Kgotso-Koete/pilomar/docs/OBSOLETE_Legacy_Bill_of_Materials.pdf

Source | | R1,409.70

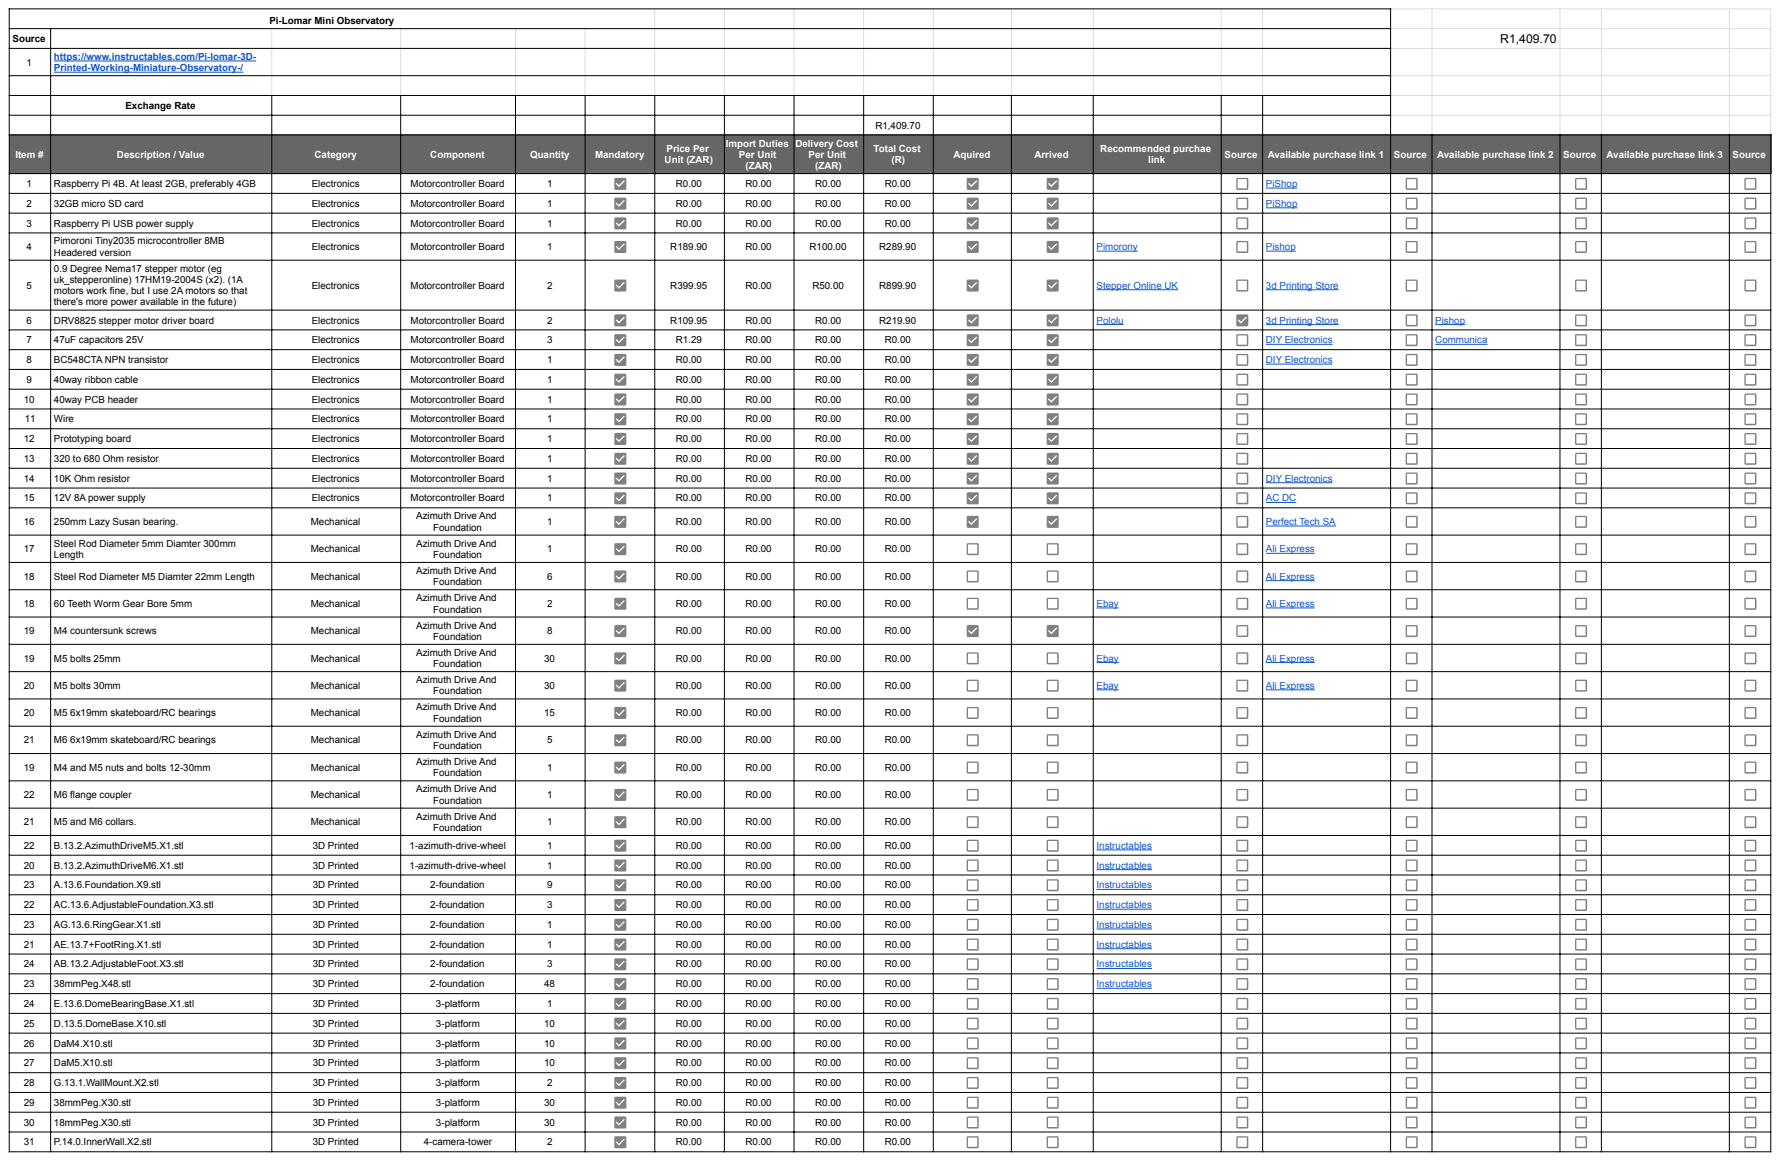
[picture p1: page 1]

Pi-Lomar Mini Observatory

1 | https://www.instructables.com/Pi-lomar-3D- Printed-Working-Miniature-Observatory-/

Exchange Rate

Item # | Description / Value | Category | Component | Quantity | Mandatory | Price Per Unit (ZAR) | Import Duties Per Unit (ZAR) | Delivery Cost Per Unit (ZAR) | Total Cost (R) | Aquired | Arrived | Recommended purchae link | Source | Available purchase link 1 | Source | Available purchase link 2 | Source | Available purchase link 3 | Source

1 | Raspberry Pi 4B. At least 2GB, preferably 4GB | Electronics | Motorcontroller Board | 1 | | R0.00 | R0.00 | R0.00 | R0.00 | | | | | PiShop (https://www.pishop.co.za/store/raspberry-pi-4-model-b-4gb?keyword=raspberry%20pi%204%204%20gb&category_id=0)

2 | 32GB micro SD card | Electronics | Motorcontroller Board | 1 | | R0.00 | R0.00 | R0.00 | R0.00 | | | | | PiShop (https://www.pishop.co.za/store/sandisk-ultra-microsdhc-32gb-uhs-i-100mbs-class10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)

3 | Raspberry Pi USB power supply | Electronics | Motorcontroller Board | 1 | | R0.00 | R0.00 | R0.00 | R0.00
4 | Pimoroni Tiny2035 microcontroller 8MB Headered version | Electronics | Motorcontroller Board | 1 | | R189.90 | R0.00 | R100.00 | R289.90 | | | Pimorony (https://shop.pimoroni.com/products/tiny-2040?variant=39560012267603) | | Pishop (https://www.pishop.co.za/store/tiny-2350-by-pimoroni?key=3528)

5 | 0.9 Degree Nema17 stepper motor (eg uk_stepperonline) 17HM19-2004S (x2). (1A motors work fine, but I use 2A motors so that there's more power available in the future) | Electronics | Motorcontroller Board | 2 | | R399.95 | R0.00 | R50.00 | R899.90 | | | Stepper Online UK (https://www.stepperonline.co.uk/nema-17-bipolar-0-9deg-46ncm-65-1oz-in-2a-42x42x48mm-4-wires-17hm19-2004s.html) | | 3d Printing Store (https://3dprintingstore.co.za/products/stepper-motor-nema-17-x-48mm-0-9-deg-step)

6 | DRV8825 stepper motor driver board | Electronics | Motorcontroller Board | 2 | | R109.95 | R0.00 | R0.00 | R219.90 | | | Pololu (https://www.pololu.com/product/2133) | | 3d Printing Store (https://3dprintingstore.co.za/products/stepper-motor-driver-drv8825-with-heat-sink?_pos=1&_sid=9cb2bcf2d&_ss=r) | | Pishop (https://www.pishop.co.za/store/3d-printer-stepstick-drv8825-stepper-motor-driver)

7 | 47uF capacitors 25V | Electronics | Motorcontroller Board | 3 | | R1.29 | R0.00 | R0.00 | R0.00 | | | | | DIY Electronics (https://www.diyelectronics.co.za/store/capacitors/4124-47uf-25v-electrolytic-capacitor.html) | | Communica (https://www.communica.co.za/products/47uf-25ves6-3x5-4)

8 | BC548CTA NPN transistor | Electronics | Motorcontroller Board | 1 | | R0.00 | R0.00 | R0.00 | R0.00 | | | | | DIY Electronics (https://www.diyelectronics.co.za/store/prototyping/6129-bc547b-npn-general-purpose-transistor-100ma-45v.html)

9 | 40way ribbon cable | Electronics | Motorcontroller Board | 1 | | R0.00 | R0.00 | R0.00 | R0.00

10 | 40way PCB header | Electronics | Motorcontroller Board | 1 | | R0.00 | R0.00 | R0.00 | R0.00

11 | Wire | Electronics | Motorcontroller Board | 1 | | R0.00 | R0.00 | R0.00 | R0.00

12 | Prototyping board | Electronics | Motorcontroller Board | 1 | | R0.00 | R0.00 | R0.00 | R0.00

13 | 320 to 680 Ohm resistor | Electronics | Motorcontroller Board | 1 | | R0.00 | R0.00 | R0.00 | R0.00

14 | 10K Ohm resistor | Electronics | Motorcontroller Board | 1 | | R0.00 | R0.00 | R0.00 | R0.00 | | | | | DIY Electronics (https://www.diyelectronics.co.za/store/resistors/1582-resistor-10k-ohm-14w-5.html)

15 | 12V 8A power supply | Electronics | Motorcontroller Board | 1 | | R0.00 | R0.00 | R0.00 | R0.00 | | | | | AC DC (https://acdc.co.za/batteries-chargers-power-supplies-avrs-upss/31475-mains-psu-230vac-12vdc-8a-b-plug-10va.html)
16 | 250mm Lazy Susan bearing. | Mechanical | Azimuth Drive And Foundation | 1 | | R0.00 | R0.00 | R0.00 | R0.00 | | | | | Perfect Tech SA (https://perfecttech.co.za/product/metal-swivel-turn-plate-for-rotating-table/)

17 | Steel Rod Diameter 5mm Diamter 300mm Length | Mechanical | Azimuth Drive And Foundation | 1 | | R0.00 | R0.00 | R0.00 | R0.00 | | | | | Ali Express (http://aliexpress.com/item/1005009347568195.html?mp=1)

18 | Steel Rod Diameter M5 Diamter 22mm Length | Mechanical | Azimuth Drive And Foundation | 6 | | R0.00 | R0.00 | R0.00 | R0.00 | | | | | Ali Express (https://www.aliexpress.com/item/1005009021799814.html?mp=1)

18 | 60 Teeth Worm Gear Bore 5mm | Mechanical | Azimuth Drive And Foundation | 2 | | R0.00 | R0.00 | R0.00 | R0.00 | | | Ebay (https://www.ebay.co.uk/itm/305751282028) | | Ali Express (https://www.aliexpress.com/item/1005009021799814.html?curPageLogUid=dJdaDykwoOhg)

19 | M4 countersunk screws | Mechanical | Azimuth Drive And Foundation | 8 | | R0.00 | R0.00 | R0.00 | R0.00

19 | M5 bolts 25mm | Mechanical | Azimuth Drive And Foundation | 30 | | R0.00 | R0.00 | R0.00 | R0.00 | | | Ebay (https://www.ebay.co.uk/itm/321232365051) | | Ali Express (https://www.aliexpress.com/item/1005006713197144.html?scm_id=1007.40050.354490.0&scm-url=1007.40050.354490.0)

20 | M5 bolts 30mm | Mechanical | Azimuth Drive And Foundation | 30 | | R0.00 | R0.00 | R0.00 | R0.00 | | | Ebay (https://www.ebay.co.uk/itm/321232365051) | | Ali Express (https://www.aliexpress.com/item/1005006713197144.html?scm_id=1007.40050.354490.0&scm-url=1007.40050.354490.0)

20 | M5 6x19mm skateboard/RC bearings | Mechanical | Azimuth Drive And Foundation | 15 | | R0.00 | R0.00 | R0.00 | R0.00

21 | M6 6x19mm skateboard/RC bearings | Mechanical | Azimuth Drive And Foundation | 5 | | R0.00 | R0.00 | R0.00 | R0.00

19 | M4 and M5 nuts and bolts 12-30mm | Mechanical | Azimuth Drive And Foundation | 1 | | R0.00 | R0.00 | R0.00 | R0.00

22 | M6 flange coupler | Mechanical | Azimuth Drive And Foundation | 1 | | R0.00 | R0.00 | R0.00 | R0.00

21 | M5 and M6 collars. | Mechanical | Azimuth Drive And Foundation | 1 | | R0.00 | R0.00 | R0.00 | R0.00

22 | B.13.2.AzimuthDriveM5.X1.stl | 3D Printed | 1-azimuth-drive-wheel | 1 | | R0.00 | R0.00 | R0.00 | R0.00 | | | Instructables (https://content.instructables.com/F7O/A6UB/LD33SM68/F7OA6UBLD33SM68.stl)

20 | B.13.2.AzimuthDriveM6.X1.stl | 3D Printed | 1-azimuth-drive-wheel | 1 | | R0.00 | R0.00 | R0.00 | R0.00 | | | Instructables (https://content.instructables.com/FKP/K26I/LD33SM69/FKPK26ILD33SM69.stl)

23 | A.13.6.Foundation.X9.stl | 3D Printed | 2-foundation | 9 | | R0.00 | R0.00 | R0.00 | R0.00 | | | Instructables (https://content.instructables.com/FZG/956D/LD33SM5Z/FZG956DLD33SM5Z.stl)

22 | AC.13.6.AdjustableFoundation.X3.stl | 3D Printed | 2-foundation | 3 | | R0.00 | R0.00 | R0.00 | R0.00 | | | Instructables (https://content.instructables.com/FTZ/H02S/LD33SM65/FTZH02SLD33SM65.stl)

23 | AG.13.6.RingGear.X1.stl | 3D Printed | 2-foundation | 1 | | R0.00 | R0.00 | R0.00 | R0.00 | | | Instructables (https://content.instructables.com/F95/JYJI/LD33SM67/F95JYJILD33SM67.stl)

21 | AE.13.7+FootRing.X1.stl | 3D Printed | 2-foundation | 1 | | R0.00 | R0.00 | R0.00 | R0.00 | | | Instructables (https://content.instructables.com/FTZ/H02S/LD33SM65/FTZH02SLD33SM65.stl)

24 | AB.13.2.AdjustableFoot.X3.stl | 3D Printed | 2-foundation | 3 | | R0.00 | R0.00 | R0.00 | R0.00 | | | Instructables (https://content.instructables.com/FGK/MHMJ/LD33SM61/FGKMHMJLD33SM61.stl)

23 | 38mmPeg.X48.stl | 3D Printed | 2-foundation | 48 | | R0.00 | R0.00 | R0.00 | R0.00 | | | Instructables (https://content.instructables.com/FC5/TMM4/LD33SM5Y/FC5TMM4LD33SM5Y.stl)

24 | E.13.6.DomeBearingBase.X1.stl | 3D Printed | 3-platform | 1 | | R0.00 | R0.00 | R0.00 | R0.00

25 | D.13.5.DomeBase.X10.stl | 3D Printed | 3-platform | 10 | | R0.00 | R0.00 | R0.00 | R0.00

26 | DaM4.X10.stl | 3D Printed | 3-platform | 10 | | R0.00 | R0.00 | R0.00 | R0.00

27 | DaM5.X10.stl | 3D Printed | 3-platform | 10 | | R0.00 | R0.00 | R0.00 | R0.00

28 | G.13.1.WallMount.X2.stl | 3D Printed | 3-platform | 2 | | R0.00 | R0.00 | R0.00 | R0.00

29 | 38mmPeg.X30.stl | 3D Printed | 3-platform | 30 | | R0.00 | R0.00 | R0.00 | R0.00

30 | 18mmPeg.X30.stl | 3D Printed | 3-platform | 30 | | R0.00 | R0.00 | R0.00 | R0.00

31 | P.14.0.InnerWall.X2.stl | 3D Printed | 4-camera-tower | 2 | | R0.00 | R0.00 | R0.00 | R0.00

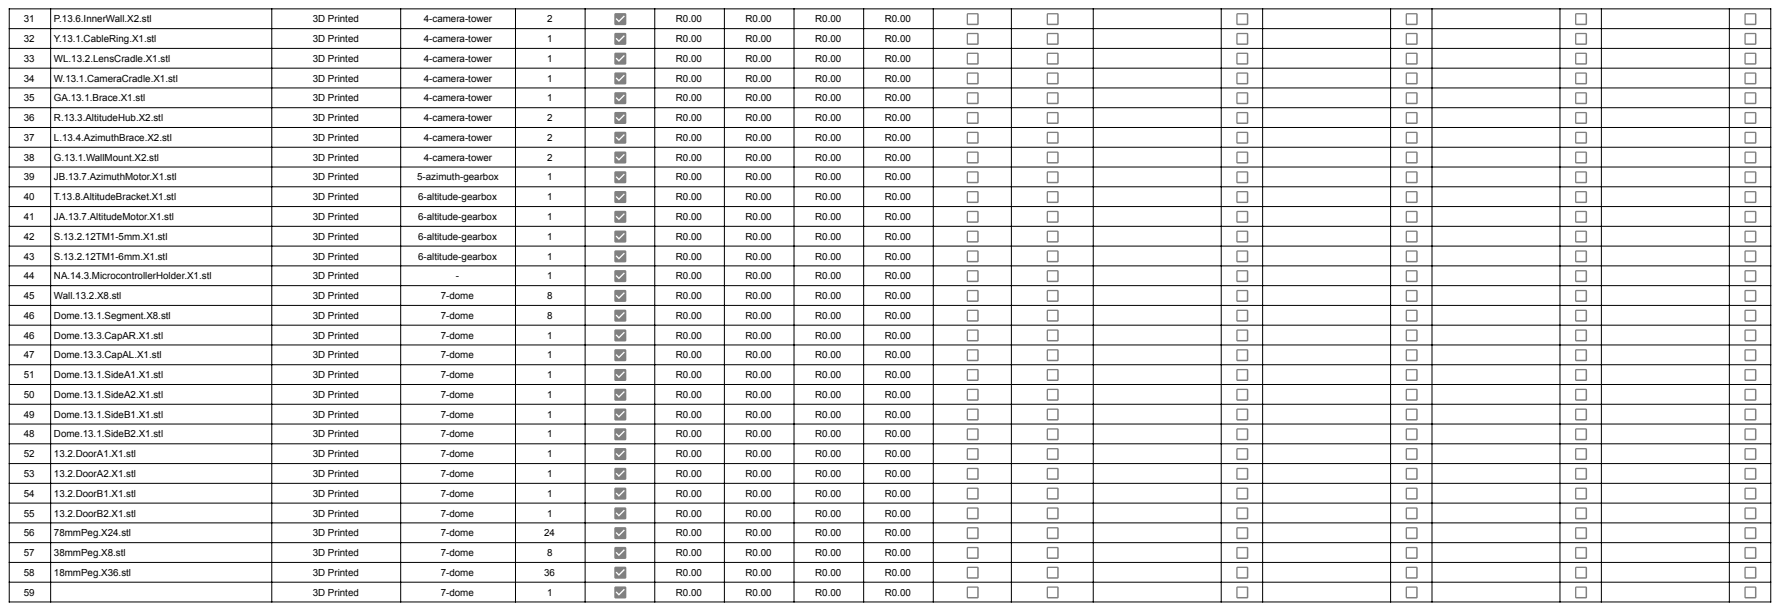
[picture p2: page 2]

31 | P.13.6.InnerWall.X2.stl | 3D Printed | 4-camera-tower | 2 | R0.00 | R0.00 | R0.00 | R0.00

32 | Y.13.1.CableRing.X1.stl | 3D Printed | 4-camera-tower | 1 | R0.00 | R0.00 | R0.00 | R0.00

33 | WL.13.2.LensCradle.X1.stl | 3D Printed | 4-camera-tower | 1 | R0.00 | R0.00 | R0.00 | R0.00

34 | W.13.1.CameraCradle.X1.stl | 3D Printed | 4-camera-tower | 1 | R0.00 | R0.00 | R0.00 | R0.00

35 | GA.13.1.Brace.X1.stl | 3D Printed | 4-camera-tower | 1 | R0.00 | R0.00 | R0.00 | R0.00

36 | R.13.3.AltitudeHub.X2.stl | 3D Printed | 4-camera-tower | 2 | R0.00 | R0.00 | R0.00 | R0.00

37 | L.13.4.AzimuthBrace.X2.stl | 3D Printed | 4-camera-tower | 2 | R0.00 | R0.00 | R0.00 | R0.00

38 | G.13.1.WallMount.X2.stl | 3D Printed | 4-camera-tower | 2 | R0.00 | R0.00 | R0.00 | R0.00

39 | JB.13.7.AzimuthMotor.X1.stl | 3D Printed | 5-azimuth-gearbox | 1 | R0.00 | R0.00 | R0.00 | R0.00

40 | T.13.8.AltitudeBracket.X1.stl | 3D Printed | 6-altitude-gearbox | 1 | R0.00 | R0.00 | R0.00 | R0.00

41 | JA.13.7.AltitudeMotor.X1.stl | 3D Printed | 6-altitude-gearbox | 1 | R0.00 | R0.00 | R0.00 | R0.00

42 | S.13.2.12TM1-5mm.X1.stl | 3D Printed | 6-altitude-gearbox | 1 | R0.00 | R0.00 | R0.00 | R0.00

43 | S.13.2.12TM1-6mm.X1.stl | 3D Printed | 6-altitude-gearbox | 1 | R0.00 | R0.00 | R0.00 | R0.00

44 | NA.14.3.MicrocontrollerHolder.X1.stl | 3D Printed | - | 1 | R0.00 | R0.00 | R0.00 | R0.00

45 | Wall.13.2.X8.stl | 3D Printed | 7-dome | 8 | R0.00 | R0.00 | R0.00 | R0.00

46 | Dome.13.1.Segment.X8.stl | 3D Printed | 7-dome | 8 | R0.00 | R0.00 | R0.00 | R0.00

46 | Dome.13.3.CapAR.X1.stl | 3D Printed | 7-dome | 1 | R0.00 | R0.00 | R0.00 | R0.00

47 | Dome.13.3.CapAL.X1.stl | 3D Printed | 7-dome | 1 | R0.00 | R0.00 | R0.00 | R0.00

51 | Dome.13.1.SideA1.X1.stl | 3D Printed | 7-dome | 1 | R0.00 | R0.00 | R0.00 | R0.00

50 | Dome.13.1.SideA2.X1.stl | 3D Printed | 7-dome | 1 | R0.00 | R0.00 | R0.00 | R0.00

49 | Dome.13.1.SideB1.X1.stl | 3D Printed | 7-dome | 1 | R0.00 | R0.00 | R0.00 | R0.00

48 | Dome.13.1.SideB2.X1.stl | 3D Printed | 7-dome | 1 | R0.00 | R0.00 | R0.00 | R0.00

52 | 13.2.DoorA1.X1.stl | 3D Printed | 7-dome | 1 | R0.00 | R0.00 | R0.00 | R0.00

53 | 13.2.DoorA2.X1.stl | 3D Printed | 7-dome | 1 | R0.00 | R0.00 | R0.00 | R0.00

54 | 13.2.DoorB1.X1.stl | 3D Printed | 7-dome | 1 | R0.00 | R0.00 | R0.00 | R0.00

55 | 13.2.DoorB2.X1.stl | 3D Printed | 7-dome | 1 | R0.00 | R0.00 | R0.00 | R0.00

56 | 78mmPeg.X24.stl | 3D Printed | 7-dome | 24 | R0.00 | R0.00 | R0.00 | R0.00

57 | 38mmPeg.X8.stl | 3D Printed | 7-dome | 8 | R0.00 | R0.00 | R0.00 | R0.00

58 | 18mmPeg.X36.stl | 3D Printed | 7-dome | 36 | R0.00 | R0.00 | R0.00 | R0.00

59 | | 3D Printed | 7-dome | 1 | R0.00 | R0.00 | R0.00 | R0.00
