Kgotso-Koete/pilomar/3d-printed-parts/1-azimuth-drive-wheel/B.13.2.AzimuthDriveM5.X1.stl

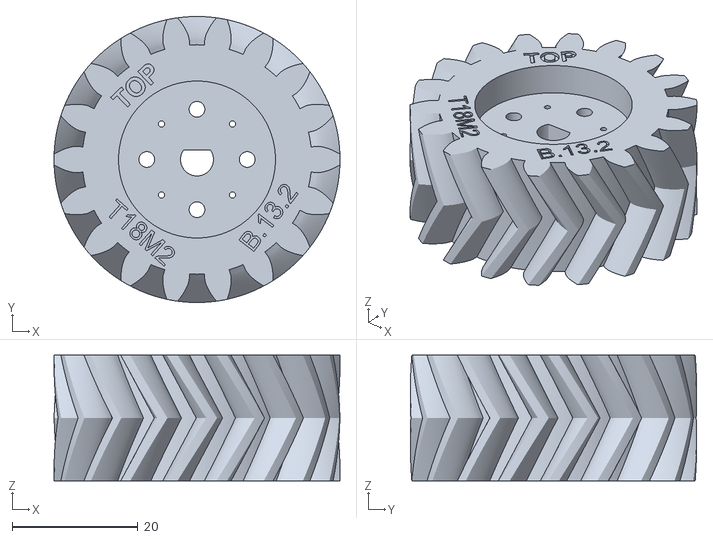
[picture p3: CAD file, 2026-11-02]
3d-printed-parts/1-azimuth-drive-wheel/B.13.2.AzimuthDriveM5.X1.stl
45.6 x 45.6 x 20.0
