Kgotso-Koete/pilomar/3d-printed-parts/2-foundation/A.13.6.Foundation.X9.stl

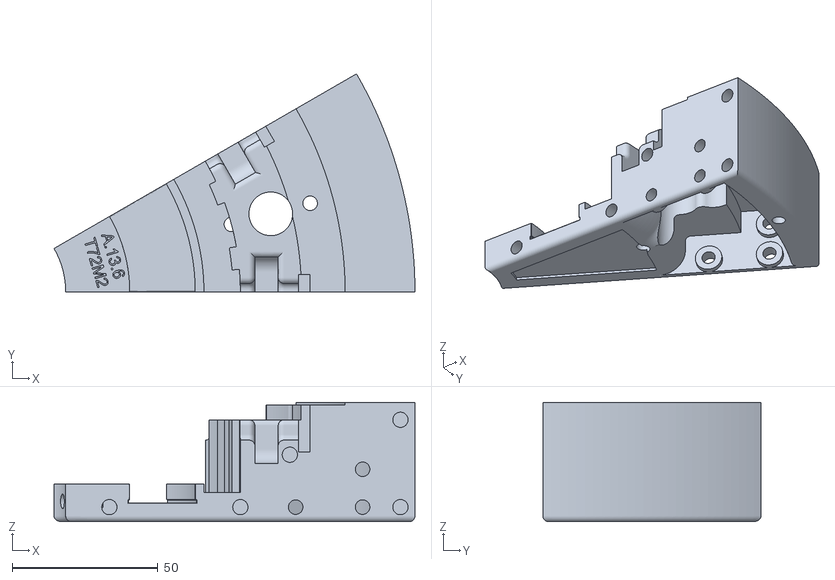
[picture p4: CAD file, 2026-11-02]
3d-printed-parts/2-foundation/A.13.6.Foundation.X9.stl
124.0 x 75.0 x 41.0
