Kgotso-Koete/pilomar/3d-printed-parts/3-platform/DaM4.X10.stl

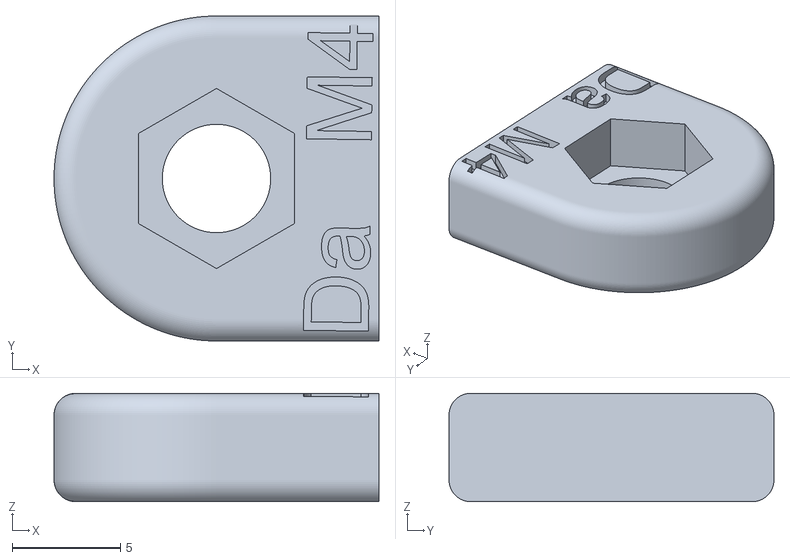
[picture p5: CAD file, 2026-11-02]
3d-printed-parts/3-platform/DaM4.X10.stl
15.0 x 15.0 x 5.00
