Kgotso-Koete/pilomar/3d-printed-parts/4-camera-tower/W.13.1.CameraCradle.X1.stl

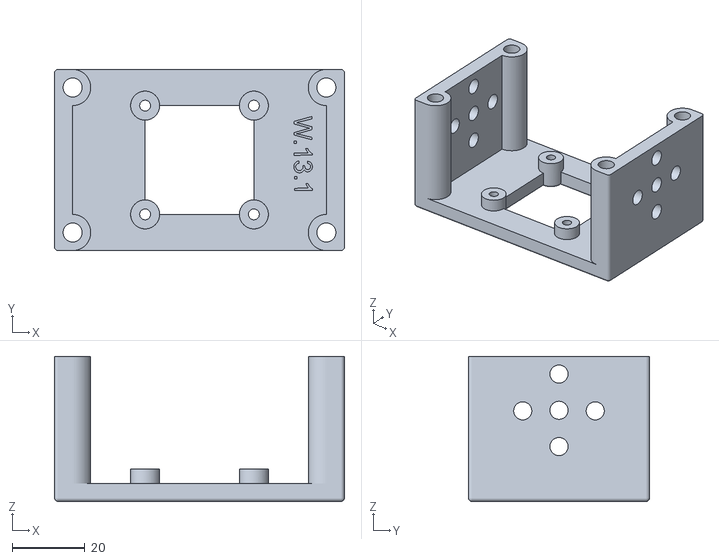
[picture p6: CAD file, 2026-11-02]
3d-printed-parts/4-camera-tower/W.13.1.CameraCradle.X1.stl
80.0 x 50.0 x 40.0
