Kgotso-Koete/pilomar/3d-printed-parts/5-azimuth-gearbox/JB.13.7.AzimuthMotor.X1.stl

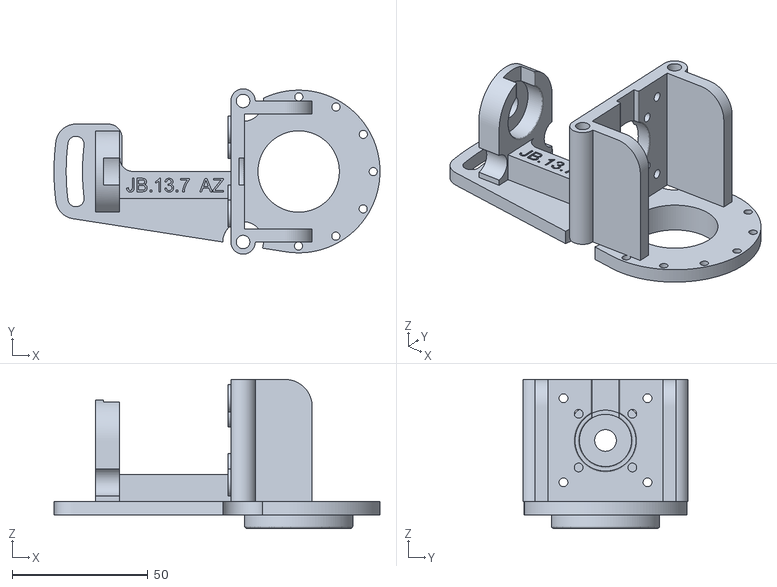
[picture p7: CAD file, 2026-11-02]
3d-printed-parts/5-azimuth-gearbox/JB.13.7.AzimuthMotor.X1.stl
120.2 x 61.0 x 55.0
