Kgotso-Koete/pilomar/3d-printed-parts/6-altitude-gearbox/S.13.2.12TM1-6mm.X1.stl

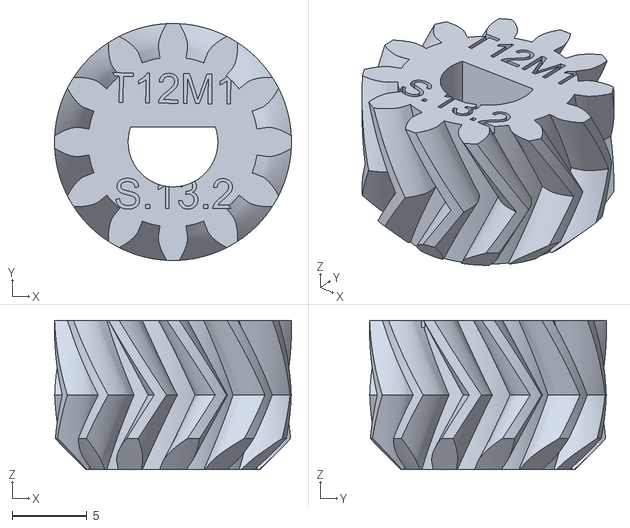
[picture p8: CAD file, 2026-11-02]
3d-printed-parts/6-altitude-gearbox/S.13.2.12TM1-6mm.X1.stl
15.9 x 15.9 x 10.0
