Kgotso-Koete/pilomar/3d-printed-parts/7-dome/13.2.DoorB2.X1.stl

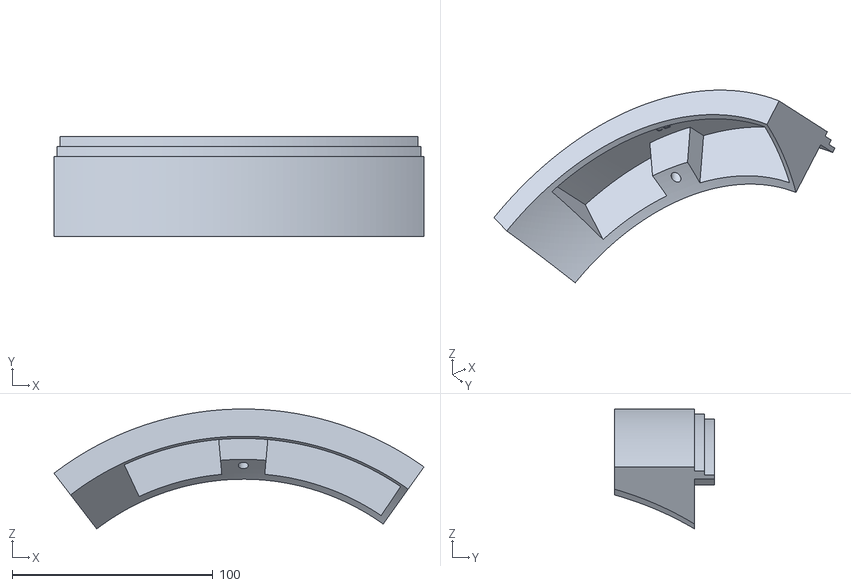
[picture p9: CAD file, 2026-11-02]
3d-printed-parts/7-dome/13.2.DoorB2.X1.stl
184.4 x 50.0 x 59.8
