Kgotso-Koete/pilomar/3d-printed-parts/NA.14.3.MicrocontrollerHolder.X1.stl

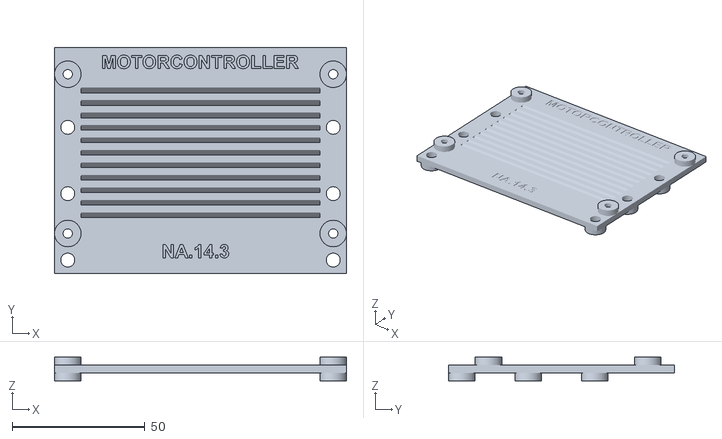
[picture p10: CAD file, 2026-11-02]
3d-printed-parts/NA.14.3.MicrocontrollerHolder.X1.stl
110.0 x 85.0 x 9.00
