Kgotso-Koete/pilomar/3d-printed-parts/2-foundation/AB.13.2.AdjustableFoot.X3.stl

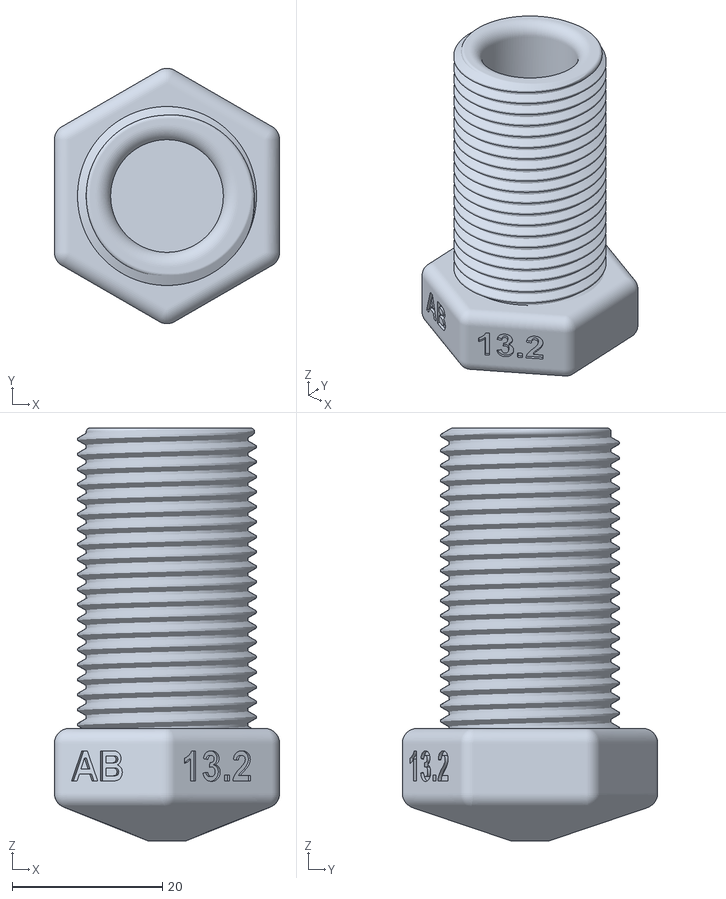
[picture p11: CAD file, 2026-11-02]
3d-printed-parts/2-foundation/AB.13.2.AdjustableFoot.X3.stl
30.0 x 34.0 x 55.0
