Kgotso-Koete/pilomar/3d-printed-parts/3-platform/18mmPeg.X30.stl

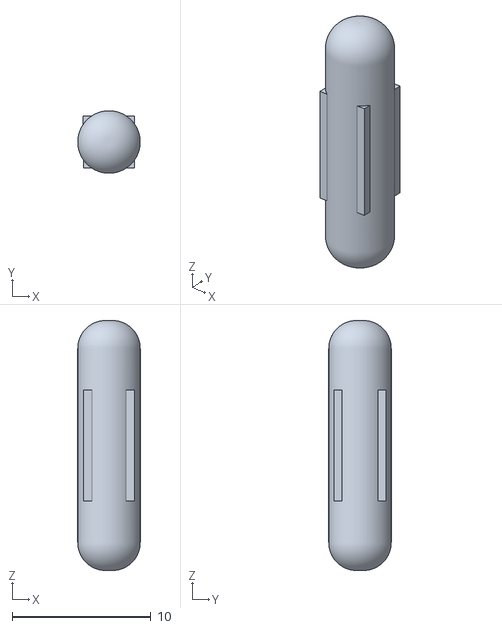
[picture p12: CAD file, 2026-11-02]
3d-printed-parts/3-platform/18mmPeg.X30.stl
4.50 x 4.50 x 18.0
