Kgotso-Koete/pilomar/3d-printed-parts/4-camera-tower/P.13.6.InnerWall.X2.stl

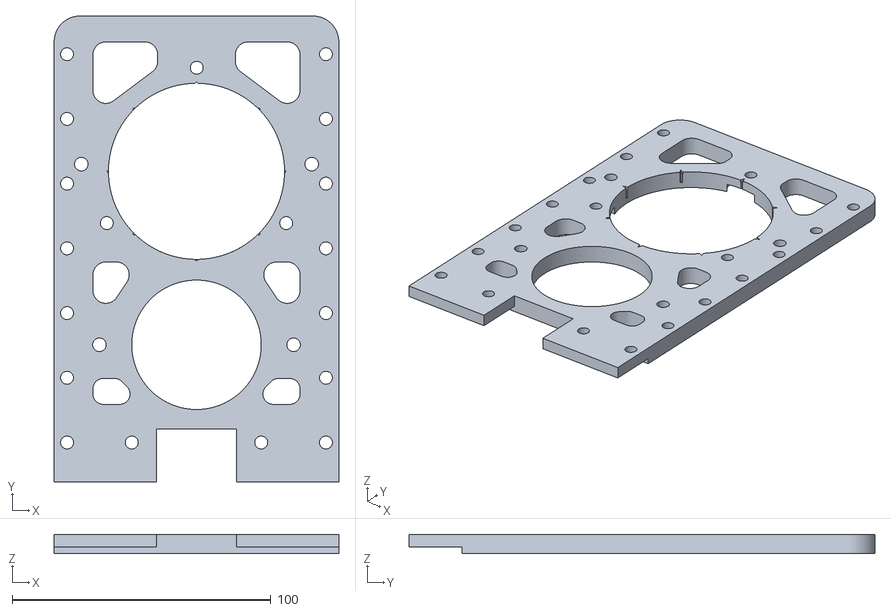
[picture p13: CAD file, 2026-11-02]
3d-printed-parts/4-camera-tower/P.13.6.InnerWall.X2.stl
110.0 x 180.0 x 7.50
