Kgotso-Koete/pilomar/3d-printed-parts/6-altitude-gearbox/T.13.8.AltitudeBracket.X1.stl

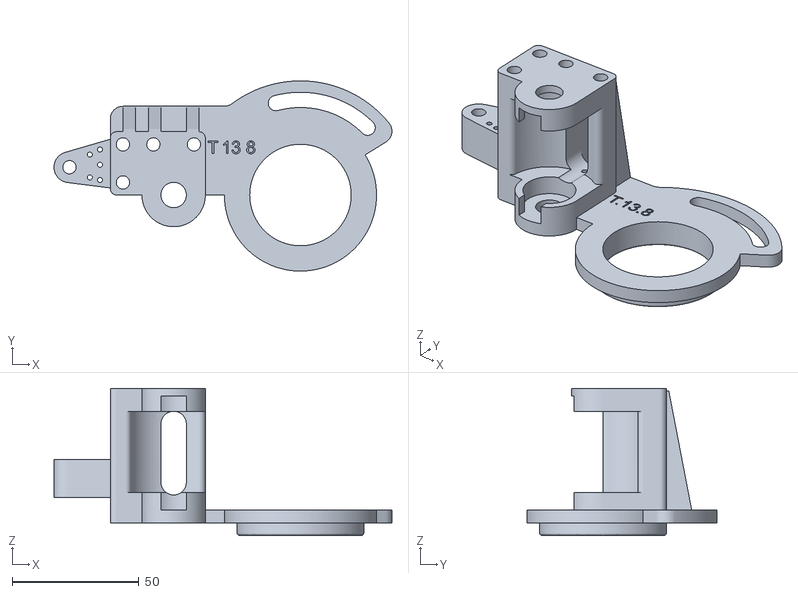
[picture p14: CAD file, 2026-11-02]
3d-printed-parts/6-altitude-gearbox/T.13.8.AltitudeBracket.X1.stl
133.3 x 75.0 x 58.0
