Kgotso-Koete/pilomar/3d-printed-parts/7-dome/78mmPeg.X24.stl

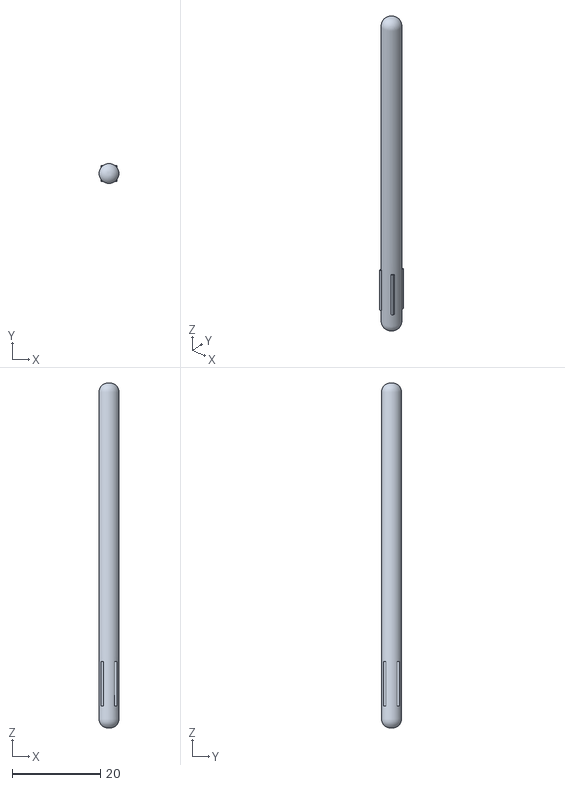
[picture p15: CAD file, 2026-11-02]
3d-printed-parts/7-dome/78mmPeg.X24.stl
4.50 x 4.49 x 78.0
