Kgotso-Koete/pilomar/3d-printed-parts/2-foundation/AC.13.6.AdjustableFoundation.X3.stl

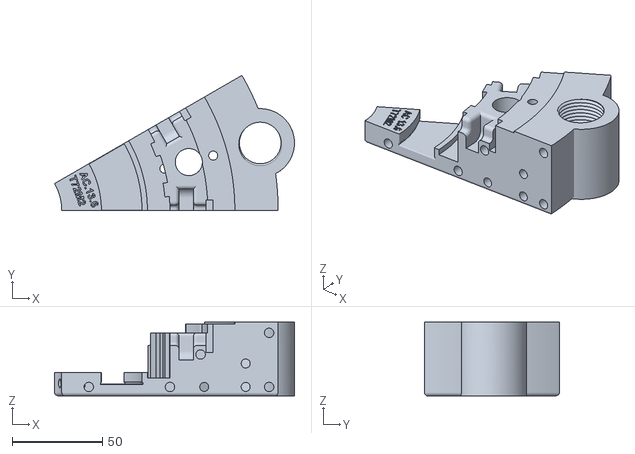
[picture p16: CAD file, 2026-11-02]
3d-printed-parts/2-foundation/AC.13.6.AdjustableFoundation.X3.stl
133.1 x 75.0 x 41.0
