Kgotso-Koete/pilomar/3d-printed-parts/4-camera-tower/P.14.0.InnerWall.X2.stl

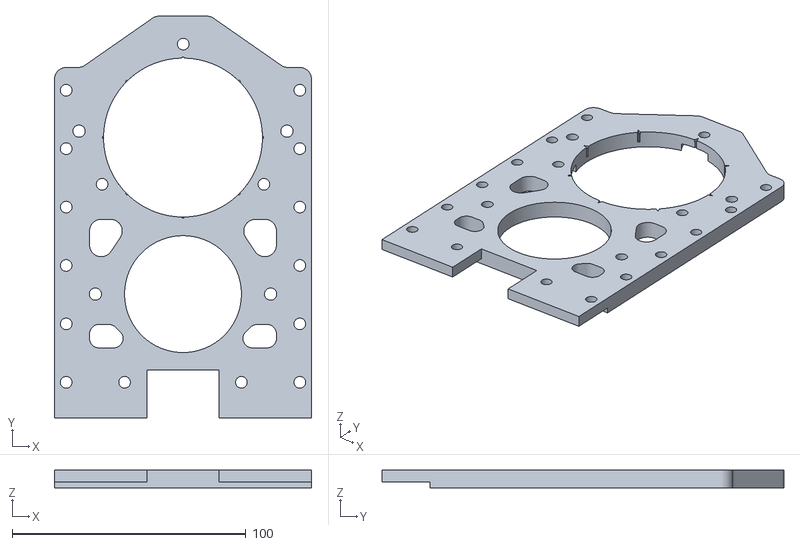
[picture p18: CAD file, 2026-11-02]
3d-printed-parts/4-camera-tower/P.14.0.InnerWall.X2.stl
110.0 x 172.0 x 7.50
