Kgotso-Koete/pilomar/3d-printed-parts/6-altitude-gearbox/JA.13.7.AltitudeMotor.X1.stl

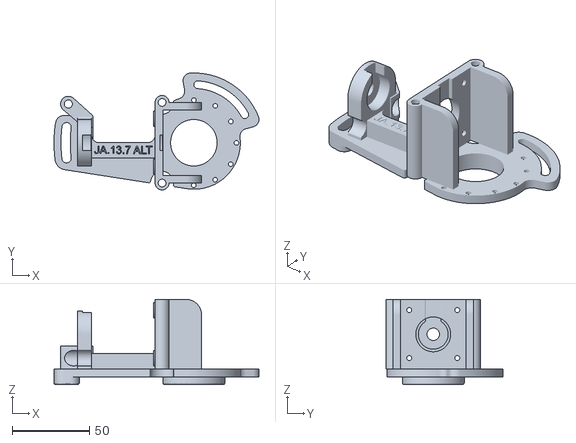
[picture p19: CAD file, 2026-11-02]
3d-printed-parts/6-altitude-gearbox/JA.13.7.AltitudeMotor.X1.stl
132.3 x 75.5 x 55.0
