Kgotso-Koete/pilomar/3d-printed-parts/7-dome/Dome.13.1.SideA2.X1.stl

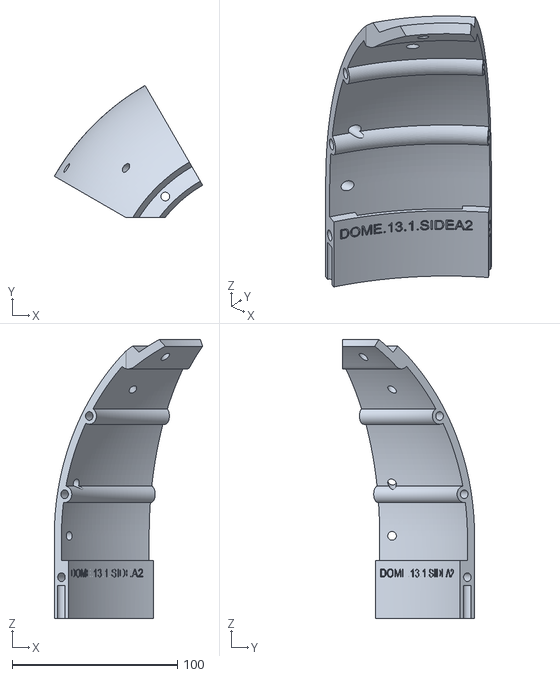
[picture p20: CAD file, 2026-11-02]
3d-printed-parts/7-dome/Dome.13.1.SideA2.X1.stl
89.8 x 79.9 x 168.8
