Kgotso-Koete/pilomar/3d-printed-parts/2-foundation/AG.13.6.RingGear.X1.stl

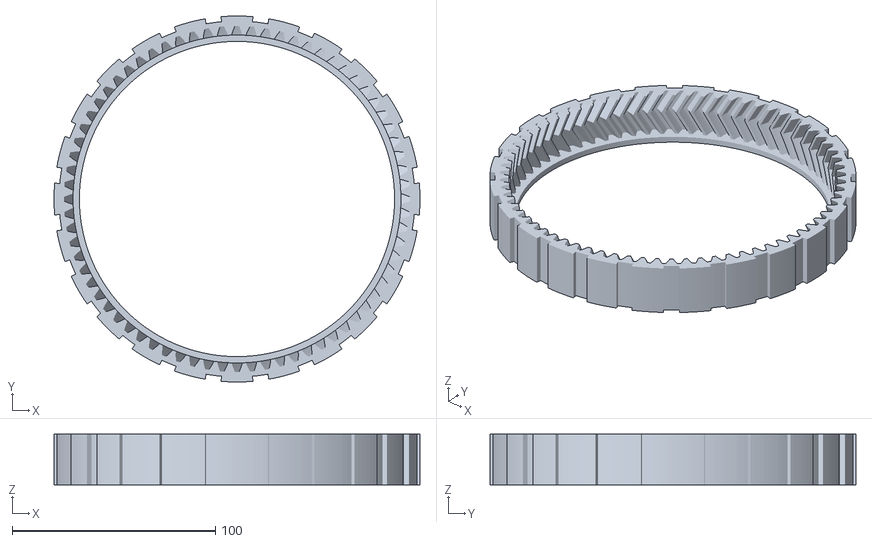
[picture p21: CAD file, 2026-11-02]
3d-printed-parts/2-foundation/AG.13.6.RingGear.X1.stl
180.0 x 180.0 x 25.0
