Kgotso-Koete/pilomar/3d-printed-parts/3-platform/E.13.6.DomeBearingBase.X1.stl

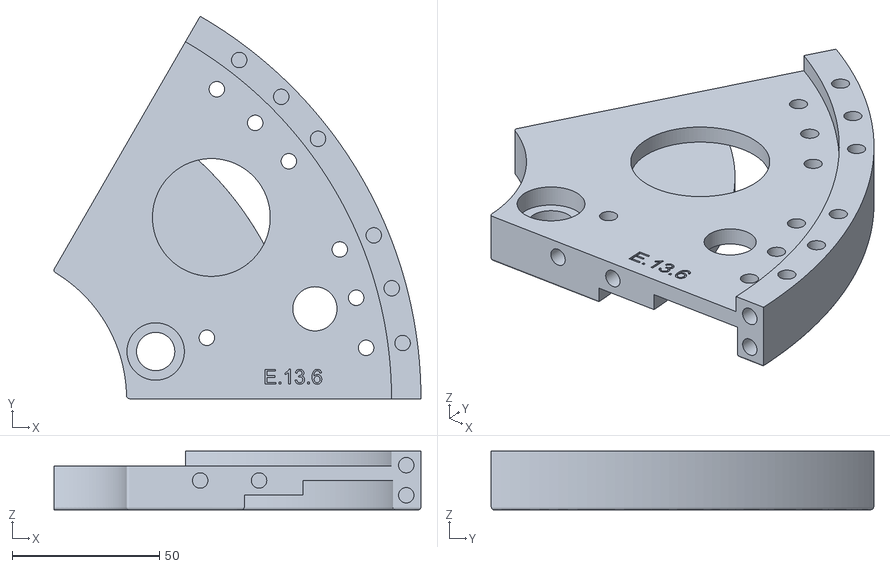
[picture p22: CAD file, 2026-11-02]
3d-printed-parts/3-platform/E.13.6.DomeBearingBase.X1.stl
124.6 x 129.9 x 20.0
