Kgotso-Koete/pilomar/3d-printed-parts/4-camera-tower/R.13.3.AltitudeHub.X2.stl

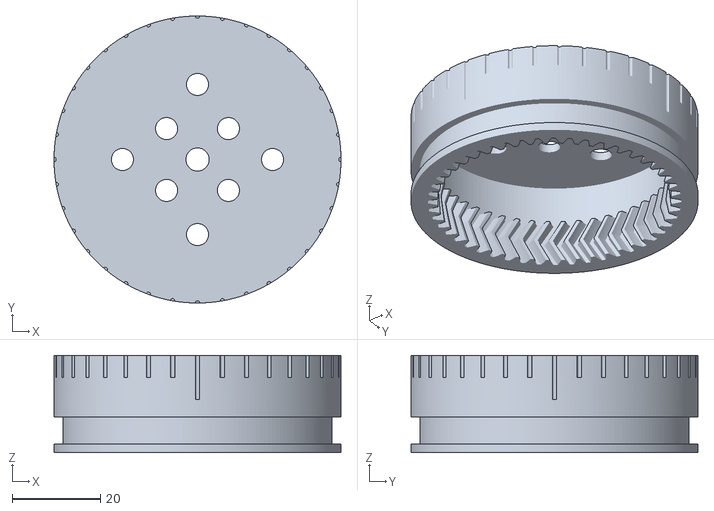
[picture p23: CAD file, 2026-11-02]
3d-printed-parts/4-camera-tower/R.13.3.AltitudeHub.X2.stl
65.0 x 65.0 x 22.0
