Kgotso-Koete/pilomar/3d-printed-parts/7-dome/Dome.13.3.CapAL.X1.stl

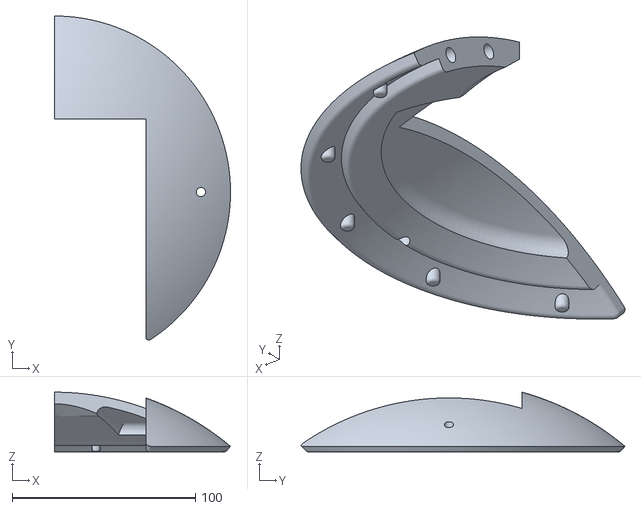
[picture p24: CAD file, 2026-11-02]
3d-printed-parts/7-dome/Dome.13.3.CapAL.X1.stl
96.2 x 177.0 x 32.6
