Kgotso-Koete/pilomar/3d-printed-parts/2-foundation/AE.13.7+FootRing.X1.stl

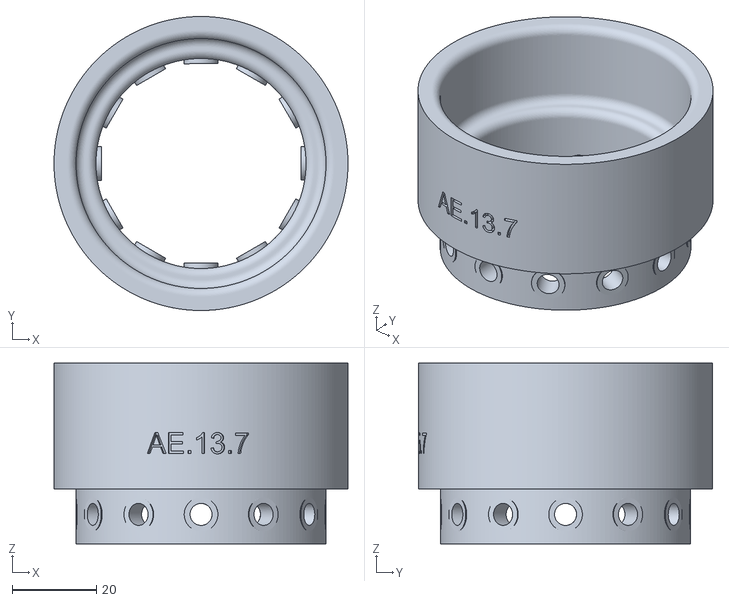
[picture p25: CAD file, 2026-11-02]
3d-printed-parts/2-foundation/AE.13.7+FootRing.X1.stl
70.0 x 70.0 x 43.0
