Kgotso-Koete/pilomar/3d-printed-parts/3-platform/D.13.5.DomeBase.X10.stl

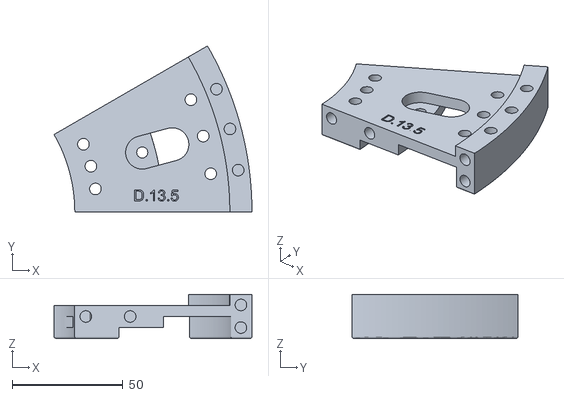
[picture p26: CAD file, 2026-11-02]
3d-printed-parts/3-platform/D.13.5.DomeBase.X10.stl
89.4 x 75.0 x 20.0
