Kgotso-Koete/pilomar/3d-printed-parts/4-camera-tower/WL.13.2.LensCradle.X1.stl

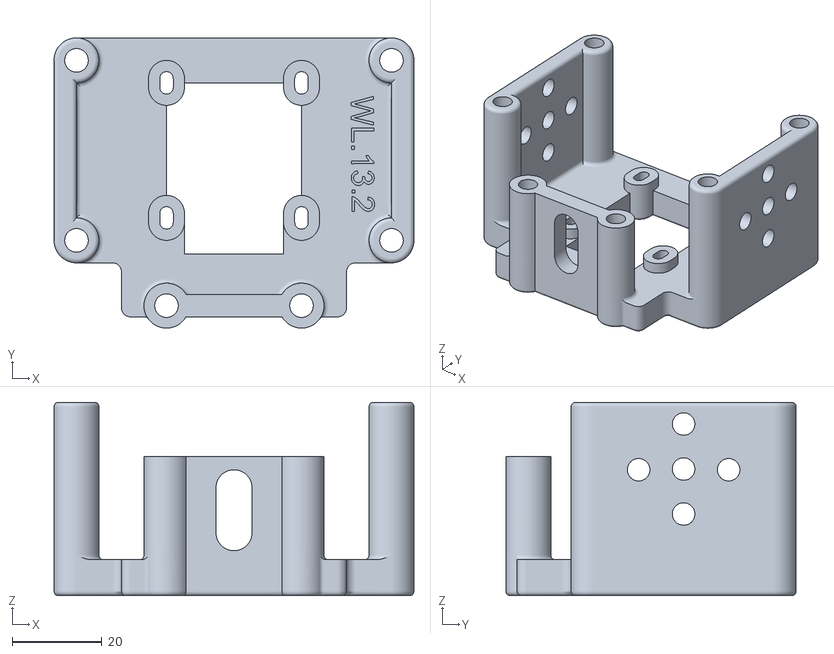
[picture p27: CAD file, 2026-11-02]
3d-printed-parts/4-camera-tower/WL.13.2.LensCradle.X1.stl
80.0 x 64.5 x 43.0
