Kgotso-Koete/pilomar/3d-printed-parts/4-camera-tower/L.13.4.AzimuthBrace.X2.stl

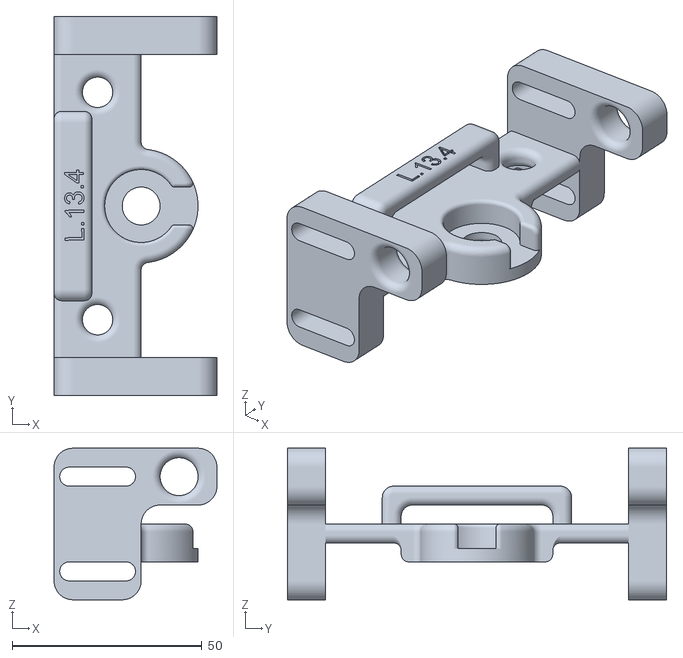
[picture p29: CAD file, 2026-11-02]
3d-printed-parts/4-camera-tower/L.13.4.AzimuthBrace.X2.stl
43.0 x 100.0 x 40.0
