Kgotso-Koete/pilomar/3d-printed-parts/7-dome/Dome.13.1.SideA1.X1.stl

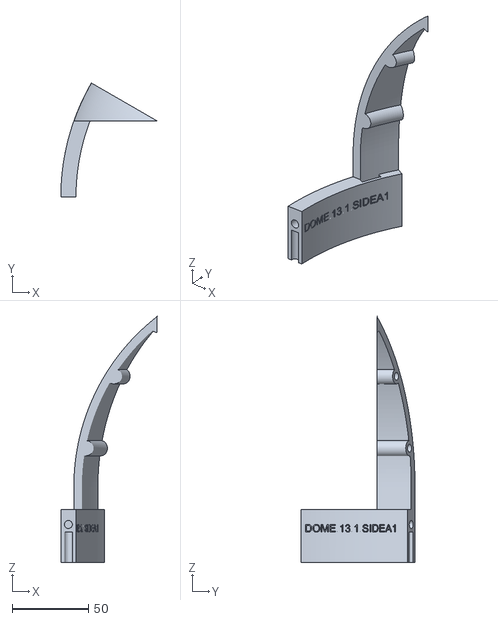
[picture p30: CAD file, 2026-11-02]
3d-printed-parts/7-dome/Dome.13.1.SideA1.X1.stl
63.4 x 75.0 x 161.8
