Kgotso-Koete/pilomar/3d-printed-parts/3-platform/G.13.1.WallMount.X2.stl

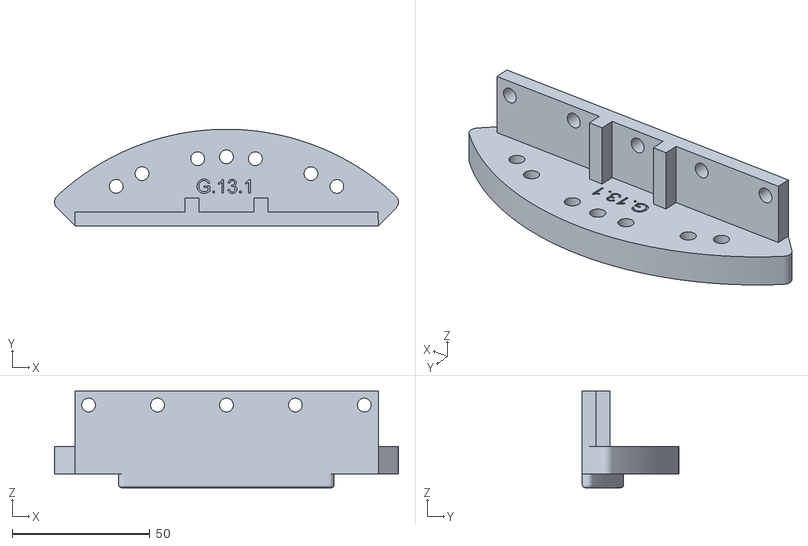
[picture p31: CAD file, 2026-11-02]
3d-printed-parts/3-platform/G.13.1.WallMount.X2.stl
124.8 x 35.0 x 35.0
