Kgotso-Koete/pilomar/3d-printed-parts/4-camera-tower/Y.13.1.CableRing.X1.stl

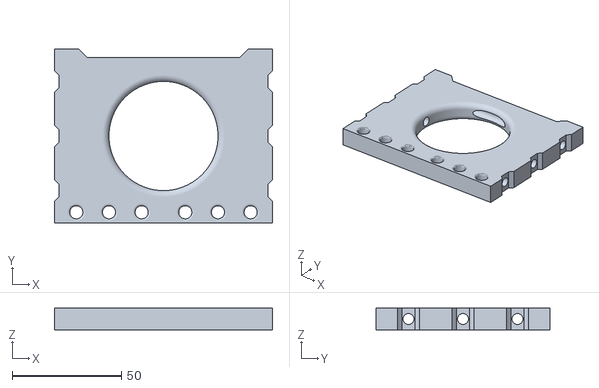
[picture p32: CAD file, 2026-11-02]
3d-printed-parts/4-camera-tower/Y.13.1.CableRing.X1.stl
100.0 x 80.0 x 10.0
