Kgotso-Koete/pilomar/3d-printed-parts/4-camera-tower/GA.13.1.Brace.X1.stl

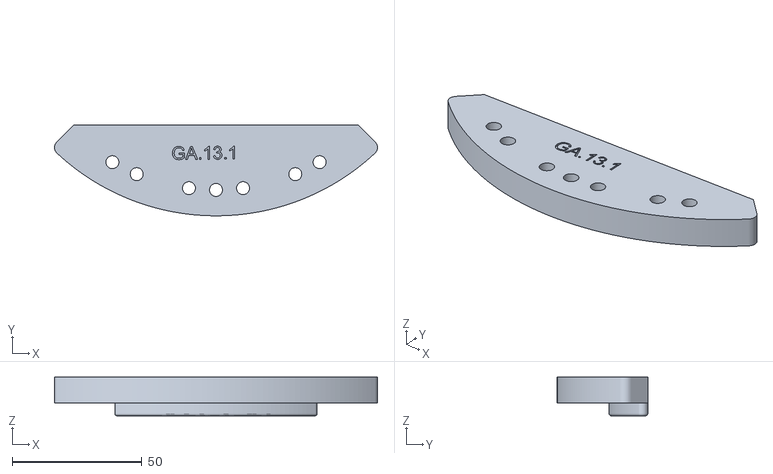
[picture p33: CAD file, 2026-11-02]
3d-printed-parts/4-camera-tower/GA.13.1.Brace.X1.stl
124.7 x 35.0 x 15.0
