Kgotso-Koete/pilomar/3d-printed-parts/7-dome/13.2.DoorB1.X1.stl

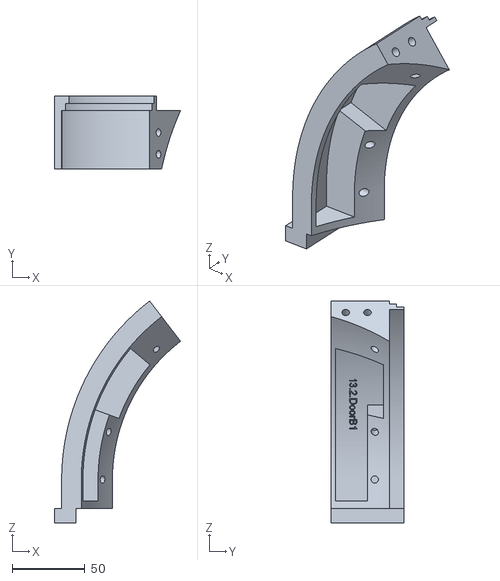
[picture p34: CAD file, 2026-11-02]
3d-printed-parts/7-dome/13.2.DoorB1.X1.stl
86.9 x 50.0 x 153.0
