Kgotso-Koete/pilomar/3d-printed-parts/7-dome/Dome.13.1.Segment.X8.stl

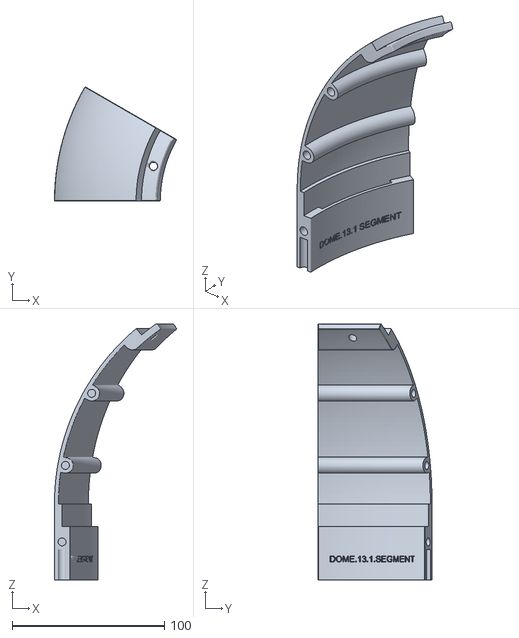
[picture p35: CAD file, 2026-11-02]
3d-printed-parts/7-dome/Dome.13.1.Segment.X8.stl
80.1 x 74.8 x 168.0
