Kgotso-Koete/pilomar/3d-printed-parts/7-dome/38mmPeg.X8.stl

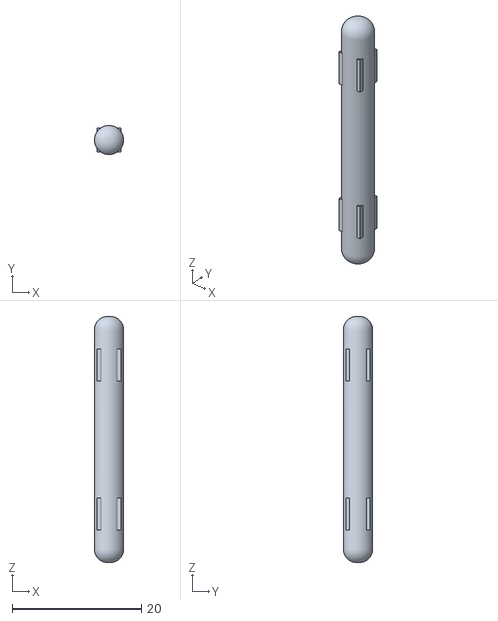
[picture p36: CAD file, 2026-11-02]
3d-printed-parts/7-dome/38mmPeg.X8.stl
4.50 x 4.50 x 38.0
