Kgotso-Koete/pilomar/3d-printed-parts/7-dome/Wall.13.2.X8.stl

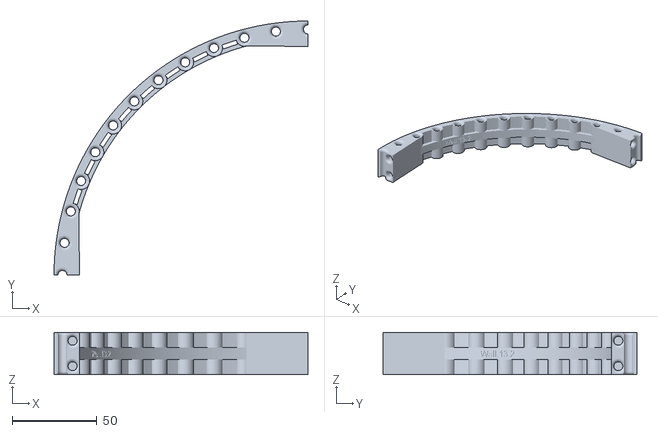
[picture p37: CAD file, 2026-11-02]
3d-printed-parts/7-dome/Wall.13.2.X8.stl
150.0 x 150.0 x 25.0
