Kgotso-Koete/pilomar/(list of files, cad)

Other CAD files:
3d-printed-parts/1-azimuth-drive-wheel/B.13.2.AzimuthDriveM6.X1.stl
3d-printed-parts/6-altitude-gearbox/S.13.2.12TM1-5mm.X1.stl
3d-printed-parts/7-dome/13.2.DoorA2.X1.stl
3d-printed-parts/7-dome/Dome.13.1.SideB2.X1.stl
3d-printed-parts/7-dome/Dome.13.3.CapAR.X1.stl
3d-printed-parts/7-dome/18mmPeg.X36.stl
3d-printed-parts/7-dome/13.2.DoorA1.X1.stl
3d-printed-parts/7-dome/Dome.13.1.SideB1.X1.stl
