Kgotso-Koete/pilomar/3d-printed-parts/3DPrintingGuide_2.pdf

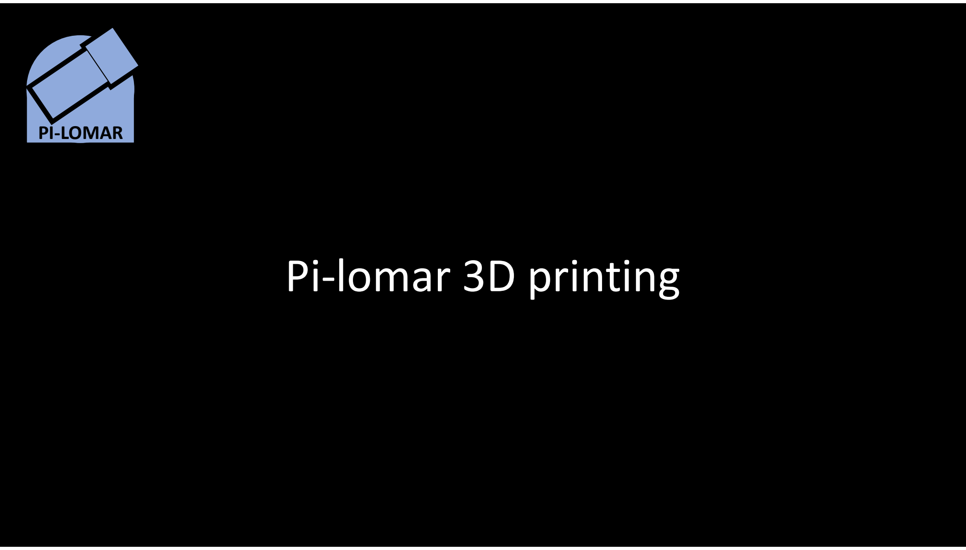
[picture p38: figure]
Pi-lomar 3D printing; PI-LOMAR

x12

# NOTES

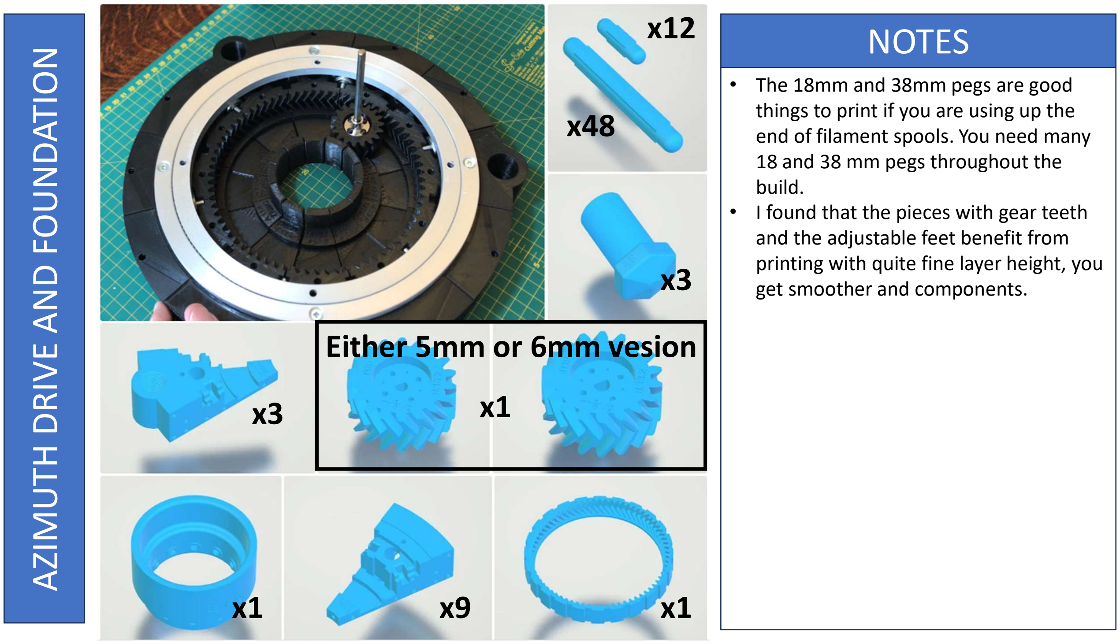
[picture p39: page 2]

x3 | x1 Either 5mm or 6mm vesion
x1 | x9 | x1

x3

x48 AZIMUTH DRIVE AND FOUNDATION | • The 18mm and 38mm pegs are good

things to print if you are using up the end of filament spools. You need many

### 18 and 38 mm pegs throughout the

build. • I found that the pieces with gear teeth

and the adjustable feet benefit from printing with quite fine layer height, you get smoother and components.

# NOTES

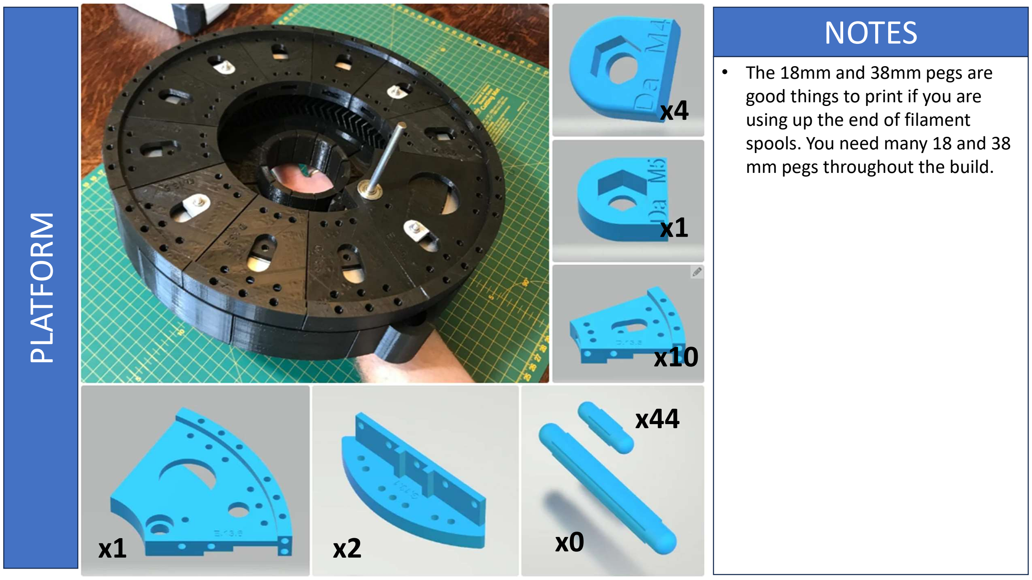
[picture p40: page 3]

x10

x2

x44

x1

x1

x4 PLATFORM | • The 18mm and 38mm pegs are
good things to print if you are using up the end of filament spools. You need many 18 and 38 mm pegs throughout the build.

x0

# NOTES

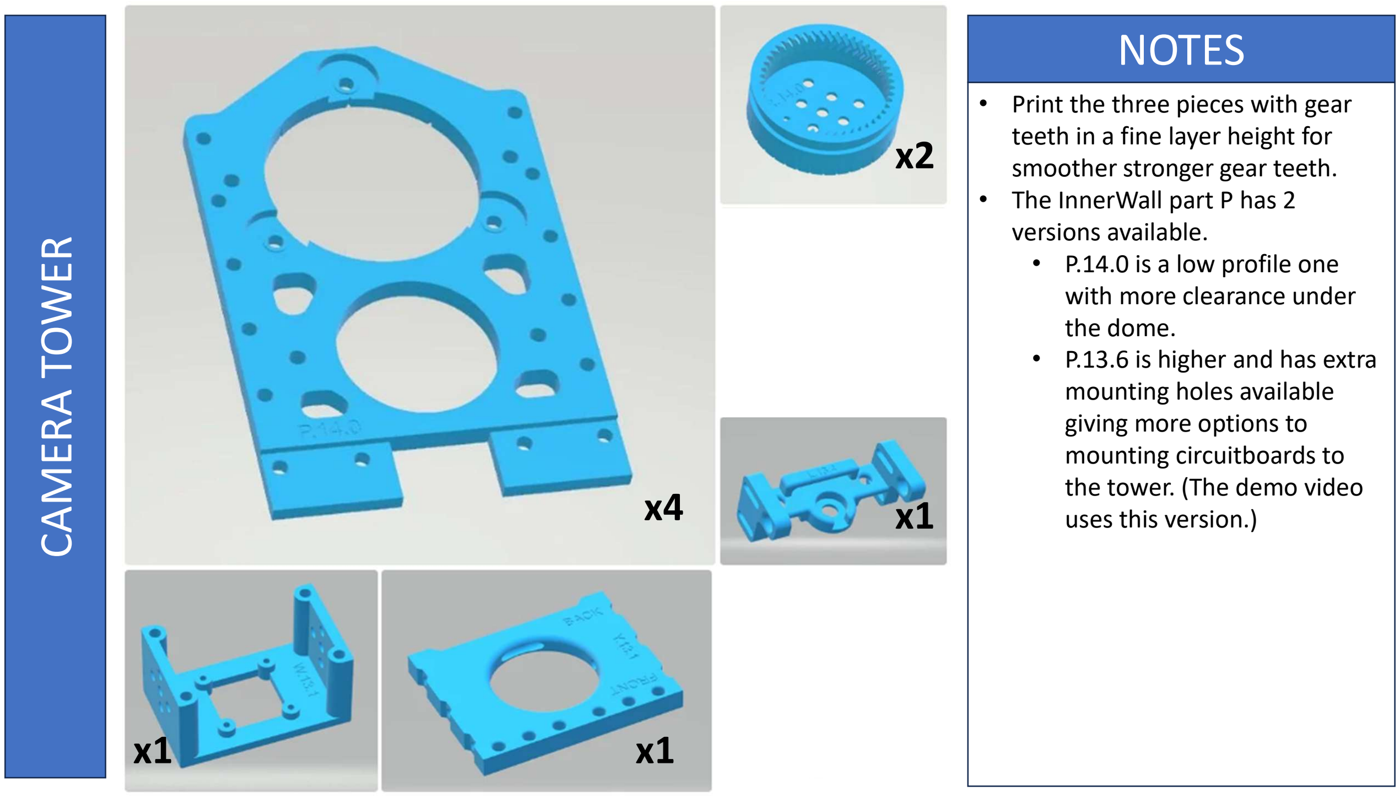
[picture p41: page 4]

x4 | x1

x1

x1

x2 CAMERA TOWER | • Print the three pieces with gear
teeth in a fine layer height for smoother stronger gear teeth. • The InnerWall part P has 2

versions available. • P.14.0 is a low profile one

with more clearance under
the dome. • P.13.6 is higher and has extra

mounting holes available
giving more options to
mounting circuitboards to
the tower. (The demo video uses this version.)

x1

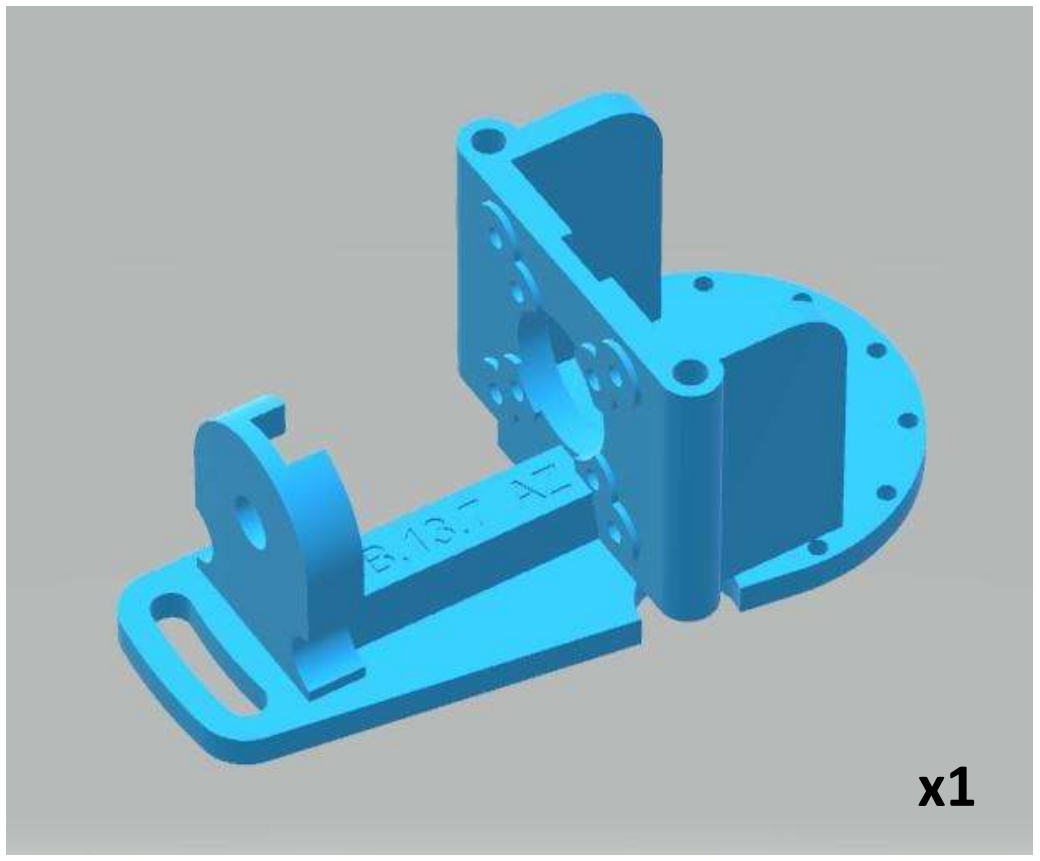
[picture p42: figure]

# AZIMUTH MOTOR

- Beware that the Azimuth motor housing looks similar to the Altitude one, but they are not the same.

# NOTES

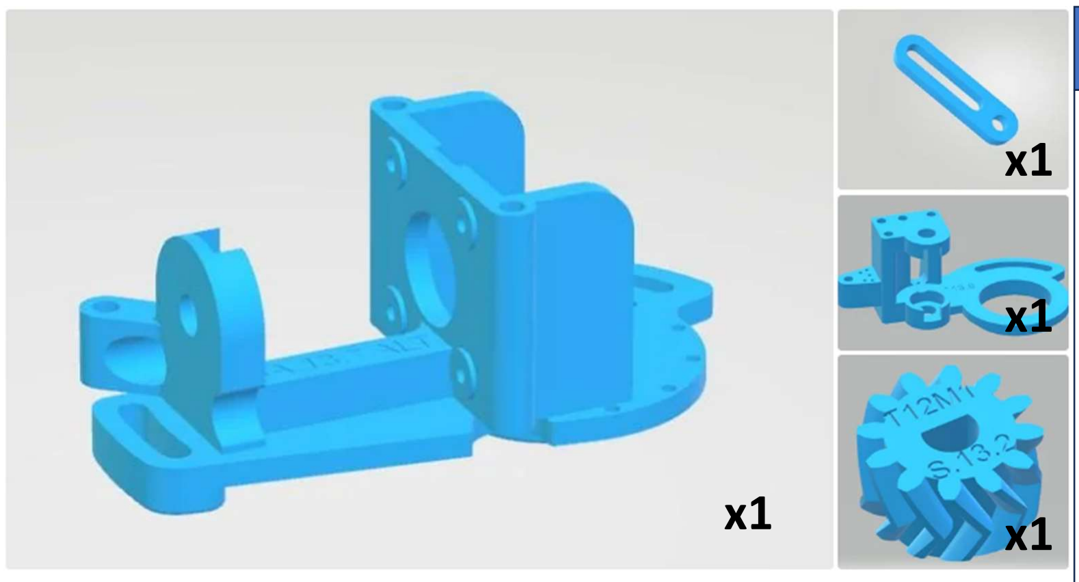
[picture p43: figure]

# ALTITUDE MOTOR

- Beware that the Altitude motor housing looks similar to the Azimuth one, but they are not the same. • The S.12.3 drive wheel is

available with a 5mm and 6mm bore depending upon the drive shaft you have to use for the Worm Gear cog.

# NOTES

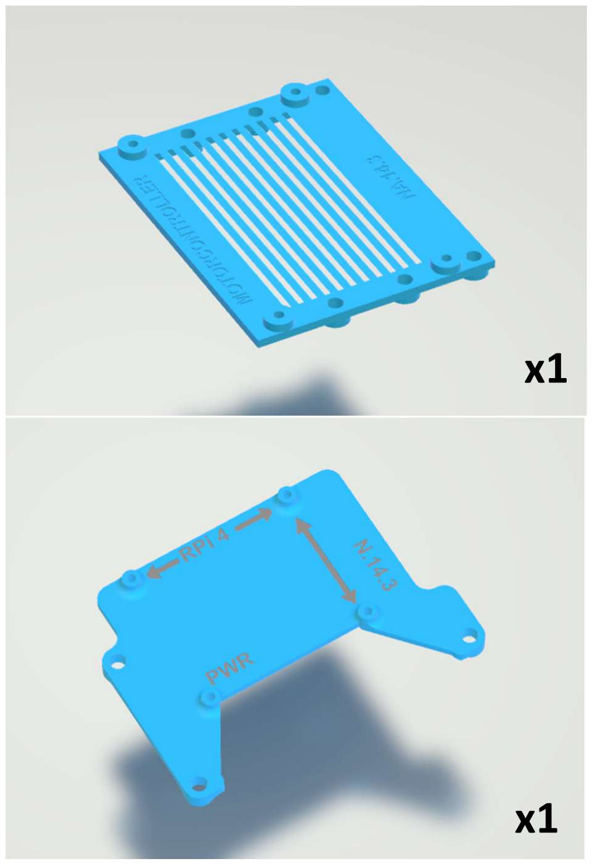
[picture p44: figure]

# MOUNT ELECTRONICS

- The microcontroller holder NA.14.3 may be used as a guide for your own mounting piece for the electronics. The mounting holes are spaced to match the available holes on the camera tower. However your solution to the electronics may require a different holder. • The Raspberry Pi holder is

designed for a RPi4B, if you align the RPi power connector with the PWR marking it should allow access to the other cable ports if needed. Depending upon your solution for the microcontroller you may be able to mount this higher on the camera tower if there is space.

# NOTES

# NOTES

x20

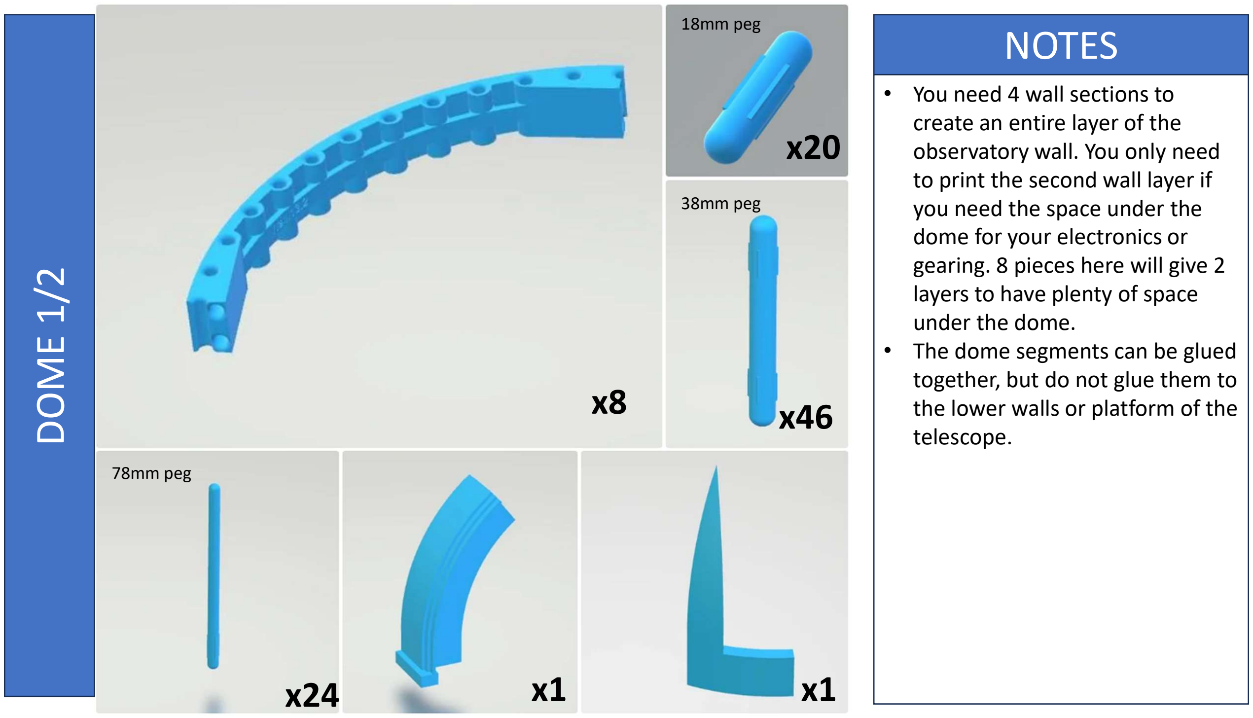
[picture p45: page 8]

DOME 1/2 • You need 4 wall sections to create an entire layer of the observatory wall. You only need to print the second wall layer if you need the space under the dome for your electronics or gearing. 8 pieces here will give 2 layers to have plenty of space under the dome. • The dome segments can be glued

together, but do not glue them to the lower walls or platform of the telescope.

x1

x8

78mm peg

x46

x1
x24

38mm peg

18mm peg

# NOTES

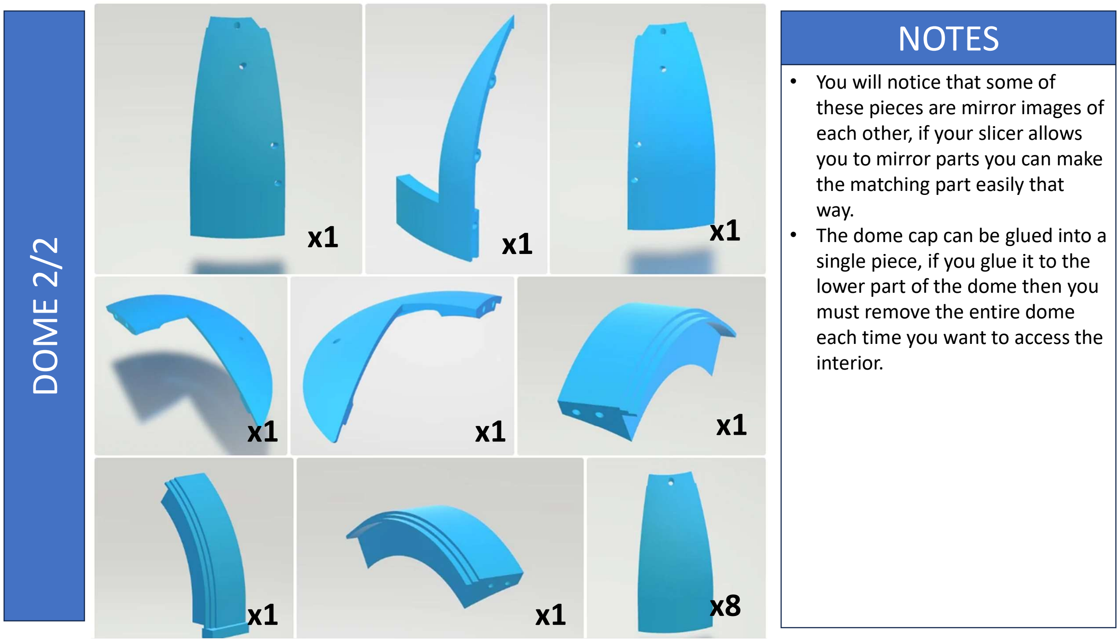
[picture p46: page 9]

# DOME 2/2

- You will notice that some of these pieces are mirror images of each other, if your slicer allows you to mirror parts you can make the matching part easily that way. • The dome cap can be glued into a

single piece, if you glue it to the lower part of the dome then you must remove the entire dome each time you want to access the interior.
x1
x1 | x1

x1

x1

x1

x1 | x1 | x8
