Kgotso-Koete/pilomar/docs/Schematic+Pilomar+Tiny2040+2023-02-03.pdf

## VMOT power input

## 12V power

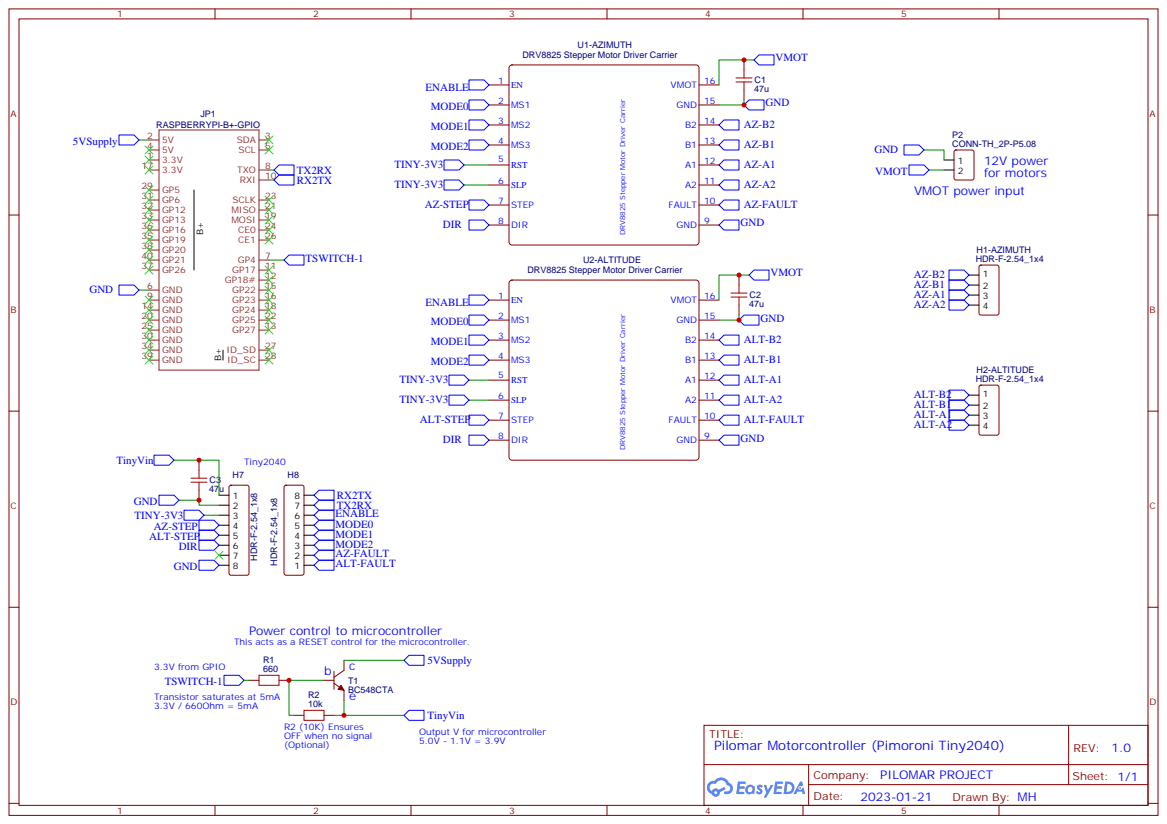
[picture p47: page 1]

DRV8825 Stepper Motor Driver Carrier

Power control to microcontroller
This acts as a RESET control for the microcontroller.

R2 (10K) Ensures
OFF when no signal
(Optional)
