Kgotso-Koete/pilomar/src/pilomarimage.py

#!/usr/bin/python

# image class for use in Pilomar project.
# Builds upon opencv features to provide pilomar specific routines.
# Some methods are just simplifications of existing opencv routines, such as line drawing, circles, etc.
# Some methods are enhancements adding some more features to existing opencv functions.
# There are also some methods which are very specific to the pilomar miniature observatory project.

# This software is published under the GNU General Public License v3.0.
# Also respect any pre-existing terms of any components that this incorporates.

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
import cv2 # OpenCV.
import numpy as np # Numpy array handling.
from datetime import datetime, timezone, timedelta
import math
import random # random number generator.
import os
from PIL import Image as PIL_Image
from PIL import ExifTags as PIL_ExifTags
try: # Try to load piexif library. 
    import piexif # Seems to be included as standard in Bookworm O/S pilomar build.
except: # Load failed, assume it's not available.
    piexif = None # Create empty holder for the class instead.
import json 

class data_set():
    """ Data set list of data points. """
    def __init__(self,name,color=None,style=['line']):
        self.Name = name
        self.DataPoints = []
        self.Color = color
        self.Style = style
        
    def Add(self,point):
        self.DataPoints.append(point)
        
    def Clear(self):
        self.DataPoints = []
        
class data_point():
    """ Datapoint. """
    def __init__(self,x,y,color=None,label=None,style=['dot'],xname=None,yname=None):
        self.X = x
        self.Y = y
        self.Color = color
        self.Label = label
        self.Style = style
        self.XName = xname
        self.YName = yname

class fd_object():
    """ Object to be placed in an image (for force directed graphs). """
    def __init__(self):
        self.Name = None
        self.Type = None
        self.Width = None # Dimensions of object.
        self.Height = None
        self.InitialX = None # Centre of object.
        self.InitialY = None
        self.Fixed = False
        self.CurrentX = self.InitialX # Centre of object.
        self.CurrentY = self.InitialY
        self.TargetX = self.InitialX # Centre of object.
        self.TargetY = self.InitialY
        
class fd_edge():
    """ Link between to objects (for force directed graphs). """
    def __init__(self):
        self.Name = None
        self.ObjectA = None # Handle to object at one end of the edge.
        self.ObjectB = None # Handle to object at the other end of the edge.

class pilomarimage():

    # Constants.
    __version__ = '0.2.1'
    IMAGETYPES = ['bgr','bgra','grayscale']
    # COLORPOINTS is used to estimate a RGB color from a Hipparcos star catalog star B-V value.
    COLORPOINTS = [(-0.33,[0x70,0x6f,0xfe]),
                   (-0.3,[0x51,0x9f,0xfe]),
                   (-0.02,[0xbf,0xd0,0xff]),
                   (0.3,[0xcd,0xfd,0xff]),
                   (0.58,[0xee,0xff,0xdf]),
                   (0.81,[0xff,0xff,0x7f]),
                   (1.4,[0xfe,0x7f,0x7d])]
    # Color names for OpenCV drawing. (Beware colors are BGR not RGB!)
    # Official HTML colors 3 Channel BGR colors only. 
    # Make all BGR colors available as a dictionary. Easier to search and manipulate.
    BGRColor = {
        "Black":(0,0,0),
        "Night":(10,9,12),
        "Charcoal":(44,40,52),
        "Oil":(49,49,59),
        "DarkGray":(60,59,58),
        "LightBlack":(69,69,69),
        "BlackCat":(57,56,65),
        "Iridium":(58,60,61),
        "BlackEel":(63,62,70),
        "BlackCow":(70,70,76),
        "GrayWolf":(75,74,80),
        "VampireGray":(81,80,86),
        "IronGray":(93,89,82),
        "GrayDolphin":(88,88,92),
        "CarbonGray":(93,93,98),
        "AshGray":(98,99,102),
        "DimGray":(105,105,105),
        "NardoGray":(108,106,104),
        "CloudyGray":(104,105,109),
        "SmokeyGray":(109,110,114),
        "AlienGray":(110,111,115),
        "SonicSilver":(117,117,117),
        "PlatinumGray":(121,121,121),
        "Granite":(124,126,131),
        "Gray":(128,128,128),
        "BattleshipGray":(130,132,132),
        "GunmetalGray":(141,145,141),
        "DarkGray":(169,169,169),
        "GrayCloud":(180,182,182),
        "Silver":(192,192,192),
        "PaleSilver":(187,192,201),
        "GrayGoose":(206,208,209),
        "PlatinumSilver":(206,206,206),
        "LightGray":(211,211,211),
        "SilverWhite":(221,219,218),
        "Gainsboro":(220,220,220),
        "Platinum":(226,228,229),
        "MetallicSilver":(204,198,188),
        "BlueGray":(199,175,152),
        "RomanSilver":(150,137,131),
        "LightSlateGray":(153,136,119),
        "SlateGray":(144,128,112),
        "RatGray":(141,123,109),
        "SlateGraniteGray":(131,115,101),
        "JetGray":(126,109,97),
        "MistBlue":(126,109,100),
        "MarbleBlue":(126,109,86),
        "SlateBlueGrey":(161,124,115),
        "LightPurpleBlue":(206,143,114),
        "AzureBlue":(160,99,72),
        "BlueJay":(126,84,43),
        "CharcoalBlue":(79,69,54),
        "DarkBlueGrey":(91,70,41),
        "DarkSlate":(86,56,43),
        "DeepSeaBlue":(86,52,18),
        "NightBlue":(84,27,21),
        "MidnightBlue":(112,25,25),
        "Navy":(128,0,0),
        "DenimDarkBlue":(141,27,21),
        "DarkBlue":(139,0,0),
        "LapisBlue":(126,49,21),
        "NewMidnightBlue":(160,0,0),
        "EarthBlue":(165,0,0),
        "CobaltBlue":(194,32,0),
        "MediumBlue":(205,0,0),
        "BlueberryBlue":(194,65,0),
        "CanaryBlue":(245,22,41),
        "Blue":(255,0,0),
        "SamcoBlue":(255,2,0),
        "BrightBlue":(255,9,9),
        "BlueOrchid":(252,69,31),
        "SapphireBlue":(199,84,37),
        "BlueEyes":(199,105,21),
        "BrightNavyBlue":(210,116,25),
        "BalloonBlue":(222,96,43),
        "RoyalBlue":(225,105,65),
        "OceanBlue":(236,101,43),
        "BlueRibbon":(255,110,48),
        "BlueDress":(236,125,21),
        "NeonBlue":(255,137,21),
        "DodgerBlue":(255,144,30),
        "GlacialBlueIce":(193,139,54),
        "SteelBlue":(180,130,70),
        "SilkBlue":(199,138,72),
        "WindowsBlue":(199,126,53),
        "BlueIvy":(199,144,48),
        "BlueKoi":(199,158,101),
        "ColumbiaBlue":(199,175,135),
        "BabyBlue":(199,185,149),
        "CornflowerBlue":(237,149,100),
        "SkyBlueDress":(255,152,102),
        "Iceberg":(236,165,86),
        "ButterflyBlue":(236,172,56),
        "DeepSkyBlue":(255,191,0),
        "MiddayBlue":(255,185,59),
        "CrystalBlue":(255,179,92),
        "DenimBlue":(236,186,121),
        "DaySkyBlue":(255,202,130),
        "LightSkyBlue":(250,206,135),
        "SkyBlue":(235,206,135),
        "JeansBlue":(236,207,160),
        "BlueAngel":(236,206,183),
        "PastelBlue":(236,207,180),
        "LightDayBlue":(255,223,173),
        "SeaBlue":(255,223,194),
        "HeavenlyBlue":(255,222,198),
        "RobinEggBlue":(255,237,189),
        "PowderBlue":(230,224,176),
        "CoralBlue":(236,220,175),
        "LightBlue":(230,216,173),
        "LightSteelBlue":(222,207,176),
        "GulfBlue":(236,223,201),
        "PastelLightBlue":(234,214,213),
        "LavenderBlue":(250,228,227),
        "WhiteBlue":(250,233,219),
        "Lavender":(250,230,230),
        "Water":(250,244,235),
        "AliceBlue":(255,248,240),
        "GhostWhite":(255,248,248),
        "Azure":(255,255,240),
        "LightCyan":(255,255,224),
        "LightSlate":(255,255,204),
        "ElectricBlue":(255,254,154),
        "TronBlue":(254,253,125),
        "BlueZircon":(255,254,87),
        "Aqua":(255,255,0),
        "Cyan":(255,255,0),
        "BrightCyan":(255,255,10),
        "Celeste":(236,235,80),
        "BlueDiamond":(236,226,78),
        "BrightTurquoise":(245,226,22),
        "BlueLagoon":(236,235,142),
        "PaleTurquoise":(238,238,175),
        "PaleBlueLily":(236,236,207),
        "LightTeal":(217,217,179),
        "TiffanyBlue":(208,216,129),
        "BlueHosta":(199,191,119),
        "CyanOpaque":(199,199,146),
        "NorthernLightsBlue":(199,199,120),
        "BlueGreen":(181,204,123),
        "MediumAquaMarine":(170,205,102),
        "MagicMint":(209,240,170),
        "LightAquamarine":(232,255,147),
        "Aquamarine":(212,255,127),
        "BrightTeal":(198,249,1),
        "Turquoise":(208,224,64),
        "MediumTurquoise":(204,209,72),
        "DeepTurquoise":(205,204,72),
        "Jellyfish":(199,199,70),
        "BlueTurquoise":(219,198,67),
        "DarkTurquoise":(209,206,0),
        "MacawBlueGreen":(199,191,67),
        "LightSeaGreen":(170,178,32),
        "SeafoamGreen":(159,169,62),
        "CadetBlue":(160,158,95),
        "DeepSea":(156,156,59),
        "DarkCyan":(139,139,0),
        "TealGreen":(127,130,0),
        "Teal":(128,128,0),
        "TealBlue":(128,124,0),
        "MediumTeal":(95,95,4),
        "DarkTeal":(93,93,4),
        "DeepTeal":(62,62,3),
        "DarkSlateGray":(60,56,37),
        "Gunmetal":(57,53,44),
        "BlueMossGreen":(91,86,60),
        "BeetleGreen":(126,120,76),
        "GrayishTurquoise":(126,125,94),
        "GreenishBlue":(126,125,48),
        "AquamarineStone":(129,135,52),
        "SeaTurtleGreen":(128,141,67),
        "DullSeaGreen":(117,137,78),
        "DarkGreenBlue":(87,99,31),
        "DeepSeaGreen":(84,103,48),
        "BottleGreen":(78,106,0),
        "SeaGreen":(87,139,46),
        "ElfGreen":(107,138,27),
        "DarkMint":(110,144,49),
        "Jade":(108,163,0),
        "EarthGreen":(111,165,52),
        "ChromeGreen":(96,162,26),
        "Emerald":(120,200,80),
        "Mint":(137,180,62),
        "MediumSeaGreen":(113,179,60),
        "MetallicGreen":(142,157,124),
        "CamouflageGreen":(107,134,120),
        "SageGreen":(121,139,132),
        "HazelGreen":(88,124,97),
        "VenomGreen":(0,140,114),
        "OliveDrab":(35,142,107),
        "Olive":(0,128,128),
        "DarkOliveGreen":(47,107,85),
        "MilitaryGreen":(49,91,78),
        "GreenLeaves":(11,95,58),
        "ArmyGreen":(32,83,75),
        "FernGreen":(38,124,102),
        "FallForestGreen":(88,146,78),
        "IrishGreen":(75,160,8),
        "PineGreen":(68,124,56),
        "MediumForestGreen":(53,114,52),
        "JungleGreen":(44,124,52),
        "CactusGreen":(66,116,34),
        "ForestGreen":(34,139,34),
        "Green":(0,128,0),
        "DarkGreen":(0,100,0),
        "DeepGreen":(8,102,5),
        "DeepEmeraldGreen":(7,99,4),
        "HunterGreen":(59,94,53),
        "DarkForestGreen":(23,65,37),
        "LotusGreen":(37,66,0),
        "SeaweedGreen":(23,124,67),
        "ShamrockGreen":(23,124,52),
        "GreenOnion":(33,161,106),
        "MossGreen":(91,154,138),
        "GrassGreen":(11,155,63),
        "GreenPepper":(44,160,74),
        "DarkLimeGreen":(23,163,65),
        "ParrotGreen":(43,173,18),
        "CloverGreen":(85,160,62),
        "DinosaurGreen":(108,161,115),
        "GreenSnake":(60,187,108),
        "AlienGreen":(23,196,108),
        "GreenApple":(23,196,76),
        "LimeGreen":(50,205,50),
        "PeaGreen":(23,208,82),
        "KellyGreen":(82,197,76),
        "ZombieGreen":(113,197,84),
        "GreenPeas":(92,195,137),
        "DollarBillGreen":(101,187,133),
        "FrogGreen":(142,198,153),
        "TurquoiseGreen":(180,214,160),
        "DarkSeaGreen":(143,188,143),
        "BasilGreen":(130,159,130),
        "GrayGreen":(156,173,162),
        "IguanaGreen":(113,176,156),
        "CitronGreen":(29,179,143),
        "AcidGreen":(26,191,176),
        "AvocadoGreen":(72,194,178),
        "PistachioGreen":(9,194,157),
        "SaladGreen":(53,201,161),
        "YellowGreen":(50,205,154),
        "PastelGreen":(119,221,119),
        "HummingbirdGreen":(23,232,127),
        "NebulaGreen":(23,232,89),
        "StoplightGoGreen":(100,233,87),
        "NeonGreen":(41,245,22),
        "JadeGreen":(110,251,94),
        "LimeMintGreen":(127,245,54),
        "SpringGreen":(127,255,0),
        "MediumSpringGreen":(154,250,0),
        "EmeraldGreen":(23,251,95),
        "Lime":(0,255,0),
        "LawnGreen":(0,252,124),
        "BrightGreen":(0,255,102),
        "Chartreuse":(0,255,127),
        "YellowLawnGreen":(23,247,135),
        "AloeVeraGreen":(22,245,152),
        "DullGreenYellow":(23,251,177),
        "LemonGreen":(2,248,173),
        "GreenYellow":(47,255,173),
        "ChameleonGreen":(22,245,189),
        "NeonYellowGreen":(1,238,218),
        "YellowGreenGrosbeak":(22,245,226),
        "TeaGreen":(93,251,204),
        "SlimeGreen":(84,233,188),
        "AlgaeGreen":(134,233,100),
        "LightGreen":(144,238,144),
        "DragonGreen":(146,251,106),
        "PaleGreen":(152,251,152),
        "MintGreen":(152,255,152),
        "GreenThumb":(170,234,181),
        "OrganicBrown":(166,249,227),
        "LightJade":(184,253,195),
        "LightMintGreen":(211,229,194),
        "LightRoseGreen":(219,249,219),
        "ChromeWhite":(212,241,232),
        "HoneyDew":(240,255,240),
        "MintCream":(250,255,245),
        "LemonChiffon":(205,250,255),
        "Parchment":(194,255,255),
        "Cream":(204,255,255),
        "CreamWhite":(208,253,255),
        "LightGoldenRodYellow":(210,250,250),
        "LightYellow":(224,255,255),
        "Beige":(220,245,245),
        "Cornsilk":(220,248,255),
        "Blonde":(217,246,251),
        "Champagne":(206,231,247),
        "AntiqueWhite":(215,235,250),
        "PapayaWhip":(213,239,255),
        "BlanchedAlmond":(205,235,255),
        "Bisque":(196,228,255),
        "Wheat":(179,222,245),
        "Moccasin":(181,228,255),
        "Peach":(180,229,255),
        "LightOrange":(177,216,254),
        "PeachPuff":(185,218,255),
        "CoralPeach":(171,213,251),
        "NavajoWhite":(173,222,255),
        "GoldenBlonde":(161,231,251),
        "GoldenSilk":(195,227,243),
        "DarkBlonde":(182,226,240),
        "LightGold":(172,229,241),
        "Vanilla":(171,229,243),
        "TanBrown":(182,229,236),
        "DirtyWhite":(201,228,232),
        "PaleGoldenRod":(170,232,238),
        "Khaki":(140,230,240),
        "CardboardBrown":(116,218,237),
        "HarvestGold":(117,226,237),
        "SunYellow":(124,232,255),
        "CornYellow":(128,243,255),
        "PastelYellow":(132,248,250),
        "NeonYellow":(51,255,255),
        "Yellow":(0,255,255),
        "CanaryYellow":(0,239,255),
        "BananaYellow":(22,226,245),
        "MustardYellow":(88,219,255),
        "GoldenYellow":(0,223,255),
        "BoldYellow":(36,219,249),
        "RubberDuckyYellow":(1,216,255),
        "Gold":(0,215,255),
        "BrightGold":(23,208,253),
        "ChromeGold":(68,206,255),
        "GoldenBrown":(23,193,234),
        "DeepYellow":(0,190,246),
        "MacaroniandCheese":(102,187,242),
        "Saffron":(23,185,251),
        "NeonGold":(1,189,253),
        "Beer":(23,177,251),
        "OrangeYellow":(66,174,255),
        "YellowOrange":(66,174,255),
        "Cantaloupe":(47,166,255),
        "CheeseOrange":(0,166,255),
        "Orange":(0,165,255),
        "BrownSand":(77,154,238),
        "SandyBrown":(96,164,244),
        "BrownSugar":(111,167,226),
        "CamelBrown":(107,154,193),
        "DeerBrown":(131,191,230),
        "BurlyWood":(135,184,222),
        "Tan":(140,180,210),
        "LightFrenchBeige":(127,173,200),
        "Sand":(128,178,194),
        "Sage":(138,184,188),
        "FallLeafBrown":(96,181,200),
        "GingerBrown":(98,190,201),
        "BronzeGold":(93,174,201),
        "DarkKhaki":(107,183,189),
        "OliveGreen":(108,184,186),
        "Brass":(66,166,181),
        "CookieBrown":(23,163,199),
        "MetallicGold":(55,175,212),
        "BeeYellow":(23,171,233),
        "SchoolBusYellow":(23,163,232),
        "GoldenRod":(32,165,218),
        "OrangeGold":(23,160,212),
        "Caramel":(23,142,198),
        "DarkGoldenRod":(11,134,184),
        "Cinnamon":(23,137,197),
        "Peru":(63,133,205),
        "Bronze":(50,127,205),
        "TigerOrange":(65,129,200),
        "Copper":(51,115,184),
        "DarkGold":(57,108,170),
        "MetallicBronze":(66,113,169),
        "DarkAlmond":(78,120,171),
        "Wood":(51,111,150),
        "OakBrown":(23,101,128),
        "AntiqueBronze":(30,93,102),
        "Hazel":(24,118,142),
        "DarkYellow":(0,128,139),
        "DarkMoccasin":(57,120,130),
        "KhakiGreen":(93,134,138),
        "MillenniumJade":(124,145,147),
        "DarkBeige":(118,140,159),
        "BulletShell":(96,155,175),
        "ArmyBrown":(96,123,130),
        "Sandstone":(95,109,120),
        "Taupe":(50,60,72),
        "Mocha":(38,61,73),
        "MilkChocolate":(28,59,81),
        "GrayBrown":(53,54,61),
        "DarkCoffee":(47,47,59),
        "OldBurgundy":(46,48,67),
        "WesternCharcoal":(63,65,73),
        "BakersBrown":(23,51,92),
        "DarkBrown":(33,67,101),
        "SepiaBrown":(20,66,112),
        "DarkBronze":(0,74,128),
        "Coffee":(55,78,111),
        "BrownBear":(59,92,131),
        "RedDirt":(23,82,127),
        "Sepia":(44,70,127),
        "Sienna":(45,82,160),
        "SaddleBrown":(19,69,139),
        "DarkSienna":(23,65,138),
        "Sangria":(23,56,126),
        "BloodRed":(23,53,126),
        "Chestnut":(53,69,149),
        "CoralBrown":(56,70,158),
        "ChestnutRed":(44,74,195),
        "Mahogany":(0,64,192),
        "RedGold":(6,84,235),
        "RedFox":(23,88,195),
        "DarkBisque":(0,101,184),
        "LightBrown":(29,101,181),
        "PetraGold":(52,103,183),
        "Rust":(65,98,195),
        "CopperRed":(81,109,203),
        "OrangeSalmon":(81,116,196),
        "Chocolate":(30,105,210),
        "Sedona":(0,102,204),
        "PapayaOrange":(23,103,229),
        "HalloweenOrange":(44,108,230),
        "NeonOrange":(0,103,255),
        "BrightOrange":(31,95,255),
        "PumpkinOrange":(23,114,248),
        "CarrotOrange":(23,128,248),
        "DarkOrange":(0,140,255),
        "ConstructionConeOrange":(49,116,248),
        "IndianSaffron":(34,119,255),
        "SunriseOrange":(81,116,230),
        "MangoOrange":(64,128,255),
        "Coral":(80,127,255),
        "BasketBallOrange":(88,129,248),
        "LightSalmonRose":(107,150,249),
        "LightSalmon":(122,160,255),
        "DarkSalmon":(122,150,233),
        "Tangerine":(97,138,231),
        "LightCopper":(103,138,218),
        "SalmonPink":(116,134,255),
        "Salmon":(114,128,250),
        "PeachPink":(136,139,249),
        "LightCoral":(128,128,240),
        "PastelRed":(128,114,246),
        "PinkCoral":(113,116,231),
        "BeanRed":(89,93,247),
        "ValentineRed":(81,84,229),
        "IndianRed":(92,92,205),
        "Tomato":(71,99,255),
        "ShockingOrange":(60,91,229),
        "OrangeRed":(0,69,255),
        "Red":(0,0,255),
        "NeonRed":(3,28,253),
        "ScarletRed":(0,36,255),
        "RubyRed":(23,34,246),
        "FerrariRed":(26,13,247),
        "FireEngineRed":(23,40,246),
        "LavaRed":(23,34,228),
        "LoveRed":(23,27,228),
        "Grapefruit":(31,56,220),
        "CherryRed":(65,70,194),
        "ChilliPepper":(23,27,193),
        "FireBrick":(34,34,178),
        "TomatoSauceRed":(7,24,178),
        "Brown":(42,42,165),
        "CarbonRed":(42,13,167),
        "Cranberry":(15,0,159),
        "SaffronRed":(20,19,147),
        "CrimsonRed":(0,0,153),
        "RedWine":(18,0,153),
        "WineRed":(18,0,153),
        "DarkRed":(0,0,139),
        "VeryDarkRed":(0,0,10),
        "Maroon":(0,0,128),
        "Burgundy":(26,0,140),
        "Vermilion":(27,25,126),
        "DeepRed":(23,5,128),
        "RedBlood":(0,0,102),
        "BloodNight":(6,22,85),
        "DarkScarlet":(25,3,86),
        "BlackBean":(2,12,61),
        "ChocolateBrown":(15,0,63),
        "Midnight":(23,27,43),
        "PurpleLily":(53,10,85),
        "PurpleMaroon":(65,5,129),
        "PlumPie":(65,5,125),
        "PlumVelvet":(82,5,125),
        "DarkRaspberry":(87,38,135),
        "VelvetMaroon":(77,53,126),
        "RosyFinch":(82,78,127),
        "DullPurple":(93,82,127),
        "Puce":(88,90,127),
        "RoseDust":(112,112,153),
        "PastelBrown":(127,144,177),
        "RosyPink":(129,132,179),
        "RosyBrown":(143,143,188),
        "KhakiRose":(142,144,197),
        "LipstickPink":(147,135,196),
        "PinkBrown":(137,129,196),
        "OldRose":(129,128,192),
        "DustyPink":(148,138,213),
        "PinkDaisy":(163,153,231),
        "Rose":(170,173,232),
        "DustyRose":(166,169,201),
        "SilverPink":(173,174,196),
        "GoldPink":(194,199,230),
        "RoseGold":(192,197,236),
        "DeepPeach":(164,203,255),
        "PastelOrange":(139,184,248),
        "DesertSand":(175,201,237),
        "UnbleachedSilk":(202,221,255),
        "PigPink":(228,215,253),
        "PalePink":(215,212,242),
        "Blush":(232,230,255),
        "MistyRose":(225,228,255),
        "PinkBubbleGum":(221,223,255),
        "LightRose":(205,207,251),
        "LightRed":(203,204,255),
        "WarmPink":(189,198,246),
        "DeepRose":(185,187,251),
        "Pink":(203,192,255),
        "LightPink":(193,182,255),
        "SoftPink":(191,184,255),
        "DonutPink":(190,175,250),
        "BabyPink":(186,175,250),
        "FlamingoPink":(176,167,249),
        "PastelPink":(170,163,254),
        "RosePink":(176,161,231),
        "PinkRose":(176,161,231),
        "CadillacPink":(174,138,227),
        "CarnationPink":(161,120,247),
        "PastelRose":(143,120,229),
        "BlushRed":(148,110,229),
        "PaleVioletRed":(147,112,219),
        "PurplePink":(135,101,209),
        "TulipPink":(124,90,194),
        "BashfulPink":(131,82,194),
        "DarkPink":(128,84,231),
        "DarkHotPink":(171,96,246),
        "HotPink":(180,105,255),
        "WatermelonPink":(133,108,252),
        "VioletRed":(138,53,246),
        "HotDeepPink":(135,40,245),
        "BrightPink":(127,0,255),
        "DeepPink":(147,20,255),
        "NeonPink":(170,53,245),
        "ChromePink":(170,51,255),
        "NeonHotPink":(156,52,253),
        "PinkCupcake":(157,94,228),
        "RoyalPink":(172,89,231),
        "DimorphothecaMagenta":(157,49,227),
        "PinkLemonade":(124,40,228),
        "RedPink":(85,42,250),
        "Raspberry":(93,11,227),
        "Crimson":(60,20,220),
        "BrightMaroon":(72,33,195),
        "RoseRed":(86,30,194),
        "RoguePink":(105,40,193),
        "BurntPink":(103,34,193),
        "PinkViolet":(107,34,202),
        "MagentaPink":(139,51,204),
        "MediumVioletRed":(133,21,199),
        "DarkCarnationPink":(131,34,193),
        "RaspberryPurple":(108,68,179),
        "PinkPlum":(143,59,185),
        "Orchid":(214,112,218),
        "DeepMauve":(212,115,223),
        "Violet":(238,130,238),
        "FuchsiaPink":(255,119,255),
        "BrightNeonPink":(255,51,244),
        "Fuchsia":(255,0,255),
        "Magenta":(255,0,255),
        "CrimsonPurple":(236,56,226),
        "HeliotropePurple":(255,98,212),
        "TyrianPurple":(236,90,196),
        "MediumOrchid":(211,85,186),
        "PurpleFlower":(199,74,167),
        "OrchidPurple":(181,72,176),
        "RichLilac":(210,102,182),
        "PastelViolet":(188,145,210),
        "MauveTaupe":(109,95,145),
        "ViolaPurple":(126,88,126),
        "Eggplant":(81,64,97),
        "PlumPurple":(89,55,88),
        "Grape":(128,90,94),
        "PurpleNavy":(128,81,78),
        "SlateBlue":(205,90,106),
        "BlueLotus":(236,96,105),
        "Blurple":(242,101,88),
        "LightSlateBlue":(255,106,115),
        "MediumSlateBlue":(238,104,123),
        "PeriwinklePurple":(207,117,117),
        "VeryPeri":(171,103,102),
        "BrightGrape":(168,45,111),
        "PurpleAmethyst":(199,45,108),
        "BrightPurple":(173,13,106),
        "DeepPeriwinkle":(166,83,84),
        "DarkSlateBlue":(139,61,72),
        "PurpleHaze":(126,56,78),
        "PurpleIris":(126,27,87),
        "DarkPurple":(80,1,75),
        "DeepPurple":(63,1,54),
        "MidnightPurple":(71,26,46),
        "PurpleMonster":(126,27,70),
        "Indigo":(130,0,75),
        "BlueWhale":(126,45,52),
        "RebeccaPurple":(153,51,102),
        "PurpleJam":(126,40,106),
        "DarkMagenta":(139,0,139),
        "Purple":(128,0,128),
        "FrenchLilac":(142,96,134),
        "DarkOrchid":(204,50,153),
        "DarkViolet":(211,0,148),
        "PurpleViolet":(201,56,141),
        "JasminePurple":(236,59,162),
        "PurpleDaffodil":(255,65,176),
        "ClematisViolet":(206,45,132),
        "BlueViolet":(226,43,138),
        "PurpleSageBush":(199,93,122),
        "LovelyPurple":(236,56,127),
        "NeonPurple":(255,0,157),
        "PurplePlum":(239,53,142),
        "AztechPurple":(255,59,137),
        "MediumPurple":(219,112,147),
        "LightPurple":(215,103,132),
        "CrocusPurple":(236,114,145),
        "PurpleMimosa":(255,123,158),
        "Periwinkle":(255,204,204),
        "PaleLilac":(255,208,220),
        "LavenderPurple":(182,123,150),
        "RosePurple":(202,159,176),
        "Lilac":(200,162,200),
        "Mauve":(255,176,224),
        "BrightLilac":(239,145,216),
        "PurpleDragon":(199,142,195),
        "Plum":(221,160,221),
        "BlushPink":(236,169,230),
        "PastelPurple":(232,162,242),
        "BlossomPink":(255,183,249),
        "WisteriaPurple":(199,174,198),
        "PurpleThistle":(211,185,210),
        "Thistle":(216,191,216),
        "PurpleWhite":(227,211,223),
        "PeriwinklePink":(236,207,233),
        "CottonCandy":(255,223,252),
        "LavenderPinocchio":(226,221,235),
        "DarkWhite":(209,217,225),
        "AshWhite":(212,228,233),
        "WhiteChocolate":(214,230,237),
        "SoftIvory":(221,240,250),
        "OffWhite":(227,240,248),
        "PearlWhite":(240,246,248),
        "RedWhite":(234,232,243),
        "LavenderBlush":(245,240,255),
        "Pearl":(244,238,253),
        "EggShell":(227,249,255),
        "OldLace":(227,240,254),
        "Linen":(230,240,250),
        "SeaShell":(238,245,255),
        "BoneWhite":(238,246,249),
        "Rice":(239,245,250),
        "FloralWhite":(240,250,255),
        "Ivory":(240,255,255),
        "WhiteGold":(244,255,255),
        "LightWhite":(247,255,255),
        "WhiteSmoke":(245,245,245),
        "Cotton":(249,251,251),
        "Snow":(250,250,255),
        "MilkWhite":(255,252,254),
        "HalfWhite":(250,254,255),
        "White":(255,255,255)
        }

    @staticmethod
    def BGR(colorname):
        """ Return color tuple for any given name.
            Raise error if name is not recognised. """
        result = pilomarimage.BGRColor.get(colorname,None)
        if result == None:
            print("ERROR: pilomarimage.BGR('" + str(colorname) + "') Color name is not recognised.")
            result = (0,0,0)
        return result
        
    BGRAColor = {
        "Black":(0,0,0,255),
        "Blue":(255,0,0,255),
        "Cyan":(255,255,0,255),
        "DimGray":(105,105,105,255),
        "Gold":(0,215,255,255),
        "Green":(0,255,0,255),
        "HotPink":(180,105,255,255),
        "LimeGreen":(50,205,50,255),
        "Orange":(0,165,255,255),
        "PaleGreen":(152,251,152,255),
        "Red":(0,0,255,255),
        "Transparent":(0,0,0,0),
        "White":(255,255,255,255),
        "Yellow":(0,255,255,255)
        }

    @staticmethod
    def BGRA(colorname):
        """ Return color tuple for any given name.
            Raise error if name is not recognised. """
        result = pilomarimage.BGRAColor.get(colorname,None)
        if result == None:
            print("ERROR: pilomarimage.BGRA('" + str(colorname) + "') Color name is not recognised.")
            result = (0,0,0,255)
        return result

    GRAYSCALEColor = {
        "White":255,
        "50":127,
        "Black":0    
    }
    
    @staticmethod
    def GRAYSCALE(colorname):
        """ Return grayscale tuple for any given name. """
        result = pilomarimage.GRAYSCALEColor.get(colorname,None)
        if result == None:
            print("ERROR: pilomarimage.GRAYSCALE('" + str(colorname) + "') Color name is not recognised.")
            result = 0
        return result
    
    # Define default filter scripts.
    # - You can overwrite this with your own set of scripts by assigning pilomarimage.FILTERSCRIPTS = {.....}
    # - This default script includes some example scripts to test, and also some specific scripts designed to achieve specific image enhancements.
    # - To run a script against the current image buffer call self.RunFilterScript( filtername )
    # -  eg self.RunFilterScript('ExampleThreshold') to run the ExampleThreshold script.
    # The scripts consist of a series of opencv actions that you can run against the current image buffer.
    # A script contains at least 1 action. Actions are executed their sequence in the script. The result is always stored in the current image buffer.
    # Where an action supports parameters those can be defined inside each step in this script.
    # If parameters are not given, defaults will be used.
    FILTERSCRIPTS = {
        # Examples of available methods.
        'Threshold':{ # Script to perform thresholding on an image. Call this with self.RunFilterScript('Threshold')
            'ThresholdStep':{
                'method':'threshold',
                'threshold':100,
                'maxval':255,
                'type': cv2.THRESH_BINARY,
                'comment': 'Use simple binary threshold to detect any pixels > 100 and consider them to be stars.',
                } # /ThresholdStep
            }, # /Threshold
        'Dehaze':{ # Script to remove haze from the background of an image. Call this with self.RunFilterScript('Dehaze')
            'DeHaze': {
                'method': 'dehaze',
                'samples': 1,
                'strength': 100,
                'comment': 'Remove urban haze from the image background.'
                } # /Dehaze
            },
        'Blur':{ # Script to perform gaussian blurring on the image. Call this with self.RunFilterScript('Blur')
            'BlurStep':{
                'method':'gaussianblur',
                'radius':100,
                'comment':'Apply Gaussian blur to widen remaining items',
                } # /BlurStep
            }, # /Blur
        'Grayscale':{ # Script to convert an image to grayscale. Call this with self.RunFilterScript('Grayscale')
            'GrayStep':{
                'method':'grayscale',
                'comment':'Reduce an image to grayscale.',
                } # /GrayStep
            }, # /Grayscale
        'RemoveGradient':{ # Script to remove gradient from an image. Call this with self.RunFilterScript('Gradient')
            'GradientStep':{
                'method':'removegradient',
                'blur_size':101,
                'comment':'Remove gradient from image.',
                } # /GradientStep
            }, # /RemoveGradient
        'RemoveGradientMorph':{
            'GradientMorphStep':{
                'method':'removegradient_morph',
                'kernel_size':75,
                'comment':'Remove gradient from image.',
                } # /GradientMorph
            }, # /RemoveGradientMorph
        'RemoveGradientPolyGray':{
            'GradientPolyGrayStep':{
                'method':'removegradient_polygray',
                'order':3,
                'comment':'Remove gradient from grayscale image using polynomials',
                } # /GradientPolyGrayStep
            }, # /RemoveGradientPolyGray
        'RemoveGradientPolyColor':{
            'GradientPolyColorStep':{
                'method':'removegradient_polycolor',
                'order':3,
                'comment':'Remove gradient from color image using polynomials',
                } # /GradientPolyColorStep
            }, # /RemoveGradientPolyColor
        'RemoveGradientPolyColorMasked':{
            'GradientPolyGrayColorMaskedStep':{
                'method':'removegradient_polycolormasked',
                'order':3,
                'comment':'Remove gradient from color image using polynomials and star masking',
                } # /GradientPolyColorMaskedStep
            }, # /RemoveGradientPolyColor
        # Suggested filters    
        'EnhanceClouds':{ # Enhance clouds in the image.  Call this with self.RunFilterScript('EnhanceClouds')
            'CloudThreshold':{
                'method':'threshold',
                'threshold':100,
                'maxval':255,
                'type': cv2.THRESH_BINARY,
                'comment': 'Use simple binary threshold to detect any pixels > 100 and consider them to be potential clouds.',
                } # /CloudThreshold
            }, # /CloudDetection
        'PrepForPlateSolving':{ # Enhance and convert to grayscale.
            'ClipStep':{
                'method':'levelshalfclip',
                'percentile':80, # /LevelsClip
                'comment': 'Use levels function to eliminate darkest half entirely, stretch rest.',
                }, #/ ClipStep
            'GrayStep':{
                'method':'grayscale',
                'comment':'Reduce an image to grayscale.',
                } # /GrayStep
            }, # /PrepForPlateSolving
        'EnhanceStars':{ # Enhance stars in the image.  Call this with self.RunFilterScript('EnhanceStars')
            'ToGrayscale':{ # Convert to grayscale image.
                'method':'grayscale',
                }, # /ToGrayscale
            'EliminateClouds':{ # Set low threshold to remove clouds and low level light.
                'method':'threshold',
                'threshold':100,
                'maxval':255,
                'type': cv2.THRESH_BINARY,
                'comment':'Apply low threshold to remove dim objects such as clouds.',
                }, # /EliminateClouds
            'BlurStars':{ # Use blur to enlarge remaining stars.
                'method':'gaussianblur',
                'radius':13,
                'comment':'Apply Gaussian blur to widen remaining items',
                }, # /BlurStars
            'BoostStars':{ # Enhance remaining stars.
                'method':'threshold',
                'threshold':16,
                'maxval':255,
                'type': cv2.THRESH_BINARY + cv2.THRESH_OTSU,
                'comment':'Apply adaptive threshold to boost remaining stars.',
                } # /BoostStars
            }, # /EnhanceStars
        'Brightest20':{ # LevelsClip script. Use only the brightest 20% of the pixels to form the image, all others are BLACK.
            'LevelsClip':{
                'method':'levelshalfclip',
                'percentile':80} # /LevelsClip
            },
        'UrbanFilter':{ # UrbanFilter script. Reduce haze and enhance stars. Call this with self.RunFilterScript('UrbanFilter')
            'ToGrayscale':{ # Convert to grayscale image.
                'method':'grayscale',
                }, # /ToGrayscale
            'DeHaze':{ # Reduce haze across the image.
                'method':'dehaze',
                'samples':1, # Just a single sample value is generated from the entire width of the line.
                'strength':100,
                'comment': 'Remove urban haze from the image background.',
                }, # /DeHaze
            'BlurStars':{ # Use blur to enlarge remaining stars.
                'method':'gaussianblur',
                'radius':2,
                'comment':'Apply Gaussian blur to widen remaining items',
                }, # /BlurStars
            'BoostStars':{ # Enhance remaining stars.
                'method':'threshold',
                'threshold':16,
                'maxval':255,
                'type': cv2.THRESH_BINARY + cv2.THRESH_OTSU,
                'comment':'Apply adaptive threshold to boost remaining stars.',
                } # /BoostStars
            } # /UrbanFilter
    } # /FILTERSCRIPTS
    
    # Define crosshair styles.
    CROSSHAIR_DOT = 1 # Central dot.
    CROSSHAIR_RING = 2 # Surrounding ring/circle.
    CROSSHAIR_SPOKES = 4 # Vertical/Horizontal lines.
    
    def __init__(self,name=None,logger=None):
        """ Create new image item. 
            name = any arbitrary name for the image.
            width = pixel width.
            height = pixel height.
            depth = image depth (2 = Grayscale, 3 = BGR, 4 = BGRA) 
            datatype = the storage type for each cell. default uint8 = unsigned 8 bit values. """
        self.Name = name
        self.SetLogger(logger) # Any method which supports pilomar's .Log() methods.
        self.LogDrawing = False # Record individual drawing commands in the log file?
        self.Font = cv2.FONT_HERSHEY_SIMPLEX
        self.InvertHeight = False # When set to TRUE, height pixel values are inverted, so they count UP FROM THE BOTTOM instead of DOWN FROM THE TOP.
        self._initialize()
        self.ResetGraph() # Create structures for graphing data.

    def OrientHeight(self,y,height=None):
        """ If InvertHeight is TRUE, invert the value of the 'y' pixel locations.
            This is good to convert a single 'y' dimension.
            If you have a tuple of (x,y) values, use OrientCoord() instead.

            Only apply this to coordinates which are being passed directly to opencv function calls.
            If you apply it to higher level method calls in this class you may end up applying it twice which will cancel the effect out. """
        if self.InvertHeight: # Co-ordinates provided are from BOTTOM UP, convert to TOP DOWN for OpenCV.
            if height == None: height = self.GetHeight() - 1
            y = height - y # Pixel locations count UP instead of DOWN. 
        return int(y)

    def OrientCoord(self,location,yloc=1,angle=0,height=None):
        """ If InvertHeight is TRUE, this returns a coordinate pair with the height dimension inverted. 
            yloc says which entry in the location pair is the height one.
            This converts tuples (x,y) and (y,x) style.
            If you have a single 'y' value, use OrientHeight(y) instead.
            If you specify angle: It's the rotation angle of the image (when using AddAngleText() for example. 90, 270 rotations orient along X axis instead.

            Only apply this to coordinates which are being passed directly to opencv function calls.
            If you apply it to higher level method calls in this class you may end up applying it twice which will cancel the effect out.            """
        if yloc == 1: # y location is at position 1 in the tuple, convert that.
            x = location[0]
            y = self.OrientHeight(location[1]) # Does height increase from the TOP or BOTTOM of the image?
            r = (x,y)
        else: # y location is at position 0 in the tuple, convert that.
            x = location[1]
            y = self.OrientHeight(location[0]) # Does height increase from the TOP or BOTTOM of the image?
            r = (y,x)
        return r
        
    def ResetGraph(self):
        """ Create data structure for basic charting/graphing. 
            This also clears any existing graphing data. """
        self.Graph_DataSets = [] # DataPoint = [x,y,color,label,style] # DataSet = list of DataPoint # DataSets = list of DataSet
        self.Graph_Title = 'title'
        self.Graph_XAxisTitle = 'x axis'
        self.Graph_YAxisTitle = 'y axis'
        self.Graph_XMinVal = None # Lowest X value in data points.
        self.Graph_XMaxVal = None # Highest X value in data points.
        self.Graph_YMinVal = None # Lowest Y value in data points.
        self.Graph_YMaxVal = None # Highest Y value in data points.
        self.Graph_XBorder = None # Width of left/right border.
        self.Graph_YBorder = None # Height of top/bottom border.
        self.Graph_XValueSpan = None # Span of X values.
        self.Graph_YValueSpan = None # Span of Y values.
        self.Graph_XTicks = None # Value of X axis ticks.
        self.Graph_YTicks = None # Value of Y axis ticks.
        
    def Interpolate(self,inp1,res1,inp2,res2,inp3):
        """ Linear interpolation from 2 points. """
        inpdelta = inp2 - inp1
        resdelta = res2 - res1
        if inpdelta != 0.0: # Input points are different, so result can be calculated.
            res3 = ((inp3 - inp1) * float(resdelta / inpdelta)) + res1
        else: # 2 input points are the same, result is unknown.
            res3 = res1 # Default to first result.
        return res3

    def MapToGraph(self,xpoint,ypoint):
        """ Given an x/y pair, find the pixel locations on a graph image.
            xpoint and ypoint are the data values stored in the Datasets. """
        x = int(self.Interpolate(self.Graph_XMinVal,self.Graph_XBorder,self.Graph_XMaxVal,self.GetWidth() - self.Graph_XBorder,xpoint)) # Scale it to the size of the canvas.
        y = int(self.Interpolate(self.Graph_YMinVal,self.Graph_YBorder,self.Graph_YMaxVal,self.GetHeight() - self.Graph_YBorder,ypoint)) # Scale it to the size of the canvas.
        return x,y
        
    def DrawXAxis(self):
        """ Draw X axis, scale and label """
        # Draw X scale where Y = 0 or at min Y
        if self.Graph_YMinVal < 0 and self.Graph_YMaxVal > 0: y = 0 # Where does x axis cross Y?
        elif self.Graph_YMaxVal < 0: y = self.Graph_YMaxVal
        else: y = self.Graph_YMinVal
        x1,y1 = self.MapToGraph(self.Graph_XMinVal,y)
        x2,y2 = self.MapToGraph(self.Graph_XMaxVal,y)
        self.DrawLine((x1,y1),(x2,y2),color=pilomarimage.BGRColor['Black']) # x-axis
        # Mark scale.
        i = self.Graph_XMinVal
        while i <= self.Graph_XMaxVal:
            # Mark this location and value.
            x1,y1 = self.MapToGraph(i,y)
            y2 = y1 - 20
            self.DrawLine((x1,y1),(x1,y2),color=pilomarimage.BGRColor['Black']) # Tick mark.
            self.AddText(str(round(i,3)),x1,y1 - 30,color=pilomarimage.BGRColor['Black'],hjust='c',vjust='t')
            i += self.Graph_XTicks
        # Label the axis.
        cx, _ = self.CenterCoordinates()
        self.AddText(self.Graph_XAxisTitle,cx,int(self.Graph_YBorder / 2),color=pilomarimage.BGRColor['Black'],size=2.0,hjust='c',vjust='c',thickness=2)
        return True

    def DrawYAxis(self):
        """ Draw X axis, scale and label """
        # Draw Y scale where X = 0 or at min X
        if self.Graph_XMinVal < 0 and self.Graph_XMaxVal > 0: x = 0 # Where does Y axis cross X?
        elif self.Graph_XMaxVal < 0: x = self.Graph_XMaxVal
        else: x = self.Graph_XMinVal
        x1,y1 = self.MapToGraph(x,self.Graph_YMinVal)
        x2,y2 = self.MapToGraph(x,self.Graph_YMaxVal)
        self.DrawLine((x1,y1),(x2,y2),color=pilomarimage.BGRColor['Black']) # y-axis
        # Mark scale.
        i = self.Graph_YMinVal
        while i <= self.Graph_YMaxVal:
            # Mark this location and value.
            x1,y1 = self.MapToGraph(x,i)
            x2 = x1 - 20
            self.DrawLine((x1,y1),(x2,y1),color=pilomarimage.BGRColor['Black']) # Tick mark.
            self.AddText(str(round(i,3)),x1 - 30,y1,color=pilomarimage.BGRColor['Black'],hjust='r',vjust='c')
            i += self.Graph_YTicks
        # Label the axis.
        _, cy = self.CenterCoordinates()
        self.AddAngleText(self.Graph_YAxisTitle,int(self.Graph_XBorder / 2),cy,color=pilomarimage.BGRColor['Black'],size=2.0,hjust='c',vjust='c',thickness=2,angle=90) # Rotated. Not working smoothly yet.
        return True

    def ListDataSets(self):
        """ Generate a key on the graph.
            List the names of the available data sets in the image. """
        x = self.GetWidth() - self.Graph_XBorder + 50
        self.AddText("Datasets:-",x,self.GetHeight() - 500,color=pilomarimage.BGRColor['Black'])
        for dataset in self.Graph_DataSets:
            self.AddText(dataset.Name,x,self.PrevTextY,color=dataset.Color)
        return True
            
    def Adddata_point(self,name,x,y,color=None,label=None,style=['dot'],xname=None,yname=None,xtolerance=0,ytolerance=0):
        """ Find/add dataset and add this to it. 
            color is specific to this single datapoint. Dataset color is used otherwise.
            xtolerance/ytolerance: point is not added if x,y is closer than this to the previous one. 
            """
        # Check that the named dataset exists.
        foundit = False
        for dataset in self.Graph_DataSets:
            if dataset.Name == name: foundit = True
        if foundit == False: # Dataset does not exist yet, add it.
            dataset = data_set(name)
            self.Graph_DataSets.append(dataset)
        # Check for tolerance limits. Don't add if too close to last entry.
        oktoadd = True
        if xtolerance != 0 or ytolerance != 0:
            for dataset in self.Graph_DataSets:
                if dataset.Name == name:
                    datapointcount = len(dataset.DataPoints)
                    if datapointcount > 0:
                        datapoint = dataset.DataPoints[-1] # Get last point.
                        if abs(datapoint.X - x) < xtolerance and abs(datapoint.Y - y) < ytolerance:
                            oktoadd = False # New point is too close to old point. Don't add it.
        if oktoadd: # Datapoint is OK to add.
            for dataset in self.Graph_DataSets:
                if dataset.Name == name:
                    if color == None: color = dataset.Color # Inherit color from parent dataset.
                    datapoint = data_point(x,y,color,label,style,xname,yname)
                    dataset.Add(datapoint)
        return True
    
    def Adddata_set(self,name,color=None,style=['line']):
        """ Create new dataset. """
        foundit = False
        for dataset in self.Graph_DataSets:
            if dataset.Name == name: foundit = True
        if foundit == False: # Dataset does not exist yet, add it.
            dataset = data_set(name,color,style)
            self.Graph_DataSets.append(dataset)
        result = not foundit
        return result
        
    def AnalyseDataPoints(self):
        # Go through the graph datapoints and extract limits.
        self.Graph_XMinVal = self.Graph_XMaxVal = self.Graph_YMinVal = self.Graph_YMaxVal = None
        if len(self.Graph_DataSets) > 0: # There are datasets to handle.
            for dataset in self.Graph_DataSets: # Data point = [x,y,color,label,style] # DataSet = list of DataPoints, # DataSets = list of DataSets
                if len(dataset.DataPoints) > 0: # There are datapoints to handle.
                    for point in dataset.DataPoints: # Check each point.
                        if self.Graph_XMinVal == None or self.Graph_XMinVal > point.X: self.Graph_XMinVal = point.X
                        if self.Graph_YMinVal == None or self.Graph_YMinVal > point.Y: self.Graph_YMinVal = point.Y
                        if self.Graph_XMaxVal == None or self.Graph_XMaxVal < point.X: self.Graph_XMaxVal = point.X
                        if self.Graph_YMaxVal == None or self.Graph_YMaxVal < point.Y: self.Graph_YMaxVal = point.Y
        if self.Graph_XMinVal == None: # No values were found.
            self.Graph_XMinVal = -1
            self.Graph_XMaxVal = 1
            self.Graph_YMinVal = -1
            self.Graph_YMaxVal = 1
        # Check that each axis does span at least a small distance.
        if self.Graph_XMinVal == self.Graph_XMaxVal: 
            self.Graph_XMinVal -= 1
            self.Graph_XMaxVal += 1
        if self.Graph_YMinVal == self.Graph_YMaxVal: 
            self.Graph_YMinVal -= 1
            self.Graph_YMaxVal += 1
        return True
        
    def EstablishGraphScale(self):
        """ What scale to use on each axis. 
            Where to place tickmarks on each axis. """
        self.Graph_XValueSpan = self.Graph_XMaxVal - self.Graph_XMinVal
        self.Graph_YValueSpan = self.Graph_YMaxVal - self.Graph_YMinVal
        self.Graph_XTicks = self.Graph_XValueSpan / 10
        self.Graph_YTicks = self.Graph_YValueSpan / 10
        return True

    def PlotData(self):
        """ Plot the actual data points on the graph.

            self.X = x
            self.Y = y
            self.Color = color
            self.Label = label
            self.Style = Style
            self.XName = xname
            self.YName = yname
            """
        for dataset in self.Graph_DataSets:
            prevx = None
            prevy = None
            for i,datapoint in enumerate(dataset.DataPoints):
                x,y = self.MapToGraph(datapoint.X,datapoint.Y)
                r = 5
                color = self.SafeColor(datapoint.Color,default=pilomarimage.BGRColor['Fuchsia'])
                if 'line' in dataset.Style and i > 0: # Line between points.
                    self.DrawLine((prevx,prevy),(x,y),color=self.SafeColor(dataset.Color,default=pilomarimage.BGRColor['Cyan']))
                if 'dot' in datapoint.Style: # Draw a small dot where the datapoint is.
                    self.FillCircle(x,y,r,color) # Dot on the datapoint.
                if 'point' in datapoint.Style: # Draw a single pixel where the datapoint is.
                    self.SetPixel(x,y,color) # Single pixel at the datapoint.
                prevx = x
                prevy = y
        return True

    def ExportData(self,filename):
        """ Dump the graph data. """
        ft = filename.rindex('.')
        filename = filename[:ft] + ".dat"
        self.Log("pilomarimage",self.Name,".ExportData:",str(filename),terminal=False)
        with open(filename,'w') as f:
            line = "dataset.Name\t"
            line += "datapoint.X\t"
            line += "datapoint.Y\t"
            line += "datapoint.Label\t"
            line += "datapoint.XName\t"
            line += "datapoint.YName\t"
            line += '\n'
            f.write(line)
            for dataset in self.Graph_DataSets:
                for datapoint in dataset.DataPoints:
                    line = str(dataset.Name) + "\t"
                    line += str(datapoint.X) + "\t"
                    line += str(datapoint.Y) + "\t"
                    line += str(datapoint.Label) + "\t"
                    line += str(datapoint.XName) + "\t"
                    line += str(datapoint.YName) + "\t"
                    line += '\n'
                    f.write(line)
        return True
        
    def PlotGraph(self,height,width,filename,export=False):
        """ Create very simplistic graph.
            If height/width not given, the current buffer is used.
            This is VERY crude! IF you want proper graphing capabilities then install matplotlib!
            This is really to support development/debugging work sometimes while avoiding having to install extra packages.
            export=True means a datafile is dumped too. """
        self.Log("pilomarimage",self.Name,".PlotGraph:",str(filename),str(export),terminal=False)
        self.InvertHeight = True # Easier to plot graphs if HEIGHT pixels count from the bottom up.
        # Find axis limits.
        self.AnalyseDataPoints()
        # Establish scale
        self.EstablishGraphScale()
        # Establish graph space
        self.New(height,width,'bgr') # New BGR image.
        self.FillColor(pilomarimage.BGRColor['White']) # White canvas
        self.Graph_XBorder = int(width * 0.1)
        self.Graph_YBorder = int(height * 0.1)
        self.DrawRectangle((self.Graph_XBorder,self.Graph_YBorder),(width - self.Graph_XBorder,height - self.Graph_YBorder),color=pilomarimage.BGRColor['DarkGray'])
        self.DrawXAxis() # Draw X axis on graph.
        self.DrawYAxis() # Draw Y axis on graph.
        x,y = self.CenterCoordinates()
        self.AddText(self.Graph_Title,x,int(height - self.Graph_YBorder / 2),size=3,color=pilomarimage.BGRColor['Black'],thickness=3,hjust='c',vjust='c')
        self.ListDataSets() # Add labels for the available datasets.
        self.PlotData() # Plot the data on the graph.
        self.DrawGraphID() # Write footing information onto the graph.
        # Save the result.
        self.SaveFile(filename)
        if export: self.ExportData(filename) # Export the data.
        self.InvertHeight = False # Revert to counting height locations from the top down.
        return True
        
    def DrawGraphID(self):
        """ Write footing information onto the graph. """
        line = ' pilomarimage.PlotGraph ' + str(datetime.now()).split('.')[0] + ' UTC '
        self.AddText(line,self.GetWidth() - 10, 20, color=pilomarimage.BGRColor['Black'],hjust='r')
        return True
        
    def SetLogger(self,logger):
        """ Set up link to logging class and shortcuts to common methods. """
        # The logging methods default to 'consumers' which will just silently eat any parameters passed.
        self.Logger = logger # Logger instance.
        self.Log = self._NullLogger # No log method.
        self.ReportException = self._NullLogger # Cannot report exception details to logfile.
        self.RaiseException = self._NullLogger # Cannor report and raise exception. 
        if hasattr(logger,'Log'): self.Log = logger.Log # Log method.
        if hasattr(logger,'ReportException'): self.ReportException = logger.ReportException # Report exception details to logfile.
        if hasattr(logger,'RaiseException'): self.RaiseException = logger.RaiseException # Report and raise exception. 
        #self.Log("pilomarimage.SetLogger: Linked to this log file.",terminal=False)

    def _NullLogger(self,*args, **kwargs):
        """ Null logger. Absorbs parameters and .log call but does nothing. 
            Use this when there is no logger defined. """
        return

    def _initialize(self):
        """ Create default values for the object. 
            This creates initial values for new instances, and also clears them out if you want to reset an existing one. """
        self.ImageBuffer = None # This is the actual OpenCV / Numpy image buffer.
        self.ImageMask = None # Array identifying which cells are occupied and which to ignore.
        self.ImageAccumulator = None # Array of cumulative image values. (For live stacking)
        self.ImageCounter = None # Array of how many values are accumulated into each pixel of self.ImageAccumulator. (For live stacking)
        self.ActionList = [['__version__',str(pilomarimage.__version__)]] # List of actions performed on the image.
        self.CreatedTimestamp = self.NowUTC()
        self.ModifiedTimestamp = None
        self.StarList = [] # Was None
        self.StarCount = 0
        self.StarMatchList = None
        self.HorizontalSpread = 0 # % of horizonal spread of stars.
        self.VerticalSpread = 0 # % of vertical spread of stars.
        self.AreaSpread = 0 # % of area spread of stars.
        self.PenColor = None # Default color for drawing.
        self.PenThickness = 1 # Default pen thickness for drawing.
        self.LineType = cv2.LINE_AA # Default line_type for drawing.
        self.ResizeMethod = cv2.INTER_AREA # Which sampling method is used for resizing? (3)
        self.ResizeMethods = [cv2.INTER_NEAREST, # nearest neighbor interpolation technique (0)
                              cv2.INTER_LINEAR, # bilinear interpolation (default) (1)
                              cv2.INTER_AREA, # resampling using pixel area relation (3)
                              cv2.INTER_CUBIC, # bicubic interpolation over 4 x 4 pixel neighborhood (2)
                              cv2.INTER_LANCZOS4] # Lanczos interpolation over 8 x 8 pixel neighborhood (4)
                              # cv2.INTER_LINEAR_EXACT, cv2.INTER_NEAREST_EXACT, cv2.INTER_MAX, cv2.WARP_FILL_OUTLIERS, cv2.WARP_INVERSE_MAP] # (16) Not in this version.
        self.NextTextY = None # When text is printed, this holds the 'y' position of the next line of text if you want to print a block of text.
        self.NextTextX = None # When text is printed, this holds the 'x' position of the next line of text if you want to print a block of text.
        self.PrevTextY = None # When text is printed, this holds the 'y' position of the next line of text if you want to print a block of text going UPWARDS.
        self.PrevTextX = None # When text is printed, this holds the 'x' position of the next line of text if you want to print a block of text goind UPWARDS.
        # Text collision avoidance...
        self.TextList = [] # When text is printed, this holds the co-ordinates of each block of text added [[fromx,fromy,tox,toy],[fromx,fromy,tox,toy],[fromx,fromy,tox,toy],...]
        self.AvoidTextCollisions = False # When TRUE, new text is only created if it doesn't overlap existing text.
        self.ExifData = {} # Empty dictionary of any associated EXIF tags loaded from an image.
        # Scale/Extent of alt/az diagrams.
        self.AltMin = -90 # Bottom of image represents -90 degrees altitude.
        self.AltMax = 90 # Top of image represents 90 degrees altitude.
        self.AzMin = 0 # Minimum azimuth in image is 0 degrees.
        self.AzMax = 360 # Maximum azimuth in image is 360 degrees.
        self.AzOffset = 180 # '0' degree azimuth point is shifted 180 degrees, ie into the center of the image.
        # Save the parameters used for the last call to CountStars.
        self.CountStars_last_minval = None # Record the parameters used.
        self.CountStars_last_maxval = None # Record the parameters used.
        self.CountStars_last_maxstars = None # Record the parameters used.
        self.CountStars_last_threshold = None # Record the parameters used.
        
        
    def TextCollision(self,fromx,fromy,tox,toy):
        """ Return TRUE if proposed text area collides with an existing one. """
        result = False
        if self.AvoidTextCollisions: # Collision avoidance is active.
            fromx, tox = min(fromx,tox), max(fromx,tox) # Make sure FROM is less than TO
            fromy, toy = min(fromy,toy), max(fromy,toy)
            for items in self.TextList: # Go through existing text items.
                ifx = items[0] # Pull co-ordinates.
                ify = items[1]
                itx = items[2]
                ity = items[3]
                if (tox < ifx or fromx > itx or toy < ify or fromy > ity):
                    # Right side of proposed text is < left side of existing text
                    # Left side of proposed text is > right side of existing text
                    # Top of proposed text is < bottom of existing text
                    # Bottom of proposed text is > top of existing text
                    pass # No collision.
                else: # Collision!
                    result = True
                    break
            if not result: # Text does not collide, we'll at it to the list of allowed text.
                self.TextList.append([fromx,fromy,tox,toy])
        return result

    def LaplacianSharpness(self):
        """ Assess sharpness of image using Laplacian operator.
            Advantages: Fast and straightforward to implement.
            Limitations: Sensitive to noise; denoising is recommended before application.        
            (Based upon AI suggested code)
            Does not modify original ImageBuffer. """
        img = self.NewBufferType("grayscale")
        laplacian_var = cv2.Laplacian(img, cv2.CV_64F).var()
        return laplacian_var

    #def Sharpness(self): # Renamed as CannySharpness() method.
    #    """ Assess the crispness of an image. 
    #        Some images will be sharper than others.
    #        This uses Canny Edge Detection.
    #        This is a solution found online .... 
    #        https://stackoverflow.com/questions/28717054/calculating-sharpness-of-an-image (Vektorsoft)
    #        low return values = More blurred. 
    #        high return values = More crisp. """
    #    self.Log("pilomarimage",self.Name,".Sharpness()",terminal=False)
    #    canny = cv2.Canny(self.NewBufferType('grayscale'), 50,250) # Use canny edge detection.
    #    sharpness = np.mean(canny)
    #    return sharpness

    def CannySharpness(self):
        """ Assess the crispness of an image. 
            Some images will be sharper than others.
            This uses Canny Edge Detection.
            This is a solution found online .... 
            https://stackoverflow.com/questions/28717054/calculating-sharpness-of-an-image (Vektorsoft)
            low return values = More blurred. 
            high return values = More crisp. """
        self.Log("pilomarimage",self.Name,".Sharpness()",terminal=False)
        canny = cv2.Canny(self.NewBufferType('grayscale'), 50,250) # Use canny edge detection.
        canny_sharpness = np.mean(canny)
        return canny_sharpness
        
    def SobelSharpness(self):
        """ Assess sharpness of image using Sobel operator.
            Advantages: Effective for detecting fine edges, such as those of stars.
            Limitations: Slightly slower than the Laplacian method.        
            (Based upon AI suggested code)
            Does not modify original ImageBuffer. """
        img = self.NewBufferType("grayscale")
        sobel_x = cv2.Sobel(img, cv2.CV_64F, 1, 0, ksize=3)
        sobel_y = cv2.Sobel(img, cv2.CV_64F, 0, 1, ksize=3)
        tenengrad = np.mean(sobel_x**2 + sobel_y**2)
        return tenengrad

    def ApplyLevelsBuffer(self,imagebuffer,in_black=0, in_white=255, gamma=1.0, out_black=0, out_white=255):
        """
        Apply Levels to the colors of an image buffer. 
        This sets a minimum and maximum brightness of each channel and then stretches the images to fit this.
        This is similar to the 'Levels' tool in image processing tools.
        
        Parameters ------------------------------------------
        in_black (int)  : The input value that should become pure black, with all lower values clipped.
        in_white (int)  : The input value that should become pure white, with all higher values clipped.
        gamma (int)     : A midtone adjustment factor that brightens or darkens values between black and white without changing the endpoints.
        out_black (int) : The output value that replaces pure black after processing, effectively lifting the darkest tones.
        out_white (int) : The output value that replaces pure white after processing, effectively lowering the brightest tones.
        
        # Example usage
        im = pilomarimage()
        im.LoadFile("input.jpg")
        result = im.ApplyLevelsBuffer(im.ImageBuffer, in_black=20, in_white=230, gamma=0.8)
        cv2.imwrite("output.jpg", result)
        """
        # Convert to float [0,1]
        img_f = imagebuffer.astype(np.float32) / 255.0

        # Normalize input range
        in_black_f = in_black / 255.0
        in_white_f = in_white / 255.0
        out_black_f = out_black / 255.0
        out_white_f = out_white / 255.0

        # Step 1: input clipping + normalization
        img_norm = (img_f - in_black_f) / (in_white_f - in_black_f)
        img_norm = np.clip(img_norm, 0, 1)

        # Step 2: gamma
        img_gamma = img_norm ** (1.0 / gamma)

        # Step 3: output scaling
        img_out = out_black_f + img_gamma * (out_white_f - out_black_f)

        return (img_out * 255).astype(np.uint8)

    def ApplyLevels(self,in_black=0, in_white=255, gamma=1.0, out_black=0, out_white=255):
        """
        Apply Levels to the colors of the loaded image. 
        This sets a minimum and maximum brightness of each channel and then stretches the images to fit this.
        This is similar to the 'Levels' tool in image processing tools.
        
        Parameters ------------------------------------------
        in_black (int)  : The input value that should become pure black, with all lower values clipped.
        in_white (int)  : The input value that should become pure white, with all higher values clipped.
        gamma (int)     : A midtone adjustment factor that brightens or darkens values between black and white without changing the endpoints.
        out_black (int) : The output value that replaces pure black after processing, effectively lifting the darkest tones.
        out_white (int) : The output value that replaces pure white after processing, effectively lowering the brightest tones.
        
        # Example usage
        im = pilomarimage()
        im.LoadFile("input.jpg")
        result = im.ApplyLevelsBuffer(im.ImageBuffer, in_black=20, in_white=230, gamma=0.8)
        cv2.imwrite("output.jpg", result)
        """
        self.Log("pilomarimage",self.Name,".ApplyLevels(",in_black,in_white,gamma,out_black,out_white,")",terminal=False)
        self.ImageBuffer = self.ApplyLevelsBuffer(self.ImageBuffer,in_black=in_black, in_white=in_white, gamma=gamma, out_black=out_black, out_white=out_white)
        self.ActionList.append(['applylevels',in_black,in_white,gamma,out_black,out_white])

        return True
        
    def FFTSharpness(self):
        """ Assess sharpness of image using FFT method. 
            Advantages: Less affected by background gradients; suitable for faint star fields.
            Limitations: Computationally more intensive.
            (Based upon AI suggested code)
            Does not modify original ImageBuffer. """
        img = self.NewBufferType("grayscale")
        f = np.fft.fft2(img)
        fshift = np.fft.fftshift(f)
        magnitude_spectrum = np.abs(fshift)

        rows, cols = img.shape
        crow, ccol = rows // 2, cols // 2
        mask = np.ones((rows, cols), np.uint8)
        mask[crow-20:crow+20, ccol-20:ccol+20] = 0  # suppress low frequencies

        high_freq_energy = np.sum(magnitude_spectrum * mask)
        return high_freq_energy

    def CalculateStarSpread(self):
        """ Calculate an approximation for the % of the frame that contains stars. 
            LOW values mean that the stars are not spread out evenly across the frame. 
            HIGH values mean that the stars are spread out more evenly across the frame.
            Sets % value for each axis and the total image. """
        if self.ImageExists() and len(self.StarList) > 0: # There's an image loaded and stars were identified.
            HMin = None # Lowest 'X' position of a star.
            HMax = None # Highest 'X' position of a star.
            VMin = None # Lowest 'Y' position of a star.
            VMax = None # Highest 'Y' position of a star.
            for star in self.StarList: # Each star is a list of [x, y, radius]
                if HMin == None or HMin > star[0]: HMin = star[0]
                if HMax == None or HMax < star[0]: HMax = star[0]
                if VMin == None or VMin > star[1]: VMin = star[1]
                if VMax == None or VMax < star[1]: VMax = star[1]
            self.HorizontalSpread = 100 * (HMax - HMin) / self.GetWidth()
            self.VerticalSpread = 100 * (VMax - VMin) / self.GetHeight()
            self.AreaSpread = 100 * ((self.HorizontalSpread / 100) * (self.VerticalSpread / 100))
            result = True
        else: # There's no image, or no stars were identified.
            self.HorizontalSpread = self.VerticalSpread = self.AreaSpread = 0 # No spread to measure.
            result = False
        return result

    def NextInterpolation(self):
        """ Move on to the next available sampling method. """
        self.Log("pilomarimage",self.Name,".NextInterpolation()",terminal=False)
        i = (self.ResizeMethods.index(self.ResizeMethod) + 1) % len(self.ResizeMethods)
        self.ResizeMethod = self.ResizeMethods[i]
        self.ActionList.append(['nextinterpolation',self.ResizeMethod])
        
    def PrevInterpolation(self):
        """ Move back to the previous available sampling method. """
        self.Log("pilomarimage",self.Name,".PrevInterpolation()",terminal=False)
        i = (self.ResizeMethods.index(self.ResizeMethod) - 1) % len(self.ResizeMethods)
        self.ResizeMethod = self.ResizeMethods[i]
        self.ActionList.append(['previnterpolation',self.ResizeMethod])
    
    def NowUTC(self):
        """ Return system UTC timestamp. """
        return datetime.now(timezone.utc)
        
    def Clear(self):
        """ Clear the image buffer and related attributes. """
        self.Log("pilomarimage",self.Name,".Clear()",terminal=False)
        self._initialize()
        self.ActionList.append(['clear'])
        self.CreatedTimestamp = self.NowUTC()
        self.ModifiedTimestamp = self.NowUTC()
 
    def OpenCVtoPIL(self,opencv_buffer):
        """ Convert an OpenCV buffer into a PIL buffer. """
        pil_buffer = Image.fromarray(opencv_buffer)
        return pil_buffer

    def PILtoOpenCV(self,pil_buffer):
        """ Convert a PIL (Pillow) image buffer into an OpenCV buffer. """
        opencv_buffer = np.asarray(pil_buffer)
        return opencv_buffer
        
    def LoadBuffer(self,imagebuffer):
        """ Import an existing OpenCV/Numpy image buffer into the main ImageBuffer.. """
        self.Log("pilomarimage",self.Name,".LoadBuffer()",terminal=False)
        self.Clear()
        if type(imagebuffer) != type(None):
            self.ImageBuffer = imagebuffer.copy()
            self.ModifiedTimestamp = self.NowUTC()
        else:
            self.Log("pilomarimage",self.Name,".LoadBuffer(). FROM buffer is None.",terminal=False)
        return self.ImageExists()
        
    def AccumulateBuffer(self,buffer):
        """ Accumulate values in a buffer into a running total buffer. 
            buffer is a reference to another pilomarimage instance."""
        self.Log("pilomarimage",self.Name,".AccumulateBuffer()",terminal=False)
        if isinstance(self.ImageAccumulator,type(None)): # Initialize accumulator.
            self.ImageAccumulator = np.zeros_like(buffer.ImageBuffer,np.uint16) # Create array of same dimensions, but with larger storage type.
            self.ImageCounter = np.zeros_like(buffer.ImageBuffer,np.uint8) # Create array of same dimensions but with uint8 storage type.
        # Now accumulate the values.
        self.ImageAccumulator.add(self.ImageAccumulator,buffer.ImageBuffer)
        self.ImageCount += 1
        self.ActionList.append(['accumulatebuffer',buffer.Name])
        self.ModifiedTimestamp = self.NowUTC()
        return True
        
    def ResolveAccumulator(self):
        self.Log("pilomarimage",self.Name,".ResolveAccumulator()",terminal=False)
        if isinstance(self.ImageAccumulator,type(None)):
            print("pilomarimage.ResolveAccumulator(): ImageAccumulator is not initialised.")
            return False
        # Create fresh image buffer.
        self.ImageBuffer = np.zeros_like(self.ImageAccumulator,np.uint8) # Create array of same dimensions, but with regular image datatype.
        self.ImageBuffer[self.ImageCount != 0] = self.ImageAccumulator / self.ImageCount
        self.ActionList.append(['resolveaccumulator'])
        self.ModifiedTimestamp = self.NowUTC()
        return True
        
    def exif_float(self,value):
        """ Convert a floating point number into an 'exif' tag compatible tuple.
            EXIF tags store floating point values as a tuple of NUMERATOR,DENOMINATOR integers.
            1.0 returns (1,1)
            0.5 returns (1,2)
            50.5 returns (101,2) """
        result = value.as_integer_ratio()
        return result
        
    #def exif_datetime_old(self,value):
    #    """ Convert a datetime value into an exif compatible time string. 
    #        exif tags expect datetime to be formatted as YYYY:MM:DD HH:MM:SS """
    #    if type(value) = str: # Convert from a string to datetime.
    #        if "T" in value: value = datetime.fromisoformat(value) # ISO format dates.
    #        elif "+" in value or "-" in value: value = datetime.strptime(value,"%Y-%m-%d %H:%M:%S%z")
    #        else: value = datetime.strptime(value,"%Y-%m-%d %H:%M:%S")
    #    else: result = value.strftime("%Y:%m:%d %H:%M:%S")
    #    return result

    def exif_datetime(self,value):
        """ Convert a datetime value into an exif compatible time string. 
            Value can be datetime or a str(datetime) object.
            result is for EXIF. Exif tags expect datetime to be formatted as YYYY:MM:DD HH:MM:SS
                                                                             0123456789012345678 """
        value = str(value) # Make sure all values are string format YYYYxMMxDDxHHxMMxSS
        result = value[0:4] + ":" + value[5:7] + ":" + value[8:10] + " " + value[11:13] + ":" + value[14:16] + ":" + value[17:19]
        return result
        
    def exif_string(self,value):
        """ Convert any value to an exif compatible string. """
        return str(value)

    def exif_int(self,value):
        """ Convert any value to an exif compatible integer. """
        try:
            value = int(round(float(str(value)),0))
        except:
            value = 0 # Any failures translate to 0 value.
        return value

    def AddExifTags(self,filename,tagdicts):
        """ Add EXIF tags to a jpeg file.
            See: https://pypi.org/project/piexif/ 

            Parameters ----------------------------------------------------
            filename: The jpeg file to update.
            tagdicts: A list of dictionaries or filenames containing EXIF tag data.
                      Can be a single dictionary or filename also.
                      If an entry is a dictionary it is parsed directly.
                      If an entry is NOT a dictionary it will be loaded from .json as a dictionary, then parsed.
                      If an entry is None, it is skipped.
                      If an entry cannot be parsed, it is skipped with a warning.
                      
            Example -------------------------------------------------------
            >>> pim = pilomarimage() # Create new pilomarimage handler.
            >>> pin.AddExifTags('myimage.jpg',{"Copyright": "owner"}) # Simplest form. Applies the dictionary of exif tags to the image file.
            
            Example -------------------------------------------------------
            >>> pim = pilomarimage() # Create new pilomarimage handler.
            >>> pin.AddExifTags('myimage.jpg','mytags.json') # Applies the contents of mytags.json to the image file.
            
            Example -------------------------------------------------------
            >>> pim = pilomarimage() # Create new pilomarimage handler.
            >>> pin.AddExifTags('myimage.jpg',['mytags_1.json','mytags_2.json','mytags_3.json']) # Applies the contents of 3 json files to the image file.
            
            
            Known EXIF tags :-                      (only a subset is generated here)
            >>> dir(piexif.ExifIFD)
            ['Acceleration', 'ApertureValue', 'BodySerialNumber', 'BrightnessValue', 'CFAPattern', 'CameraElevationAngle', 'CameraOwnerName', 'ColorSpace', 'ComponentsConfiguration', 'CompressedBitsPerPixel', 'Contrast', 'CustomRendered', 'DateTimeDigitized', 'DateTimeOriginal', 'DeviceSettingDescription', 'DigitalZoomRatio', 'ExifVersion', 'ExposureBiasValue', 'ExposureIndex', 'ExposureMode', 'ExposureProgram', 'ExposureTime', 'FNumber', 'FileSource', 'Flash', 'FlashEnergy', 'FlashpixVersion', 'FocalLength', 'FocalLengthIn35mmFilm', 'FocalPlaneResolutionUnit', 'FocalPlaneXResolution', 'FocalPlaneYResolution', 'GainControl', 'Gamma', 'Humidity', 'ISOSpeed', 'ISOSpeedLatitudeyyy', 'ISOSpeedLatitudezzz', 'ISOSpeedRatings', 'ImageUniqueID', 'InteroperabilityTag', 'LensMake', 'LensModel', 'LensSerialNumber', 'LensSpecification', 'LightSource', 'MakerNote', 'MaxApertureValue', 'MeteringMode', 'OECF', 'OffsetTime', 'OffsetTimeDigitized', 'OffsetTimeOriginal', 'PixelXDimension', 'PixelYDimension', 'Pressure', 'RecommendedExposureIndex', 'RelatedSoundFile', 'Saturation', 'SceneCaptureType', 'SceneType', 'SensingMethod', 'SensitivityType', 'Sharpness', 'ShutterSpeedValue', 'SpatialFrequencyResponse', 'SpectralSensitivity', 'StandardOutputSensitivity', 'SubSecTime', 'SubSecTimeDigitized', 'SubSecTimeOriginal', 'SubjectArea', 'SubjectDistance', 'SubjectDistanceRange', 'SubjectLocation', 'Temperature', 'UserComment', 'WaterDepth', 'WhiteBalance']
            
            >>> dir(piexif.GPSIFD)
            ['GPSAltitude', 'GPSAltitudeRef', 'GPSAreaInformation', 'GPSDOP', 'GPSDateStamp', 'GPSDestBearing', 'GPSDestBearingRef', 'GPSDestDistance', 'GPSDestDistanceRef', 'GPSDestLatitude', 'GPSDestLatitudeRef', 'GPSDestLongitude', 'GPSDestLongitudeRef', 'GPSDifferential', 'GPSHPositioningError', 'GPSImgDirection', 'GPSImgDirectionRef', 'GPSLatitude', 'GPSLatitudeRef', 'GPSLongitude', 'GPSLongitudeRef', 'GPSMapDatum', 'GPSMeasureMode', 'GPSProcessingMethod', 'GPSSatellites', 'GPSSpeed', 'GPSSpeedRef', 'GPSStatus', 'GPSTimeStamp', 'GPSTrack', 'GPSTrackRef', 'GPSVersionID']
            
            >>> dir(piexif.ImageIFD)
            ['ActiveArea', 'AnalogBalance', 'AntiAliasStrength', 'Artist', 'AsShotICCProfile', 'AsShotNeutral', 'AsShotPreProfileMatrix', 'AsShotProfileName', 'AsShotWhiteXY', 'BaselineExposure', 'BaselineNoise', 'BaselineSharpness', 'BatteryLevel', 'BayerGreenSplit', 'BestQualityScale', 'BitsPerSample', 'BlackLevel', 'BlackLevelDeltaH', 'BlackLevelDeltaV', 'BlackLevelRepeatDim', 'CFALayout', 'CFAPattern', 'CFAPlaneColor', 'CFARepeatPatternDim', 'CalibrationIlluminant1', 'CalibrationIlluminant2', 'CameraCalibration1', 'CameraCalibration2', 'CameraCalibrationSignature', 'CameraSerialNumber', 'CellLength', 'CellWidth', 'ChromaBlurRadius', 'ClipPath', 'ColorMap', 'ColorMatrix1', 'ColorMatrix2', 'ColorimetricReference', 'Compression', 'Copyright', 'CurrentICCProfile', 'CurrentPreProfileMatrix', 'DNGBackwardVersion', 'DNGPrivateData', 'DNGVersion', 'DateTime', 'DefaultCropOrigin', 'DefaultCropSize', 'DefaultScale', 'DocumentName', 'DotRange', 'ExifTag', 'ExposureIndex', 'ExposureTime', 'ExtraSamples', 'FillOrder', 'FlashEnergy', 'FocalPlaneResolutionUnit', 'FocalPlaneXResolution', 'FocalPlaneYResolution', 'ForwardMatrix1', 'ForwardMatrix2', 'GPSTag', 'GrayResponseCurve', 'GrayResponseUnit', 'HalftoneHints', 'HostComputer', 'ImageDescription', 'ImageHistory', 'ImageID', 'ImageLength', 'ImageNumber', 'ImageResources', 'ImageWidth', 'Indexed', 'InkNames', 'InkSet', 'InterColorProfile', 'Interlace', 'JPEGACTables', 'JPEGDCTables', 'JPEGInterchangeFormat', 'JPEGInterchangeFormatLength', 'JPEGLosslessPredictors', 'JPEGPointTransforms', 'JPEGProc', 'JPEGQTables', 'JPEGRestartInterval', 'JPEGTables', 'LensInfo', 'LinearResponseLimit', 'LinearizationTable', 'LocalizedCameraModel', 'Make', 'MakerNoteSafety', 'MaskedAreas', 'Model', 'NewSubfileType', 'Noise', 'NoiseProfile', 'NoiseReductionApplied', 'NumberOfInks', 'OPIProxy', 'OpcodeList1', 'OpcodeList2', 'OpcodeList3', 'Orientation', 'OriginalRawFileData', 'OriginalRawFileDigest', 'OriginalRawFileName', 'PhotometricInterpretation', 'PlanarConfiguration', 'Predictor', 'PreviewApplicationName', 'PreviewApplicationVersion', 'PreviewColorSpace', 'PreviewDateTime', 'PreviewSettingsDigest', 'PreviewSettingsName', 'PrimaryChromaticities', 'PrintImageMatching', 'ProcessingSoftware', 'ProfileCalibrationSignature', 'ProfileCopyright', 'ProfileEmbedPolicy', 'ProfileHueSatMapData1', 'ProfileHueSatMapData2', 'ProfileHueSatMapDims', 'ProfileLookTableData', 'ProfileLookTableDims', 'ProfileName', 'ProfileToneCurve', 'Rating', 'RatingPercent', 'RawDataUniqueID', 'RawImageDigest', 'ReductionMatrix1', 'ReductionMatrix2', 'ReferenceBlackWhite', 'ResolutionUnit', 'RowInterleaveFactor', 'RowsPerStrip', 'SMaxSampleValue', 'SMinSampleValue', 'SampleFormat', 'SamplesPerPixel', 'SecurityClassification', 'SelfTimerMode', 'SensingMethod', 'ShadowScale', 'Software', 'SpatialFrequencyResponse', 'StripByteCounts', 'StripOffsets', 'SubIFDs', 'SubTileBlockSize', 'SubfileType', 'T4Options', 'T6Options', 'TIFFEPStandardID', 'TargetPrinter', 'Threshholding', 'TileByteCounts', 'TileLength', 'TileOffsets', 'TileWidth', 'TimeZoneOffset', 'TransferFunction', 'TransferRange', 'UniqueCameraModel', 'WhiteLevel', 'WhitePoint', 'XClipPathUnits', 'XMLPacket', 'XPAuthor', 'XPComment', 'XPKeywords', 'XPSubject', 'XPTitle', 'XResolution', 'YCbCrCoefficients', 'YCbCrPositioning', 'YCbCrSubSampling', 'YClipPathUnits', 'YResolution']
            
            """
        if piexif == None: # Check piexif library is available.
            print("pilomarimage.AddExifTags: piexif library is not available. Try installing it.")
            return False
        if type(tagdicts) != list: tagdicts = [tagdicts] # If a single dictionary received turn it into a list.
        safedicts = [] # Build new list of validated dictionaries.
        # Convert filenames into dictionaries.
        for i,c in enumerate(tagdicts):
            #print("pilomarimage.AddExifTags: Considering",i,c)
            if c == None: continue # Ignore None values.
            if type(c) != dict: # It's not already a dictionary, so load and convert it.
                #print("pilomarimage.AddExifTags: Loading",c)
                try:
                    with open(c,'r') as f:
                        c = json.load(f)
                except Exception as e:
                    print("pilomarimage.AddExifTags: Parsing",c,"as a dictionary failed. Skipping.")
                    print("error:",e)
                    continue # Move on to the entry.
            safedicts.append(c)
            #print("pilomarimage.AddExifTags: Gathered",c)
        # If no dictionaries available, simply return.
        if len(safedicts) < 1: 
            #print("pilomarimage.AddExifTags: No dictionaries available.")
            return 
        
        im = PIL_Image.open(filename) # Open the image in PIL.
        if 'exif' in im.info: # Create empty dictionary for exif data if it's not already in the information area.
            exif_dict = piexif.load(im.info["exif"]) # Get EXIF data.
        else:
            exif_dict = {}
        for a in ["0th","Exif","GPS","1st"]: # Make sure all the sections of exif data are available.
            if not a in exif_dict:
                exif_dict[a] = {}
        w, h = im.size # Get image dimensions.
        # Beware setting these tag values. piexif does not protect you from using the wrong datatype, but it will fail upon saving.
        # If you are setting tags which expect FLOAT values you must convert your float using the self.exif_float() method.
        # Integers must be integers.
        # GPS co-ordinates expect DMS tuples with float format, but they must resolve to integer values!?! ((90,1),(30,1),(45,1))
        # Dates must be in yyyy:mm:dd hh:mm:ss format.
        # piexif /_exif.py contains dictionaries which define the datatypes for each element. There's no automatic validation in piexif.
        # If any of the datatypes are incorrect, the exception will only occur during piexif.dump(), you have to work out which tag value caused the problem.
        exif_dict["0th"][piexif.ImageIFD.XResolution] = self.exif_float(w) # Set WIDTH resolution exif tag.
        exif_dict["0th"][piexif.ImageIFD.YResolution] = self.exif_float(h) # Set HEIGHT resolution exif tag.
        exif_dict["0th"][piexif.ImageIFD.ImageWidth] = self.exif_int(w) # Set WIDTH pixels exif tag.
        exif_dict["0th"][piexif.ImageIFD.ImageLength] = self.exif_int(h) # Set WIDTH pixels exif tag.
        for tagdict in safedicts: # Process each dictionary in turn.
            for key,value in tagdict.items(): # Read through all the tags and update into the exif header.
                if key == 'Copyright': exif_dict["0th"][piexif.ImageIFD.Copyright] = self.exif_string(value) # 'owner') # Who owns the photograph?
                elif key == 'DateTime': exif_dict["0th"][piexif.ImageIFD.DateTime] = self.exif_datetime(value) # self.NowUTC())
                elif key == 'DocumentName': exif_dict["0th"][piexif.ImageIFD.DocumentName] = self.exif_string(value) # "light_yyyymmddhhmmss_01")
                elif key == 'ExposureTime': exif_dict["0th"][piexif.ImageIFD.ExposureTime] = self.exif_float(value) # 0.5) # seconds. (Store as numerator/denominator, so 0.5 = (5,10)
                elif key == 'HostComputer': exif_dict["0th"][piexif.ImageIFD.HostComputer] = self.exif_string(value) # 'pilomar')
                elif key == 'ImageDescription': exif_dict["0th"][piexif.ImageIFD.ImageDescription] = self.exif_string(value) # 'pilomar image')
                elif key == 'ImageHistory': exif_dict["0th"][piexif.ImageIFD.ImageHistory] = self.exif_string(value) # 'pilomar image')
                elif key == 'ImageID': exif_dict["0th"][piexif.ImageIFD.ImageID] = self.exif_string(value) # "light_yyyymmddhhmmss_01")
                elif key == 'Make': exif_dict["0th"][piexif.ImageIFD.Make] = self.exif_string(value) # "sony")
                elif key == 'Model': exif_dict["0th"][piexif.ImageIFD.Model] = self.exif_string(value) # "imx477")
                elif key == 'ProcessingSoftware': exif_dict["0th"][piexif.ImageIFD.ProcessingSoftware] = self.exif_string(value) # "pilomar")
                
                elif key == 'Software': exif_dict["0th"][piexif.ImageIFD.Software] = self.exif_string(value) # "pilomar")
                elif key == 'GPSDateStamp': exif_dict["GPS"][piexif.GPSIFD.GPSDateStamp] = self.exif_datetime(value) # self.NowUTC())
                ##           'GPSLatitude': (self.exif_float(54),self.exif_float(0),self.exif_float(0)) # DMS
                # GPS co-ordinates must be a tuple of 'exif float' values, but the values must be integers. piexif.dump() fails otherwise.
                elif key == 'GPSLatitude': exif_dict["GPS"][piexif.GPSIFD.GPSLatitude] = (self.exif_float(int(value[0])),self.exif_float(int(value[1])),self.exif_float(int(value[2]))) # DMS
                elif key == 'GPSLatitudeRef': exif_dict["GPS"][piexif.GPSIFD.GPSLatitudeRef] = self.exif_string(value) # 'N') # DMS
                ##           'GPSLongitude': (self.exif_float(0),self.exif_float(30),self.exif_float(0)) # DMS
                elif key == 'GPSLongitude': exif_dict["GPS"][piexif.GPSIFD.GPSLongitude] = (self.exif_float(int(value[0])),self.exif_float(int(value[1])),self.exif_float(int(value[2]))) # DMS
                elif key == 'GPSLongitudeRef': exif_dict["GPS"][piexif.GPSIFD.GPSLongitudeRef] = self.exif_string(value) # 'W') # DMS
                elif key == 'CameraOwnerName': exif_dict["Exif"][piexif.ExifIFD.CameraOwnerName] = self.exif_string(value) # 'owner') # Who owns the equipment?
                elif key == 'DateTimeOriginal': exif_dict["Exif"][piexif.ExifIFD.DateTimeOriginal] = self.exif_datetime(value) # self.NowUTC())
                
                elif key == 'DateTimeDigitized': exif_dict["Exif"][piexif.ExifIFD.DateTimeDigitized] = self.exif_datetime(value) # self.NowUTC())
                elif key == 'ExposureMode': exif_dict["Exif"][piexif.ExifIFD.ExposureMode] = self.exif_int(value) # 1) # Exposure mode - manual.
                elif key == 'FocalLength': exif_dict["Exif"][piexif.ExifIFD.FocalLength] = self.exif_float(value) # 50.0) # mm
                elif key == 'FocalLengthIn35mmFilm': exif_dict["Exif"][piexif.ExifIFD.FocalLengthIn35mmFilm] = self.exif_float(value) # 280.0) # mm
                elif key == 'Humidity': exif_dict["Exif"][piexif.ExifIFD.Humidity] = self.exif_float(value) # 80.0) # Percentage
                elif key == 'Pressure': exif_dict["Exif"][piexif.ExifIFD.Pressure] = self.exif_float(value) # 990.0) # hPa.
                elif key == 'ShutterSpeedValue': exif_dict["Exif"][piexif.ExifIFD.ShutterSpeedValue] = self.exif_float(value) # 0.5) # Exposure seconds.
                elif key == 'Temperature': exif_dict["Exif"][piexif.ExifIFD.Temperature] = self.exif_float(value) # -10.0) # C 
        exif_bytes = piexif.dump(exif_dict) # Turn exif data back into binary.
        im.save(filename, "jpeg", exif=exif_bytes, quality=100) # Save image with new exif data tags. Still at 100% quality, but some artifacts will be created.
        return True

    def merge_exif_dict(self,master_dict,*dicts):
        """ Merge secondary_dict contents into master_dict.
            Use this if you are extracting exif tags from multiple separate sources.
            This will combine values into a single dictionary. 
            You can have multiple dictionaries in a single call, they are all merged into the first one. """
        for secondary_dict in dicts: # Process each secondary dictionary listed in turn.
            for groupkey,taggroup in secondary_dict.items(): # Go through the different groups of tags.
                if not groupkey in master_dict: master_dict[groupkey] = {} # Add group if it's not already there.
                for tagname,value in taggroup.items(): # go through each tag entry in the group.
                    master_dict[groupkey][tagname] = value # Transfer the value into the master dictionary.
        return master_dict

    def print_file_exif_tags(self,filename):
        if piexif == None: # Check piexif library is available.
            print("pilomarimage.print_file_exif_tags: piexif library is not available. Try installing it.")
            return False
        exif_dict = piexif.load(filename)
        for ifd in ("0th", "Exif", "GPS", "1st"):
            print("Tags for IFD:",ifd)
            for tag in exif_dict[ifd]:
                print(ifd, # Section of exif tags.
                      piexif.TAGS[ifd][tag]["name"], # Tag within that section.
                      exif_dict[ifd][tag]) # Value of the tag.

    def ValidateExifStructure(self,dictionary):
        for a in ["0th","Exif","GPS","1st"]: # Make sure all the sections of exif data are available.
            if not a in dictionary:
                dictionary[a] = {}
        return dictionary
  
    def GetExif(self,filename):
        """ Given a disc file, load any EXIF tags available. 
            Returns a dictionary of TAG name and value.
            It does not populate self.ExifData dictionary. """
        exif_data = {} # Start with empty exif dictionary.
        if piexif != None: # piexif is available.
            try: # Try to load feom the file.
                with PIL_Image.open(filename) as im: # Use PIL to open the image.
                    if 'exif' in im.info: # Create empty dictionary for exif data if it's not already in the information area.
                        exif_data = piexif.load(im.info["exif"]) # Get EXIF data.
                    else:
                        exif_data = {}
            except Exception as e:
                print("pilomarimage.GetExif(",filename,")failed:",e)
                self.Log("pilomarimage.GetExif(",filename,") failed:",e,terminal=False)
        else:
            self.Log("pilomarimage.GetExif(",filename,") piexif not available.",terminal=False)
        exif_data = self.ValidateExifStructure(exif_data) # Make sure all the sections are available.
        
    def LoadFile(self,filename,loadexif=False):
        """ Load image buffer from disc. """
        self.Log("pilomarimage",self.Name,".LoadFile(",filename,")",terminal=False)
        self._initialize()
        self.ImageBuffer = cv2.imread(filename,cv2.IMREAD_COLOR)
        if self.ImageExists():
            self.ImageMask = np.ones_like(self.ImageBuffer,np.uint8) # All cells are active.
            self.ActionList.append(['load',filename])
            self.CreatedTimestamp = self.NowUTC()
            result = True
            if loadexif: # Also load the EXIF tags from the file.
                self.ExifData = self.GetExif(filename)
            else:
                self.ExifData = {} # Empty.
            self.Log("pilomarimage",self.Name,".LoadFile(): Loaded",self.GetDimensions(),self.GetType(),terminal=False)
        else:
            # File didn't load!
            self.Log("pilomarimage",self.Name,".LoadFile(",filename,") failed.",terminal=False)
            result = False
        return result

    def ImageFileType(self,filename):
        """ Given a filename, return a lower case file type. """
        return filename.split('.')[-1].lower()

    def SaveFile(self,filename,quality=None,library='opencv',exif_dict=None):
        """ Save image buffer to disc.
            To specify the quality for jpeg files you can use a call like this...
                cv2.imwrite(filename,self.ImageBuffer,[int(cv2.IMWRITE_JPEG_QUALITY), 90] # 90% image quality.
            Parameters ------------------------------------------------------------
            filename:  The filename to be saved.
            quality:   Set the 'quality' input parameter when making this call to override the jpg quality to your preferred value.
            library:   library can be 'opencv' or 'pil'. Image is saved via appropriate library.
                       When using pil library, it saves as .jpg files only.
            exif_dict: Can be a dictionary of exif_tags to write. Created by piexif utility. (Fill force writing via 'pil' library.)
                       If you specify EXIF tags in this parameter the library will automatically switch to 'pil'. """
        self.Log("pilomarimage",self.Name,".SaveFile(",filename,")",terminal=False)
        if exif_dict != None: 
            library = 'pil' # Must use Pillow to write files with exif tags.
        if self.ImageExists():
            if library == 'pil': # Use Pillow to write the image file.
                self.Log("pilomarimage",self.Name,".SaveFile(",filename,") via PIL.",terminal=False)
                pil_buffer = self.OpenCVtoPIL(self.ImageBuffer) # Get buffer as a PIL object.
                if exif_dict == None: exif_dict = {} # No EXIF tags to write.
                if quality == None: quality = 75 # Default to 75% quality.
                pil_buffer.save(targetfile, "jpeg", exif=exif_bytes, quality=quality) # Save with specific quality and exif tags.
            else: # Use OpenCV to write the image file.
                self.Log("pilomarimage",self.Name,".SaveFile(",filename,") via OpenCV.",terminal=False)
                if quality != None: # Image quality was specified.
                    cv2.imwrite(filename,self.ImageBuffer,[int(cv2.IMWRITE_JPEG_QUALITY), int(quality)]) # imwrite doesn't report errors very well, beware.
                else: # Image quality can be default.
                    cv2.imwrite(filename,self.ImageBuffer) # imwrite doesn't report errors very well, beware.
            self.ActionList.append(['save',filename])
        else:
            print("pilomarimage.SaveFile(",filename,"): No ImageBuffer.")
        height,width = self.GetDimensions()
        maxdim = max(height,width) # Which is the largest dimension? Some file formats have limits.
        ift = self.ImageFileType(filename) # What file type are we generating?
        if ift in ['bmp'] and maxdim > 32768: # bmp dimensions can't exceed this size.
            print("pilomarimage.SaveFile(",filename,"): Image dimensions exceed bmp limits.(",height,width,")")
        elif ift in ['jpg','jpeg'] and maxdim > 65535: # jpeg dimensions can't exceed this size.
            print("pilomarimage.SaveFile(",filename,"): Image dimensions exceed jpeg limits.(",height,width,")")
        # Check it worked. Big images fail silently!
        result = False # Failed unless a file exists which contains something.
        if os.path.exists(filename):
            if os.path.getsize(filename) == 0:
                print("pilomarimage.SaveFile(",filename,"): The file exists but it is empty.")
            else:
                result = True
        else:
            print("pilomarimage.SaveFile(",filename,"): The file was not saved.")
        return result

    def SaveBuffer(self,image_buffer,filename,quality=None,library='opencv',exif_dict=None):
        """ Save image buffer to disc.
            To specify the quality for jpeg files you can use a call like this...
                cv2.imwrite(filename,self.ImageBuffer,[int(cv2.IMWRITE_JPEG_QUALITY), 90] # 90% image quality.
            Parameters ------------------------------------------------------------
            image_buffer: An image buffer.
            filename:     The filename to be saved.
            quality:      Set the 'quality' input parameter when making this call to override the jpg quality to your preferred value.
            library:      library can be 'opencv' or 'pil'. Image is saved via appropriate library.
                          When using pil library, it saves as .jpg files only.
            exif_dict:    Can be a dictionary of exif_tags to write. Created by piexif utility. (Fill force writing via 'pil' library.)
                          If you specify EXIF tags in this parameter the library will automatically switch to 'pil'. """
        self.Log("pilomarimage",self.Name,".SaveBuffer(",filename,")",terminal=False)
        if exif_dict != None: 
            library = 'pil' # Must use Pillow to write files with exif tags.
        if type(image_buffer) != type(None):
            if library == 'pil': # Use Pillow to write the image file.
                self.Log("pilomarimage",self.Name,".SaveBuffer(",filename,") via PIL.",terminal=False)
                pil_buffer = self.OpenCVtoPIL(image_buffer) # Get buffer as a PIL object.
                if exif_dict == None: exif_dict = {} # No EXIF tags to write.
                if quality == None: quality = 75 # Default to 75% quality.
                pil_buffer.save(targetfile, "jpeg", exif=exif_bytes, quality=quality) # Save with specific quality and exif tags.
            else: # Use OpenCV to write the image file.
                self.Log("pilomarimage",self.Name,".SaveBuffer(",filename,") via OpenCV.",terminal=False)
                if quality != None: # Image quality was specified.
                    cv2.imwrite(filename,image_buffer,[int(cv2.IMWRITE_JPEG_QUALITY), int(quality)]) # imwrite doesn't report errors very well, beware.
                else: # Image quality can be default.
                    cv2.imwrite(filename,image_buffer) # imwrite doesn't report errors very well, beware.
            self.ActionList.append(['save',filename])
        else:
            print("pilomarimage.SaveBuffer(",filename,"): No ImageBuffer.")
        height = image_buffer.shape[0]
        width = image_buffer.shape[1]
        maxdim = max(height,width) # Which is the largest dimension? Some file formats have limits.
        ift = self.ImageFileType(filename) # What file type are we generating?
        if ift in ['bmp'] and maxdim > 32768: # bmp dimensions can't exceed this size.
            print("pilomarimage.SaveBuffer(",filename,"): Image dimensions exceed bmp limits.(",height,width,")")
        elif ift in ['jpg','jpeg'] and maxdim > 65535: # jpeg dimensions can't exceed this size.
            print("pilomarimage.SaveBuffer(",filename,"): Image dimensions exceed jpeg limits.(",height,width,")")
        # Check it worked. Big images fail silently!
        result = False # Failed unless a file exists which contains something.
        if os.path.exists(filename):
            if os.path.getsize(filename) == 0:
                print("pilomarimage.SaveBuffer(",filename,"): The file exists but it is empty.")
            else:
                result = True
        else:
            print("pilomarimage.SaveBuffer(",filename,"): The file was not saved.")
        return result

    def ClipImage(self,xstart,ystart,xend,yend):
        """ Clip the image. """
        self.Log("pilomarimage",self.Name,".ClipImage(",xstart,ystart,xend,yend,")",terminal=False)
        gt = self.GetType()
        if gt == 'grayscale': self.ImageBuffer = self.ImageBuffer[ystart:yend,xstart:xend]
        else: self.ImageBuffer = self.ImageBuffer[ystart:yend,xstart:xend,:]
        self.ActionList.append(['clip',xstart,ystart,xend,yend])
        self.ModifiedTimestamp = self.NowUTC()
        return True
        
    def ScaleImage(self,scale=None,vscale=None,hscale=None,width=None,height=None):
        """ Scale the current image buffer by 'scale' ratio.
            scale is applied in both dimensions.
            vscale is applied to vertical only.
            hscale is applied to horizontal only. 
            width is absolute width to produce.
            height is absolute height to produce. """
        self.Log("pilomarimage",self.Name,".ScaleImage(",scale,")",terminal=False)
        if width == None or height == None: # No absolute value given.
            if scale != None: # Same scale in both directions.
                vscale = scale
                hscale = scale
            if vscale <= 0.0:
                print("pilomarimage.ScaleImage(vscale",vscale,") must be > 0.0")
                return False
            if hscale <= 0.0:
                print("pilomarimage.ScaleImage(hscale",hscale,") must be > 0.0")
                return False
            height = int(self.ImageBuffer.shape[0] * vscale)
            width = int(self.ImageBuffer.shape[1] * hscale)
        self.Log("pilomarimage",self.Name,".ScaleImage: Dimensions h",height,"w",width,terminal=False)
        self.ImageBuffer = cv2.resize(self.ImageBuffer,(width,height),interpolation=self.ResizeMethod) # Note RESIZE takes (width,height) rather than usual openCV (height,width)!
        self.ActionList.append(['scale',scale,vscale,hscale,(width,height)])
        self.ModifiedTimestamp = self.NowUTC()
        return True

    def NormalizeBuffer(self,image_buffer,min_out,max_out,min_in=None,max_in=None):
        """ Normalize values of an array to between min_out and max_out.
            Parameters ------------------------------------
            image_buffer : The array to normalise.
            min_out      : The minimum value in the normalised result.
            max_out      : The maximum value in the normalised result.
            min_in       : Default None: If set, forces the minimum value for input numbers.
            max_in       : Default None: If set, forces the maximum value for input numbers. """
        image_buffer = image_buffer.astype(np.float32) # Convert to floating point.
        c_min = np.min(image_buffer)
        c_max = np.max(image_buffer)
        if min_in != None: c_min = min(c_min,min_in) # Force a minimum input value even if it's not in the array.
        if max_in != None: c_max = max(c_max,max_in) # Firce a maximum input value even if it's not in the array.
        c_span = c_max - c_min
        self.Log("pilomarimage.NormalizeArray(): Output limits: min:",min_out,"max:",max_out,"span:",(max_out - min_out))
        self.Log("pilomarimage.NormalizeArray(): Input limits: min:",c_min,"max:",c_max,"span:",c_span)
        try:
            result_buffer = ((max_out - min_out) * (image_buffer - c_min) / c_span) + min_out # Normalize to new range.
        except Exception as e:
            print("pilomarimage.NormalizeArray(",min_out,max_out,") failed:",e)
            self.Log("pilomarimage.NormalizeArray(): error_NormalizeArray_001:",e,terminal=True)
            self.Log("pilomarimage.NormalizeArray",min_out,max_out,')failed.',terminal=True)
            result_buffer = np.clip(image_buffer.astype(np.float32),0,max_out) # Couldn't normalize, so clip instead.
        return result_buffer

    def DrawContours(self,contourcolor=(255,255,255),thickness=1,lower_t=30,upper_t=200):
        """ WIP: Create new image buffer with contours added. """
        image_buffer = self.ImageBuffer.copy() # Get copy of the current image.
        normal_buffer = self.NormalizeBuffer(image_buffer,0,255) # Normalize first to enhance the image.
        image_buffer = self.DrawBufferContours(normal_buffer,contourcolor=contourcolor,thickness=thickness,lower_t=lower_t,upper_t=upper_t)
        #gray = self.NewBufferType('grayscale') # Get grayscale copy of the current image.
        #edges = cv2.Canny(gray, 30, 200) # Find Canny edges 
        #contour_list, _ = cv2.findContours(edges, cv2.RETR_EXTERNAL, cv2.CHAIN_APPROX_NONE) 
        #image_buffer = cv2.drawContours(image_buffer, contour_list, -1, contourcolor, thickness) # -1 = 'draw all the detected contours'
        return image_buffer        
    
    def DrawBufferContours(self,image_buffer,contourcolor=(255,255,255),thickness=1,lower_t=30,upper_t=200):
        """ WIP: Create new image buffer with contours added. """
        normal_buffer = self.NormalizeBuffer(image_buffer,0,255) # Normalize first to enhance the image.
        gray = self.ChangeBufferType(normal_buffer,'grayscale') # Get grayscale copy of the current image.
        edges = cv2.Canny(gray, lower_t, upper_t) # Find Canny edges 
        contour_list, _ = cv2.findContours(edges, cv2.RETR_EXTERNAL, cv2.CHAIN_APPROX_NONE) 
        image_buffer = cv2.drawContours(image_buffer, contour_list, -1, contourcolor, thickness) # -1 = 'draw all the detected contours'
        return image_buffer
    
    def HorizontalBlurImage(self,band):
        """ Shrink the current image buffer horizontally, averaging the colors. 
            Then return the image buffer to the correct width, blurring that average across the image. 
            band = the pixel width that the image is horizontally compressed to. """
        self.Log("pilomarimage",self.Name,".HorizontalBlurImage(",band,")",terminal=False)
        height = int(self.ImageBuffer.shape[0])
        originalwidth = int(self.ImageBuffer.shape[1])
        scale = band / originalwidth
        if scale <= 0.0:
            print("pilomarimage.HorizontalBlurImage(scale",scale,") must be > 0.0")
            return False
        width = int(originalwidth * scale)
        self.Log("pilomarimage",self.Name,".HorizontalBlureImage: Dimensions h",height,"w",width,terminal=False)
        self.ImageBuffer = cv2.resize(self.ImageBuffer,(width,height),interpolation=cv2.INTER_AREA) # INTER_AREA better for SHRINKING.
        self.ImageBuffer = cv2.resize(self.ImageBuffer,(originalwidth,height),interpolation=cv2.INTER_LINEAR) # INTER_LINEAR and INTER_CUBIC best for STRETCHING.
        self.ActionList.append(['horizontalblurimage',scale,(width,height)])
        self.ModifiedTimestamp = self.NowUTC()
        return True

    def HorizontalBlurBuffer(self,buffer,band):
        """ Shrink the current image buffer horizontally, averaging the colors. 
            Then return the image buffer to the correct width, blurring that average across the image. 
            buffer = the image buffer to work on.
            band = the pixel width that the image is horizontally compressed to. """
        self.Log("pilomarimage",self.Name,".HorizontalBlurBuffer(",band,")",terminal=False)
        height = int(buffer.shape[0])
        originalwidth = int(buffer.shape[1])
        scale = band / originalwidth
        if scale <= 0.0:
            print("pilomarimage.HorizontalBlurBuffer(scale",scale,") must be > 0.0")
            return False
        width = int(originalwidth * scale)
        self.Log("pilomarimage",self.Name,".HorizontalBlureImage: Dimensions h",height,"w",width,terminal=False)
        buffer = cv2.resize(buffer,(width,height),interpolation=cv2.INTER_AREA) # INTER_AREA better for SHRINKING.
        buffer = cv2.resize(buffer,(originalwidth,height),interpolation=cv2.INTER_LINEAR) # INTER_LINEAR and INTER_CUBIC best for STRETCHING.
        self.ActionList.append(['horizontalblurimage',scale,(width,height)])
        self.ModifiedTimestamp = self.NowUTC()
        return buffer

    def PercentageBuffer(self,buffer,percentage):
        """ Dim a buffer to input percentage. 
            percentage = 0 : Buffer is fully black. 
            percentage = 50 : Buffer is reduced by 50%. 
            percentage = 100 : Buffer is returned unchanged. """
        self.Log("pilomarimage",self.Name,".PercentageBuffer()",terminal=False)
        pc = percentage / 100
        buffer = cv2.multiply(buffer,(pc,pc,pc,1.0))
        return buffer 
        
    def SubtractBuffer(self,buffer):
        """ Subtract 'buffer' from the main image buffer. """
        self.Log("pilomarimage",self.Name,".SubtractBuffer()",terminal=False)
        self.ImageBuffer = cv2.subtract(self.ImageBuffer,buffer)
        self.ActionList.append(['subtractbuffer'])
        self.ModifiedTimestamp = self.NowUTC()
        return True
    
    def CloneImage(self,donor):
        """ Make this a copy of some other buffer.
            donor is a reference to another pilomarimage instance. """
        self.Log("pilomarimage",self.Name,".CloneImage(",donor.Name,")",terminal=False)
        if isinstance(donor.ImageBuffer,type(None)): self.ImageBuffer = None 
        else: self.ImageBuffer = donor.ImageBuffer.copy()
        if isinstance(donor.ImageMask,type(None)): self.ImageMask = None 
        else: self.ImageMask = donor.ImageMask.copy()
        if isinstance(donor.ImageAccumulator,type(None)): self.ImageAccumulator = None 
        else: self.ImageAccumulator = donor.ImageAccumulator.copy()
        if isinstance(donor.ImageCounter,type(None)): self.ImageCounter = None 
        else: self.ImageCounter = donor.ImageCounter.copy()
        self.ActionList = [['__version__',str(pilomarimage.__version__)]]
        self.CreatedTimestamp = self.CreatedTimestamp
        self.ModifiedTimestamp = donor.ModifiedTimestamp
        self.StarList = donor.StarList
        self.StarCount = donor.StarCount
        self.ActionList.append(['cloneimage',donor.Name])
        return self.ImageExists()

    def CombineImage(self,donor):
        """ Add donor image to this image. 
            Performs simple addition of the two images. 
            Values clipped between 0 and 255 though. """
        tempimage = self.ImageBuffer.copy().astype(np.uint16)
        tempimage = np.add(tempimage,donor)
        tempimage = np.clip(tempimage,0,255).astype(np.uint8) # Clip to uint8 values.
        self.ImageBuffer = tempimage
        self.ActionList.append(['combineimage',donor.Name])
        self.ModifiedTimestamp = self.NowUTC()
        return True
        
    def MergeLayer(self,donor):
        """ Merge a donor image as a new layer on top of the current buffer. 
            *Q* UNDER DEVELOPMENT! 
            Several ways to perform a merge. This is testing a couple of them. 
            Likely to change in the future. """
        self.Log("pilomarimage",self.Name,".MergeLayer(",donor.Name,")",terminal=False)
        gt = self.GetType()
        if gt == 'grayscale': # Grayscale images inherit the average of the two arrays.
            self.ImageBuffer = ((self.ImageBuffer + donor.ImageBuffer) / 2).astype(np.uint8)
        elif gt == 'bgr': # BGR images inherit average of the two arrays.
            self.ImageBuffer = ((self.ImageBuffer + donor.ImageBuffer) / 2).astype(np.uint8)
        else: # BGRA can use the 'A' channel to decide how much to inherit.
            b1 = self.ImageBuffer.copy().astype(np.float16) / 255 # Scale everything 0.0 - 1.0
            b2 = donor.ImageBuffer.copy.astype(np.float16) / 255
            alpha = b2[:,:,3] # Extract alpha channel.
            b1[:,:,:3] = b1 * (1 - alpha) # Apply alpha to BGR channels (All X, All Y and 0,1,2 channels. Not Alpha channel (3).
            b2[:,:,:3] = b2 * alpha
            self.ImageBuffer = np.add(b1,b2) # Add two arrays.
            self.ImageBuffer = self.ImageBuffer * 255 # Scale back up to 0-255
            self.ImageBuffer = self.ImageBuffer.astype(np.uint8) # Convert from float back to uint8
        self.ActionList.append(['mergelayer',donor.Name])
        self.ModifiedTimestamp = self.NowUTC()

    def CenterCoordinates(self):
        """ Return current center of the image. """
        x = int(round(self.GetWidth() / 2,0))
        y = int(round(self.GetHeight() / 2,0))
        return x,y

    def RotateCoordinates(self,x,y,angle):
        """ Transpose coordinates to account for image rotating.
            Only supports 0,90,180,270 rotations at the moment. """
        angle = angle % 360 # Convert to 0-359 degrees.
        if angle == 270:
            newx = y
            newy = self.GetHeight() - x
        elif angle == 180:
            newx = self.GetWidth() - x
            newy = self.GetHeight() - y
        elif angle == 90:
            newx = self.GetWidth() - y
            newy = x
        else: # Angle = 0, which means don't rotate anything.
            newx = x
            newy = y
        return newx,newy

    def SetAltAzRange(self,alt_min,alt_max,az_min,az_max,az_offset=180):
        """ Set control values for alt/az diagrams.
            Methods like AltAzToPixel() and PixelToAltAx() use these limits. """
        self.AltMin = alt_min # Minimum altitude that bottom of image represents.
        self.AltMax = alt_max # Maximum altitude that top of image represents.
        self.AzMin = az_min # Minimum azimuth that width of image represents.
        self.AzMax = az_max # Maximum azimuth that width of image represents.
        self.AzOffset = az_offset # Offset angle for the ZERO point in the azimuth. Eg: 180 puts the 0 point 180 degrees into the image (ie the center).

    def AltSpan(self):
        """ Return the altitude degree span of the image. """
        return self.AltMax - self.AltMin
        
    def AzSpan(self):
        """ Return the azimuth degree span of the image. """
        return self.AzMax - self.AzMin
        
    def LatLonToPixel(self,lat,lon):
        """ Convert a Lat/Lon pair into a coordinate in the image buffer.
            Lat in range -90 to 90.
            lon in range 0 to 360 (can wrap).
            Lat increases from bottom to top of image (opposite to image addressing)
            lon increases from left to right (same as image addressing).
            Lat 0 = center of image.
            lon 0 = center of image.
            x,y returned as integers.
            Note: Does not apply OrientHeight() or OrientCoord(). """            
        max_height, max_width = self.GetLimits()
        lat -= self.AltMin # Shift the altitude so that the minimum value falls at the bottom of the image.
        lon = (lon + self.AzOffset) % 360 # Shift longitude so that 0 is in center of the image, and keep all values in range 0 - 360 degrees.
        x = int(round(max_width * lon / self.AzSpan(),0))
        y = int(round(max_height * lat / self.AltSpan(),0))
        return x,y

    def AltAzToPixel(self,alt,az):
        """ Convert an Alt/Az pair into a coordinate in the image buffer.
            alt in range -90 to 90.
            az in range 0 to 360 (can wrap).
            alt increases from bottom to top of image (opposite to image addressing)
            az increases from left to right (same as image addressing).
            alt 0 = center of image.
            az 0 = center of image.
            x,y returned as integers.
            Note: Does not apply OrientHeight() or OrientCoord()! """            
        max_height, max_width = self.GetLimits()
        alt -= self.AltMin # Shift the altitude so that the minimum value falls at the bottom of the image.
        az = (az + self.AzOffset) % 360 # Shift azimuth so that 0 is in center of the image, and keep all values in range 0 - 360 degrees.
        x = int(round(max_width * az / self.AzSpan(),0))
        y = int(round(max_height * alt / self.AltSpan(),0))
        return x,y

    #def AltAzToPixel_xxx(self,alt,az):
    #    """ Convert an Alt/Az pair into a coordinate in the image buffer.
    #        alt in range -90 to 90.
    #        az in range 0 to 360 (can wrap).
    #        alt increases from bottom to top of image (opposite to image addressing)
    #        az increases from left to right (same as image addressing).
    #        alt 0 = center of image.
    #        az 0 = center of image.
    #        x,y returned as integers.
    #        *Q* Does not yet respect OrientHeight() or OrientCoord()! """            
    #    image_height, image_width = self.GetDimensions()
    #    alt += 90 # Get in range 0 - 180. So that an input '0' is in the center of the image.
    #    az = (az + 180) % 360 # Shift azimuth so that 0 is in center of the image.
    #    x = int(image_width * az / 360)
    #    y = int(image_height - (image_height * alt / 180))
    #    return x,y

    def PixelToLatLon(self,x,y):
        """ Convert an x,y coordinate pair into an Lat/Lon pair. 
            imagehandle must be a pilomarimage compatible instance. 
            x in range 0 <-> (image_width -1) 
            y in range 0 <-> (image_height -1) 
            lat in range -90 to 90.
            lon in range 0 to 360 (can wrap).
            lat increases from bottom to top of image (opposite to image addressing)
            lon increases from left to right (same as image addressing).
            lat 0 = center of image.
            lon 0 = center of image. 
            lat/lon returned as float. 
            NOTE: Does not apply OrientHeight() or OrientCoord()! """
        max_y, max_x = self.GetLimits()
        lon = float(self.AzSpan()) * x / max_x # Convert pixel to degrees.
        lon = (lon - self.AzOffset) % 360 # az 0 is in the centre of the image, so shift values by 180degrees to get back to simple linear scale.
        y = max_y - y # Invert 'y' value because we measure angles from bottom up.
        lat = float(self.AltSpan()) * y / max_y # Convert pixel to degrees.
        lat = lat + self.AltMin # alt 0 is in the centre of the image, so shift values by 90 degrees to get back to -90 to 90 scale.
        return lat,lon

    def PixelToAltAz(self,x,y):
        """ Convert an x,y coordinate pair into an Alt/Az pair. 
            imagehandle must be a pilomarimage compatible instance. 
            x in range 0 <-> (image_width -1) 
            y in range 0 <-> (image_height -1) 
            alt in range -90 to 90.
            az in range 0 to 360 (can wrap).
            alt increases from bottom to top of image (opposite to image addressing)
            az increases from left to right (same as image addressing).
            alt 0 = center of image.
            az 0 = center of image. 
            alt/az returned as float. 
            NOTE: Does not apply OrientHeight() or OrientCoord()! """
        max_y, max_x = self.GetLimits()
        az = float(self.AzSpan()) * x / max_x # Convert pixel to degrees.
        az = (az - self.AzOffset) % 360 # az 0 is in the centre of the image, so shift values by 180degrees to get back to simple linear scale.
        y = max_y - y # Invert 'y' value because we measure angles from bottom up.
        alt = float(self.AltSpan()) * y / max_y # Convert pixel to degrees.
        alt = alt + self.AltMin # alt 0 is in the centre of the image, so shift values by 90 degrees to get back to -90 to 90 scale.
        return alt,az 

    #def PixelToAltAz_xxx(self,x,y):
    #    """ Convert an x,y coordinate pair into an Alt/Az pair. 
    #        imagehandle must be a pilomarimage compatible instance. 
    #        x in range 0 <-> (image_width -1) 
    #        y in range 0 <-> (image_height -1) 
    #        alt in range -90 to 90.
    #        az in range 0 to 360 (can wrap).
    #        alt increases from bottom to top of image (opposite to image addressing)
    #        az increases from left to right (same as image addressing).
    #        alt 0 = center of image.
    #        az 0 = center of image. 
    #        alt/az returned as float. 
    #        *Q* Does not yet respect OrientHeight() or OrientCoord()! """
    #    image_height, image_width = self.GetDimensions()
    #    max_y = image_height - 1
    #    max_x = image_width - 1
    #    az = float(360) * x / max_x # Convert pixel to degrees.
    #    az = (az - 180) % 360 # az 0 is in the centre of the image, so shift values by 180degrees to get back to simple linear scale.
    #    y = max_y - y # Invert 'y' value because we measure angles from bottom up.
    #    alt = float(180) * y / max_y # Convert pixel to degrees.
    #    alt = alt - 90 # alt 0 is in the centre of the image, so shift values by 90 degrees to get back to -90 to 90 scale.
    #    return alt,az
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
