Kgotso-Koete/pilomar/src/pilomarmemory.py

#!/usr/bin/python

# Pilomar's cpu monitor class.

# This software is published under the GNU General Public License v3.0.
# Also respect any pre-existing terms of any components that this incorporates.

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
from pilomaroscommand import oscommand # OS Command execution.
from pilomartimer import timer # Pilomar's timer class.
import tracemalloc # Memory allocation tracking.
import sys

class memorymonitor(): # 1 references.
    """ Simple class to monitor the memory load of the RPi. """

    def __init__(self,logger=None):
        self.Log = logger # Define which logger to use.
        self.oscommand = oscommand(logger=logger)
        self.osCmd = self.oscommand.Execute
        self.osCmdCode = self.oscommand.ExecuteCode
        self.Command = "free -m"
        self.Timer = timer(60) # Set timer for 60 seconds.
        self.MemoryTotal = 0
        self.MemoryUsed = 0
        self.MemoryFree = 0
        self.UsedHistory = []
        self.FreeHistory = []
        self.Poll(force=True) # Kickstart the values.

    def start_trace(self):
        tracemalloc.start()

    def read_trace(self):
        result = tracemalloc.get_traced_memory()
        if self.Log != None: self.Log("memorymonitor.read_trace(). current/peak:",result,terminal=False)
        return result

    def snapshot_trace(self):
        snapshot = tracemalloc.take_snapshot()
        top_stats = snapshot.statistics('lineno')
        if self.Log != None: 
            for stat in top_stats:
                self.Log("memorymonitor.snapshot_trace():",stat,terminal=False)
        return top_stats
        
    def stop_trace(self):
        tracemalloc.stop()
    
    def item_sizes(self):
        result = {}
        idx = 0
        # Globals
        #for name, size in sorted(((name, sys.getsizeof(value)) for name, value in list(globals().items())), key= lambda x: -x[1])[:10]:
        for name, size in sorted(((name, sys.getsizeof(value)) for name, value in list(globals().items())), key= lambda x: -x[1]):
            result[idx] = {'name':name, 'size':size, 'scope':'global'}
            idx += 1
            #print("{:>30}: {:>8}".format(name, sizeof_fmt(size)))
            if self.Log != None:
                self.Log("memorymonitor.item_sizes():Globals:",name,size,terminal=False)
        ## Locals
        ##for name, size in sorted(((name, sys.getsizeof(value)) for name, value in list(locals().items())), key= lambda x: -x[1])[:10]:
        #for name, size in sorted(((name, sys.getsizeof(value)) for name, value in list(locals().items())), key= lambda x: -x[1]):
        #    result[idx] = {'name':name, 'size':size, 'scope':'global'}
        #    idx += 1
        #    #print("{:>30}: {:>8}".format(name, sizeof_fmt(size)))
        #    if self.Log != None:
        #        self.Log("memorymonitor.item_sizes():Locals:",name,size,terminal=False)
        return result

    def Poll(self,force = False):
        """ Decide if it is time to update the memory usage statistics. 
            'Free' memory is based upon the 'available memory' figure rather than the 'free' column.
            This is because 'free' is missing memory allocated to the O/S cache. 
            'available' shows something closer to the memory that the system COULD allocate to running programs. """
        #    $ free -m
        #                  total        used        free      shared  buff/cache   available
        #    Mem:           1815         175         216           1        1423        1548   <- This line is used.
        #    Swap:            99          33          66
        if force or self.Timer.Due(): # Time to update the CPU figures.
            lines = self.osCmd(self.Command)  # osCmd function dedicated to the MAIN thread.
            memoryfields = lines[1].split() # This splits by blocks of whitespace.
            if len(memoryfields) > 2:
                self.MemoryTotal = int(memoryfields[1]) * 1000000 # Total
                self.MemoryUsed = int(memoryfields[2]) * 1000000 # Used
                self.MemoryFree = int(memoryfields[6]) * 1000000 # 'Available' (Because FREE column is misleading.)
            self.UsedHistory.append(self.MemoryUsed)
            self.FreeHistory.append(self.MemoryFree)
            self.UsedHistory = self.UsedHistory[-10:] # Last 10 entries only.
            self.FreeHistory = self.FreeHistory[-10:] # Last 10 entries only.

    def GetMemory(self,force=False):
        """ Return recent memory usage statistics. """
        self.Poll(force=force)
        return self.MemoryTotal, self.MemoryUsed, self.MemoryFree
        
    def GetTotal(self,force=False) -> int:
        """ Return recent total memory value. """
        self.Poll(force=force)
        return self.MemoryTotal

    def GetUsed(self,force=False) -> int:
        """ Return recent used memory value. """
        self.Poll(force=force)
        return self.MemoryUsed

    def GetFree(self,force=False) -> int:
        """ Return recent free memory value. """
        self.Poll(force=force)
        return self.MemoryFree

    def GetUsedRange(self,force=False) -> str:
        """ Return recent range of memory full. """
        self.Poll(force=force)
        result = ''
        if len(self.UsedHistory) > 5:
            MinUsed = int(100 * min(self.UsedHistory) / self.MemoryTotal)
            MaxUsed = int(100 * max(self.UsedHistory) / self.MemoryTotal)
            result = '(' + str(MinUsed) + "% - " + str(MaxUsed) + "%" + ')'
        return result

    def GetFreeRange(self,force=False) -> str:
        """ Return recent range of memory free. """
        self.Poll(force=force)
        result = ''
        if len(self.FreeHistory) > 5:
            MinFree = int(100 * min(self.FreeHistory) / self.MemoryTotal)
            MaxFree = int(100 * max(self.FreeHistory) / self.MemoryTotal)
            result = '(' + str(MinFree) + "% - " + str(MaxFree) + "%" + ')'
        return result
