Kgotso-Koete/pilomar/src/textcolor.py

#!/usr/bin/python

# textcolor library. For formatting simple puTTY terminal text.

# This software is published under the GNU General Public License v3.0.
# Also respect any pre-existing terms of any components that this incorporates.

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
import subprocess
import curses # For non-blocking keyboard scan.
from datetime import datetime,timezone
import pytz # Timezone handling.
import time
import traceback # For exception handling in menu.
import json # To dump dictionaries for export.
import locale # Internationalisation support.
from pathlib import Path # For navigating folder structure.
import os 

class keyboardscanner(): # Curses class to scan keyboard.
    """ Use curses library to scan the keyboard (non-blocking).
        Example: if keyboardscanner.Check().lower() == "x": break
    """
    
    __version__ = '0.0.1'
    
    def __init__(self):
        """    
            Parameters ---------------------------------------
            n/a

            References ---------------------------------------
            n/a

            Sets ---------------------------------------------
            Parameters.DisplayTZ
            ObservationStatusWindow
            ImageStatusWindow
            SessionWindow

            Returns ------------------------------------------
            n/a          
            
            Usage --------------------------------------------
            
            from textcolor import keyboardscanner
            Keyboard = keyboardscanner() # Non-Blocking reader of the keyboard (via curses library).
            while True:
                keypress = Keyboard.Check().lower()
                if keypress != "": print(keypress)
                
        """
        self.CurrentKeyCode = -1
        self.CurrentCharacter = ''
        self.Translations = { # Character sequences can be translated into these more meaningful values.
            chr(9): 'tab',
            chr(10): 'enter',
            chr(27): 'esc',
            chr(27) + chr(91) + chr(97): 'cursorup',
            chr(27) + chr(91) + chr(98): 'cursordown',
            chr(27) + chr(91) + chr(99): 'cursorright',
            chr(27) + chr(91) + chr(100): 'cursorleft',
            chr(265): 'f1',
            chr(267): 'f2'
        }

    def Scan(self,stdscr): # Non-blocking check for keypress.
        """ Non-blocking check for keypress. 
            
            Parameters ---------------------------------------
            n/a

            References ---------------------------------------
            n/a

            Sets ---------------------------------------------
            Parameters.DisplayTZ
            ObservationStatusWindow
            ImageStatusWindow
            SessionWindow

            Returns ------------------------------------------
            n/a          """
        stdscr.nodelay(True)  # do not wait for input when calling getch
        self.CurrentKeyCode = stdscr.getch()
        self.CurrentCharacter = ''
        if self.CurrentKeyCode > -1:
            self.CurrentCharacter = chr(self.CurrentKeyCode)

    def WaitForKeypress(self,timeout): # Pause set number of seconds, waiting for keyboard input.
        """ Pause for a set number of seconds, but scan the keyboard. 
            Any input will interrupt the delay and be returned.
            timeout = number of seconds to wait.
            Keyboard is checked every second.     
            Parameters ---------------------------------------
            n/a

            References ---------------------------------------
            n/a

            Sets ---------------------------------------------
            Parameters.DisplayTZ
            ObservationStatusWindow
            ImageStatusWindow
            SessionWindow

            Returns ------------------------------------------
            n/a          """
        keypress = ""
        while keypress == "" and timeout > 0:
            time.sleep(1)
            timeout -= 1
            keypress = self.Scan()
        return keypress

    def Check(self): # Return any currently pressed key
        """    
            Parameters ---------------------------------------
            n/a

            References ---------------------------------------
            n/a

            Sets ---------------------------------------------
            Parameters.DisplayTZ
            ObservationStatusWindow
            ImageStatusWindow
            SessionWindow

            Returns ------------------------------------------
            n/a           """
        curses.wrapper(self.Scan)
        return self.CurrentCharacter

    def Translate(self,string): # Translate escape codes into human readable name.
        """ Translate a string of character codes into descriptive text. 
            eg code 27 becomes 'esc'    
            Parameters ---------------------------------------
            n/a

            References ---------------------------------------
            n/a

            Sets ---------------------------------------------
            Parameters.DisplayTZ
            ObservationStatusWindow
            ImageStatusWindow
            SessionWindow

            Returns ------------------------------------------
            n/a           """
        result = self.Translations(string,string) # If the character string can be translated, convert it here.
        return result
        
    def StringCheck(self,translate=False): # Non-blocking check for keypress. Handles complex strings.
        """ Non-blocking check for keypress. 
            Concatenates entire queue of keypresses into a single value.
            translate=True: Some character sequences are translated into more meaningful values.     
            Parameters ---------------------------------------
            n/a

            References ---------------------------------------
            n/a

            Sets ---------------------------------------------
            Parameters.DisplayTZ
            ObservationStatusWindow
            ImageStatusWindow
            SessionWindow

            Returns ------------------------------------------
            n/a          """
        keypress = ''
        key_a = self.Check()
        while key_a != '': # Pull entire buffer of characters in one go.
            keypress += key_a
            key_a = self.Check()    
        if translate: keypress = self.Translate(keypress)
        return keypress

    def Flush(self): # Flush any pending keypresses from the buffer.
        """ Flush any pending keypresses from the buffer.     
            Parameters ---------------------------------------
            n/a

            References ---------------------------------------
            n/a

            Sets ---------------------------------------------
            Parameters.DisplayTZ
            ObservationStatusWindow
            ImageStatusWindow
            SessionWindow

            Returns ------------------------------------------
            n/a          """
        while self.Check() != '': pass

# ------------------------------------------------------------------------------------------------

class textcolor: # Color text handler for terminal interfaces.
    """ Class with lots of static methods to help with writing to terminals with position and formatting. 
        This is primarily designed to work under puTTY remote terminal connections.
        Behaviour is different under a command line window opened from the desktop.
        
        You don't need to create an instance, it's OK to use textcolor.method() calls directly in your
        code.
                from textcolor import textcolor
                textcolor.clearscreen() 
                print(textcolor.red('Hello'))
                
        It includes various constants such as names of colors.
        It also makes some unicode symbols available via a dictionary so you can refer to them by name.

        Usage :-

            from textcolor import textcolor
            print(textcolor.yellow("Hello") 
                     Would print "Hello" in yellow text on default background. 
                     
            """

    __version__ = '0.0.8'
    TermType = None
    Mode = 'putty' # 'putty' = full color remote terminal, 'simple' = No color, 'local' = Direct connection color.
    # Some standard color names (XTERM names & a couple of common aliases).
    BLACK = 0
    MAROON = 1
    GREEN = 2
    OLIVE = 3
    NAVY = 4
    PURPLE = 5
    TEAL = 6
    SILVER = 7
    GRAY = GREY = 8
    RED = 9
    LIME = 10
    YELLOW = 11
    BLUE = 12
    FUCHSIA = MAGENTA = 13
    AQUA = CYAN = 14
    WHITE = 15
    GREY0 = 16
    NAVYBLUE = 17
    DARKBLUE = 18
    BLUE3 = 19
    BLUE3A = 20
    BLUE1 = 21
    DARKGREEN = 22
    DEEPSKYBLUE4 = 23
    DEEPSKYBLUE4A = 24
    DEEPSKYBLUE4B = 25
    DODGERBLUE3 = 26
    DODGERBLUE2 = 27
    GREEN4 = 28
    SPRINGGREEN4 = 29
    TURQUOISE4 = 30
    DEEPSKYBLUE3 = 31
    DEEPSKYBLUE3A = 32
    DODGERBLUE1 = 33
    GREEN3 = 34
    SPRINGGREEN3 = 35
    DARKCYAN = 36
    LIGHTSEAGREEN = 37
    DEEPSKYBLUE2 = 38
    DEEPSKYBLUE1 = 39
    GREEN3A = 40
    SPRINGGREEN3A = 41
    SPRINGGREEN2 = 42
    CYAN3 = 43
    DARKTURQUOISE = 44
    TURQUOISE2 = 45
    GREEN1 = 46
    SPRINGGREEN2A = 47
    SPRINGGREEN1 = 48
    MEDIUMSPRINGGREEN = 49
    CYAN2 = 50
    CYAN1 = 51
    DARKREDA = 52
    DEEPPINK4 = 53
    PURPLE4 = 54
    PURPLE4A = 55
    PURPLE3 = 56
    BLUEVIOLET = 57
    ORANGE4 = ORANGE = 58
    GREY37 = 59
    MEDIUMPURPLE4 = 60
    SLATEBLUE3 = 61
    SLATEBLUE3A = 62
    ROYALBLUE1 = 63
    CHARTREUSE4 = 64
    DARKSEAGREEN4 = 65
    PALETURQUOISE4 = 66
    STEELBLUE = 67
    STEELBLUE3 = 68
    CORNFLOWERBLUE = 69
    CHARTREUSE3 = 70
    DARKSEAGREEN4A = 71
    CADETBLUE = 72
    CADETBLUEA = 73
    SKYBLUE3 = 74
    STEELBLUE1 = 75
    CHARTREUSE3A = 76
    PALEGREEN3 = 77
    SEAGREEN3 = 78
    AQUAMARINE3 = 79
    MEDIUMTURQUOISE = 80
    STEELBLUE1A = 81
    CHARTREUSE2 = 82
    SEAGREEN2 = 83
    SEAGREEN1 = 84
    SEAGREEN1A = 85
    AQUAMARINE1 = 86
    DARKSLATEGRAY2 = 87
    DARKRED = 88
    DEEPPINK4A = 89
    DARKMAGENTA = 90
    DARKMAGENTAA = 91
    DARKVIOLET = 92
    PURPLE2 = 93
    ORANGE4 = 94
    LIGHTPINK4 = 95
    PLUM4 = 96
    MEDIUMPURPLE3 = 97
    MEDIUMPURPLE3A = 98
    SLATEBLUE1 = 99
    YELLOW4 = 100
    WHEAT4 = 101
    GREY53 = 102
    LIGHTSLATEGREY = 103
    MEDIUMPURPLE = 104
    LIGHTSLATEBLUE = 105
    YELLOW4A = 106
    DARKOLIVEGREEN3 = 107
    DARKSEAGREEN = 108
    LIGHTSKYBLUE3 = 109
    LIGHTSKYBLUE3A = 110
    SKYBLUE2 = 111
    CHARTREUSE2A = 112
    DARKOLIVEGREEN3A = 113
    PALEGREEN3A = 114
    DARKSEAGREEN3 = 115
    DARKSLATEGRAY3 = 116
    SKYBLUE1 = 117
    CHARTREUSE1 = 118
    LIGHTGREEN = 119
    LIGHTGREENA = 120
    PALEGREEN1 = 121
    AQUAMARINE1A = 122
    DARKSLATEGRAY1 = 123
    RED3 = 124
    DEEPPINK4B = 125
    MEDIUMVIOLETRED = 126
    MAGENTA3 = 127
    DARKVIOLETA = 128
    PURPLE5 = 129
    DARKORANGE3 = 130
    INDIANRED = 131
    HOTPINK3 = 132
    MEDIUMORCHID3 = 133
    MEDIUMORCHID = 134
    MEDIUMPURPLE2 = 135
    DARKGOLDENROD = 136
    LIGHTSALMON3 = 137
    ROSYBROWN = 138
    GREY63 = 139
    MEDIUMPURPLE2A = 140
    MEDIUMPURPLE1 = 141
    GOLD3 = 142
    DARKKHAKI = 143
    NAVAJOWHITE3 = 144
    GREY69 = 145
    LIGHTSTEELBLUE3 = 146
    LIGHTSTEELBLUE = 147
    YELLOW3 = 148
    DARKOLIVEGREEN3B = 149
    DARKSEAGREEN3A = 150
    DARKSEAGREEN2 = 151
    LIGHTCYAN3 = 152
    LIGHTSKYBLUE1 = 153
    GREENYELLOW = 154
    DARKOLIVEGREEN2 = 155
    PALEGREEN1A = 156
    DARKSEAGREEN2A = 157
    DARKSEAGREEN1 = 158
    PALETURQUOISE1 = 159
    RED3A = 160
    DEEPPINK3 = 161
    DEEPPINK3A = 162
    MAGENTA3B = 163
    MAGENTA3A = 164
    MAGENTA2 = 165
    DARKORANGE3A = 166
    INDIANREDB = 167
    HOTPINK3A = 168
    HOTPINK2 = 169
    ORCHID = 170
    MEDIUMORCHID1 = 171
    ORANGE3 = 172
    LIGHTSALMON3A = 173
    LIGHTPINK3 = 174
    PINK3 = 175
    PLUM3 = 176
    VIOLET = 177
    GOLD3A = 178
    LIGHTGOLDENROD3 = 179
    TAN = 180
    MISTYROSE3 = 181
    THISTLE3 = 182
    PLUM2 = 183
    YELLOW3A = 184
    KHAKI3 = 185
    LIGHTGOLDENROD2 = 186
    LIGHTYELLOW3 = 187
    GREY84 = 188
    LIGHTSTEELBLUE1 = 189
    YELLOW2 = 190
    DARKOLIVEGREEN1 = 191
    DARKOLIVEGREEN1A = 192
    DARKSEAGREEN1A = 193
    HONEYDEW2 = 194
    LIGHTCYAN1 = 195
    RED1 = 196
    DEEPPINK2 = 197
    DEEPPINK1 = 198
    DEEPPINK1A = 199
    MAGENTA2A = 200
    MAGENTA1 = 201
    ORANGERED1 = 202
    INDIANRED1 = 203
    INDIANRED1A = 204
    HOTPINK = 205
    HOTPINKA = 206
    MEDIUMORCHID1A = 207
    DARKORANGE = 208
    SALMON1 = 209
    LIGHTCORAL = 210
    PALEVIOLETRED1 = 211
    ORCHID2 = 212
    ORCHID1 = 213
    ORANGE1 = 214
    SANDYBROWN = 215
    LIGHTSALMON1 = 216
    LIGHTPINK1 = 217
    PINK1 = 218
    PLUM1 = 219
    GOLD1 = 220
    LIGHTGOLDENROD2B = 221
    LIGHTGOLDENROD2A = 222
    NAVAJOWHITE1 = 223
    MISTYROSE1 = 224
    THISTLE1 = 225
    YELLOW1 = 226
    LIGHTGOLDENROD1 = 227
    KHAKI1 = 228
    WHEAT1 = 229
    CORNSILK1 = 230
    GREY100 = 231
    GREY3 = 232
    GREY7 = 233
    GREY11 = 234
    GREY15 = 235
    GREY19 = 236
    GREY23 = 237
    GREY27 = 238
    GREY30 = 239
    GREY35 = 240
    GREY39 = 241
    GREY42 = 242
    GREY46 = 243
    GREY50 = 244
    GREY54 = 245
    GREY58 = 246
    GREY62 = 247
    GREY66 = 248
    GREY70 = 249
    GREY74 = 250
    GREY78 = 251
    GREY82 = 252
    GREY85 = 253
    GREY89 = 254
    GREY93 = 255
    
    XTERM_COLOR_NAMES = {
        'BLACK':0,
        'MAROON':1,
        'GREEN':2,
        'OLIVE':3,
        'NAVY':4,
        'PURPLE':5,
        'TEAL':6,
        'SILVER':7,
        'GREY':8,
        'GRAY':8,
        'RED':9,
        'LIME':10,
        'YELLOW':11,
        'BLUE':12,
        'FUCHSIA':13,
        'MAGENTA':13,
        'AQUA':14,
        'CYAN':14,
        'WHITE':15,
        'GREY0':16,
        'NAVYBLUE':17,
        'DARKBLUE':18,
        'BLUE3':19,
        'BLUE3A':20,
        'BLUE1':21,
        'DARKGREEN':22,
        'DEEPSKYBLUE4':23,
        'DEEPSKYBLUE4A':24,
        'DEEPSKYBLUE4B':25,
        'DODGERBLUE3':26,
        'DODGERBLUE2':27,
        'GREEN4':28,
        'SPRINGGREEN4':29,
        'TURQUOISE4':30,
        'DEEPSKYBLUE3':31,
        'DEEPSKYBLUE3A':32,
        'DODGERBLUE1':33,
        'GREEN3':34,
        'SPRINGGREEN3':35,
        'DARKCYAN':36,
        'LIGHTSEAGREEN':37,
        'DEEPSKYBLUE2':38,
        'DEEPSKYBLUE1':39,
        'GREEN3A':40,
        'SPRINGGREEN3A':41,
        'SPRINGGREEN2':42,
        'CYAN3':43,
        'DARKTURQUOISE':44,
        'TURQUOISE2':45,
        'GREEN1':46,
        'SPRINGGREEN2A':47,
        'SPRINGGREEN1':48,
        'MEDIUMSPRINGGREEN':49,
        'CYAN2':50,
        'CYAN1':51,
        'DARKREDA':52,
        'DEEPPINK4':53,
        'PURPLE4':54,
        'PURPLE4A':55,
        'PURPLE3':56,
        'BLUEVIOLET':57,
        'ORANGE':58,
        'ORANGE4':58,
        'GREY37':59,
        'MEDIUMPURPLE4':60,
        'SLATEBLUE3':61,
        'SLATEBLUE3A':62,
        'ROYALBLUE1':63,
        'CHARTREUSE4':64,
        'DARKSEAGREEN4':65,
        'PALETURQUOISE4':66,
        'STEELBLUE':67,
        'STEELBLUE3':68,
        'CORNFLOWERBLUE':69,
        'CHARTREUSE3':70,
        'DARKSEAGREEN4A':71,
        'CADETBLUE':72,
        'CADETBLUEA':73,
        'SKYBLUE3':74,
        'STEELBLUE1':75,
        'CHARTREUSE3A':76,
        'PALEGREEN3':77,
        'SEAGREEN3':78,
        'AQUAMARINE3':79,
        'MEDIUMTURQUOISE':80,
        'STEELBLUE1A':81,
        'CHARTREUSE2':82,
        'SEAGREEN2':83,
        'SEAGREEN1':84,
        'SEAGREEN1A':85,
        'AQUAMARINE1':86,
        'DARKSLATEGRAY2':87,
        'DARKRED':88,
        'DEEPPINK4A':89,
        'DARKMAGENTA':90,
        'DARKMAGENTAA':91,
        'DARKVIOLET':92,
        'PURPLE2':93,
        'ORANGE4':94,
        'LIGHTPINK4':95,
        'PLUM4':96,
        'MEDIUMPURPLE3':97,
        'MEDIUMPURPLE3A':98,
        'SLATEBLUE1':99,
        'YELLOW4':100,
        'WHEAT4':101,
        'GREY53':102,
        'LIGHTSLATEGREY':103,
        'MEDIUMPURPLE':104,
        'LIGHTSLATEBLUE':105,
        'YELLOW4A':106,
        'DARKOLIVEGREEN3':107,
        'DARKSEAGREEN':108,
        'LIGHTSKYBLUE3':109,
        'LIGHTSKYBLUE3A':110,
        'SKYBLUE2':111,
        'CHARTREUSE2A':112,
        'DARKOLIVEGREEN3A':113,
        'PALEGREEN3A':114,
        'DARKSEAGREEN3':115,
        'DARKSLATEGRAY3':116,
        'SKYBLUE1':117,
        'CHARTREUSE1':118,
        'LIGHTGREEN':119,
        'LIGHTGREENA':120,
        'PALEGREEN1':121,
        'AQUAMARINE1A':122,
        'DARKSLATEGRAY1':123,
        'RED3':124,
        'DEEPPINK4B':125,
        'MEDIUMVIOLETRED':126,
        'MAGENTA3':127,
        'DARKVIOLETA':128,
        'PURPLE5':129,
        'DARKORANGE3':130,
        'INDIANRED':131,
        'HOTPINK3':132,
        'MEDIUMORCHID3':133,
        'MEDIUMORCHID':134,
        'MEDIUMPURPLE2':135,
        'DARKGOLDENROD':136,
        'LIGHTSALMON3':137,
        'ROSYBROWN':138,
        'GREY63':139,
        'MEDIUMPURPLE2A':140,
        'MEDIUMPURPLE1':141,
        'GOLD3':142,
        'DARKKHAKI':143,
        'NAVAJOWHITE3':144,
        'GREY69':145,
        'LIGHTSTEELBLUE3':146,
        'LIGHTSTEELBLUE':147,
        'YELLOW3':148,
        'DARKOLIVEGREEN3B':149,
        'DARKSEAGREEN3A':150,
        'DARKSEAGREEN2':151,
        'LIGHTCYAN3':152,
        'LIGHTSKYBLUE1':153,
        'GREENYELLOW':154,
        'DARKOLIVEGREEN2':155,
        'PALEGREEN1A':156,
        'DARKSEAGREEN2A':157,
        'DARKSEAGREEN1':158,
        'PALETURQUOISE1':159,
        'RED3A':160,
        'DEEPPINK3':161,
        'DEEPPINK3A':162,
        'MAGENTA3B':163,
        'MAGENTA3A':164,
        'MAGENTA2':165,
        'DARKORANGE3A':166,
        'INDIANREDB':167,
        'HOTPINK3A':168,
        'HOTPINK2':169,
        'ORCHID':170,
        'MEDIUMORCHID1':171,
        'ORANGE3':172,
        'LIGHTSALMON3A':173,
        'LIGHTPINK3':174,
        'PINK3':175,
        'PLUM3':176,
        'VIOLET':177,
        'GOLD3A':178,
        'LIGHTGOLDENROD3':179,
        'TAN':180,
        'MISTYROSE3':181,
        'THISTLE3':182,
        'PLUM2':183,
        'YELLOW3A':184,
        'KHAKI3':185,
        'LIGHTGOLDENROD2':186,
        'LIGHTYELLOW3':187,
        'GREY84':188,
        'LIGHTSTEELBLUE1':189,
        'YELLOW2':190,
        'DARKOLIVEGREEN1':191,
        'DARKOLIVEGREEN1A':192,
        'DARKSEAGREEN1A':193,
        'HONEYDEW2':194,
        'LIGHTCYAN1':195,
        'RED1':196,
        'DEEPPINK2':197,
        'DEEPPINK1':198,
        'DEEPPINK1A':199,
        'MAGENTA2A':200,
        'MAGENTA1':201,
        'ORANGERED1':202,
        'INDIANRED1':203,
        'INDIANRED1A':204,
        'HOTPINK':205,
        'HOTPINKA':206,
        'MEDIUMORCHID1A':207,
        'DARKORANGE':208,
        'SALMON1':209,
        'LIGHTCORAL':210,
        'PALEVIOLETRED1':211,
        'ORCHID2':212,
        'ORCHID1':213,
        'ORANGE1':214,
        'SANDYBROWN':215,
        'LIGHTSALMON1':216,
        'LIGHTPINK1':217,
        'PINK1':218,
        'PLUM1':219,
        'GOLD1':220,
        'LIGHTGOLDENROD2B':221,
        'LIGHTGOLDENROD2A':222,
        'NAVAJOWHITE1':223,
        'MISTYROSE1':224,
        'THISTLE1':225,
        'YELLOW1':226,
        'LIGHTGOLDENROD1':227,
        'KHAKI1':228,
        'WHEAT1':229,
        'CORNSILK1':230,
        'GREY100':231,
        'GREY3':232,
        'GREY7':233,
        'GREY11':234,
        'GREY15':235,
        'GREY19':236,
        'GREY23':237,
        'GREY27':238,
        'GREY30':239,
        'GREY35':240,
        'GREY39':241,
        'GREY42':242,
        'GREY46':243,
        'GREY50':244,
        'GREY54':245,
        'GREY58':246,
        'GREY62':247,
        'GREY66':248,
        'GREY70':249,
        'GREY74':250,
        'GREY78':251,
        'GREY82':252,
        'GREY85':253,
        'GREY89':254,
        'GREY93':255
    }

    XTERM_COLORS = {
        0: {'names': ['BLACK'], 'rgb': (0, 0, 0), 'hsv': (0, 0, 0.0)},
        1: {'names': ['MAROON'], 'rgb': (128, 0, 0), 'hsv': (0.0, 1.0, 0.5019607843137255)},
        2: {'names': ['GREEN'], 'rgb': (0, 128, 0), 'hsv': (120.0, 1.0, 0.5019607843137255)},
        3: {'names': ['OLIVE'], 'rgb': (128, 128, 0), 'hsv': (60.0, 1.0, 0.5019607843137255)},
        4: {'names': ['NAVY'], 'rgb': (0, 0, 128), 'hsv': (240.0, 1.0, 0.5019607843137255)},
        5: {'names': ['PURPLE'], 'rgb': (128, 0, 128), 'hsv': (300.0, 1.0, 0.5019607843137255)},
        6: {'names': ['TEAL'], 'rgb': (0, 128, 128), 'hsv': (180.0, 1.0, 0.5019607843137255)},
        7: {'names': ['SILVER'], 'rgb': (192, 192, 192), 'hsv': (0, 0.0, 0.7529411764705882)},
        8: {'names': ['GREY', 'GRAY'], 'rgb': (128, 128, 128), 'hsv': (0, 0.0, 0.5019607843137255)},
        9: {'names': ['RED'], 'rgb': (255, 0, 0), 'hsv': (0.0, 1.0, 1.0)},
        10: {'names': ['LIME'], 'rgb': (0, 255, 0), 'hsv': (120.0, 1.0, 1.0)},
        11: {'names': ['YELLOW'], 'rgb': (255, 255, 0), 'hsv': (60.0, 1.0, 1.0)},
        12: {'names': ['BLUE'], 'rgb': (0, 0, 255), 'hsv': (240.0, 1.0, 1.0)},
        13: {'names': ['FUCHSIA', 'MAGENTA'], 'rgb': (255, 0, 255), 'hsv': (300.0, 1.0, 1.0)},
        14: {'names': ['AQUA', 'CYAN'], 'rgb': (0, 255, 255), 'hsv': (180.0, 1.0, 1.0)},
        15: {'names': ['WHITE'], 'rgb': (255, 255, 255), 'hsv': (0, 0.0, 1.0)},
        16: {'names': ['GREY0'], 'rgb': (0, 0, 0), 'hsv': (0, 0, 0.0)},
        17: {'names': ['NAVYBLUE'], 'rgb': (0, 0, 95), 'hsv': (240.0, 1.0, 0.37254901960784315)},
        18: {'names': ['DARKBLUE'], 'rgb': (0, 0, 135), 'hsv': (240.0, 1.0, 0.5294117647058824)},
        19: {'names': ['BLUE3'], 'rgb': (0, 0, 175), 'hsv': (240.0, 1.0, 0.6862745098039216)},
        20: {'names': ['BLUE3A'], 'rgb': (0, 0, 215), 'hsv': (240.0, 1.0, 0.8431372549019608)},
        21: {'names': ['BLUE1'], 'rgb': (0, 0, 255), 'hsv': (240.0, 1.0, 1.0)},
        22: {'names': ['DARKGREEN'], 'rgb': (0, 95, 0), 'hsv': (120.0, 1.0, 0.37254901960784315)},
        23: {'names': ['DEEPSKYBLUE4'], 'rgb': (0, 95, 95), 'hsv': (180.0, 1.0, 0.37254901960784315)},
        24: {'names': ['DEEPSKYBLUE4A'], 'rgb': (0, 95, 135), 'hsv': (197.77777777777777, 1.0, 0.5294117647058824)},
        25: {'names': ['DEEPSKYBLUE4B'], 'rgb': (0, 95, 175), 'hsv': (207.42857142857144, 1.0, 0.6862745098039216)},
        26: {'names': ['DODGERBLUE3'], 'rgb': (0, 95, 215), 'hsv': (213.48837209302326, 1.0, 0.8431372549019608)},
        27: {'names': ['DODGERBLUE2'], 'rgb': (0, 95, 255), 'hsv': (217.64705882352942, 1.0, 1.0)},
        28: {'names': ['GREEN4'], 'rgb': (0, 135, 0), 'hsv': (120.0, 1.0, 0.5294117647058824)},
        29: {'names': ['SPRINGGREEN4'], 'rgb': (0, 135, 95), 'hsv': (162.22222222222223, 1.0, 0.5294117647058824)},
        30: {'names': ['TURQUOISE4'], 'rgb': (0, 135, 135), 'hsv': (180.0, 1.0, 0.5294117647058824)},
        31: {'names': ['DEEPSKYBLUE3'], 'rgb': (0, 135, 175), 'hsv': (193.71428571428572, 1.0, 0.6862745098039216)},
        32: {'names': ['DEEPSKYBLUE3A'], 'rgb': (0, 135, 215), 'hsv': (202.32558139534882, 1.0, 0.8431372549019608)},
        33: {'names': ['DODGERBLUE1'], 'rgb': (0, 135, 255), 'hsv': (208.23529411764707, 1.0, 1.0)},
        34: {'names': ['GREEN3'], 'rgb': (0, 175, 0), 'hsv': (120.0, 1.0, 0.6862745098039216)},
        35: {'names': ['SPRINGGREEN3'], 'rgb': (0, 175, 95), 'hsv': (152.57142857142856, 1.0, 0.6862745098039216)},
        36: {'names': ['DARKCYAN'], 'rgb': (0, 175, 135), 'hsv': (166.28571428571428, 1.0, 0.6862745098039216)},
        37: {'names': ['LIGHTSEAGREEN'], 'rgb': (0, 175, 175), 'hsv': (180.0, 1.0, 0.6862745098039216)},
        38: {'names': ['DEEPSKYBLUE2'], 'rgb': (0, 175, 215), 'hsv': (191.1627906976744, 1.0, 0.8431372549019608)},
        39: {'names': ['DEEPSKYBLUE1'], 'rgb': (0, 175, 255), 'hsv': (198.8235294117647, 1.0, 1.0)},
        40: {'names': ['GREEN3A'], 'rgb': (0, 215, 0), 'hsv': (120.0, 1.0, 0.8431372549019608)},
        41: {'names': ['SPRINGGREEN3A'], 'rgb': (0, 215, 95), 'hsv': (146.51162790697674, 1.0, 0.8431372549019608)},
        42: {'names': ['SPRINGGREEN2'], 'rgb': (0, 215, 135), 'hsv': (157.67441860465118, 1.0, 0.8431372549019608)},
        43: {'names': ['CYAN3'], 'rgb': (0, 215, 175), 'hsv': (168.8372093023256, 1.0, 0.8431372549019608)},
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
        187: {'names': ['LIGHTYELLOW3'], 'rgb': (215, 215, 175), 'hsv': (60.0, 0.18604651162790697, 0.8431372549019608)},
        188: {'names': ['GREY84'], 'rgb': (215, 215, 215), 'hsv': (0, 0.0, 0.8431372549019608)},
        189: {'names': ['LIGHTSTEELBLUE1'], 'rgb': (215, 215, 255), 'hsv': (240.0, 0.1568627450980392, 1.0)},
        190: {'names': ['YELLOW2'], 'rgb': (215, 255, 0), 'hsv': (69.41176470588235, 1.0, 1.0)},
        191: {'names': ['DARKOLIVEGREEN1'], 'rgb': (215, 255, 95), 'hsv': (75.0, 0.6274509803921569, 1.0)},
        192: {'names': ['DARKOLIVEGREEN1A'], 'rgb': (215, 255, 135), 'hsv': (80.00000000000001, 0.47058823529411764, 1.0)},
        193: {'names': ['DARKSEAGREEN1A'], 'rgb': (215, 255, 175), 'hsv': (90.0, 0.3137254901960784, 1.0)},
        194: {'names': ['HONEYDEW2'], 'rgb': (215, 255, 215), 'hsv': (120.0, 0.1568627450980392, 1.0)},
        195: {'names': ['LIGHTCYAN1'], 'rgb': (215, 255, 255), 'hsv': (180.0, 0.1568627450980392, 1.0)},
        196: {'names': ['RED1'], 'rgb': (255, 0, 0), 'hsv': (0.0, 1.0, 1.0)},
        197: {'names': ['DEEPPINK2'], 'rgb': (255, 0, 95), 'hsv': (337.6470588235294, 1.0, 1.0)},
        198: {'names': ['DEEPPINK1'], 'rgb': (255, 0, 135), 'hsv': (328.2352941176471, 1.0, 1.0)},
        199: {'names': ['DEEPPINK1A'], 'rgb': (255, 0, 175), 'hsv': (318.8235294117647, 1.0, 1.0)},
        200: {'names': ['MAGENTA2A'], 'rgb': (255, 0, 215), 'hsv': (309.4117647058824, 1.0, 1.0)},
        201: {'names': ['MAGENTA1'], 'rgb': (255, 0, 255), 'hsv': (300.0, 1.0, 1.0)},
        202: {'names': ['ORANGERED1'], 'rgb': (255, 95, 0), 'hsv': (22.35294117647061, 1.0, 1.0)},
        203: {'names': ['INDIANRED1'], 'rgb': (255, 95, 95), 'hsv': (0.0, 0.6274509803921569, 1.0)},
        204: {'names': ['INDIANRED1A'], 'rgb': (255, 95, 135), 'hsv': (345.0, 0.6274509803921569, 1.0)},
        205: {'names': ['HOTPINK'], 'rgb': (255, 95, 175), 'hsv': (330.0, 0.6274509803921569, 1.0)},
        206: {'names': ['HOTPINKA'], 'rgb': (255, 95, 215), 'hsv': (315.0, 0.6274509803921569, 1.0)},
        207: {'names': ['MEDIUMORCHID1A'], 'rgb': (255, 95, 255), 'hsv': (300.0, 0.6274509803921569, 1.0)},
        208: {'names': ['DARKORANGE'], 'rgb': (255, 135, 0), 'hsv': (31.764705882352928, 1.0, 1.0)},
        209: {'names': ['SALMON1'], 'rgb': (255, 135, 95), 'hsv': (15.0, 0.6274509803921569, 1.0)},
        210: {'names': ['LIGHTCORAL'], 'rgb': (255, 135, 135), 'hsv': (0.0, 0.47058823529411764, 1.0)},
        211: {'names': ['PALEVIOLETRED1'], 'rgb': (255, 135, 175), 'hsv': (340.0, 0.47058823529411764, 1.0)},
        212: {'names': ['ORCHID2'], 'rgb': (255, 135, 215), 'hsv': (320.0, 0.47058823529411764, 1.0)},
        213: {'names': ['ORCHID1'], 'rgb': (255, 135, 255), 'hsv': (300.0, 0.47058823529411764, 1.0)},
        214: {'names': ['ORANGE1'], 'rgb': (255, 175, 0), 'hsv': (41.176470588235304, 1.0, 1.0)},
        215: {'names': ['SANDYBROWN'], 'rgb': (255, 175, 95), 'hsv': (30.0, 0.6274509803921569, 1.0)},
        216: {'names': ['LIGHTSALMON1'], 'rgb': (255, 175, 135), 'hsv': (20.0, 0.47058823529411764, 1.0)},
        217: {'names': ['LIGHTPINK1'], 'rgb': (255, 175, 175), 'hsv': (0.0, 0.3137254901960784, 1.0)},
        218: {'names': ['PINK1'], 'rgb': (255, 175, 215), 'hsv': (330.0, 0.3137254901960784, 1.0)},
        219: {'names': ['PLUM1'], 'rgb': (255, 175, 255), 'hsv': (300.0, 0.3137254901960784, 1.0)},
        220: {'names': ['GOLD1'], 'rgb': (255, 215, 0), 'hsv': (50.588235294117624, 1.0, 1.0)},
        221: {'names': ['LIGHTGOLDENROD2B'], 'rgb': (255, 215, 95), 'hsv': (45.0, 0.6274509803921569, 1.0)},
        222: {'names': ['LIGHTGOLDENROD2A'], 'rgb': (255, 215, 135), 'hsv': (40.0, 0.47058823529411764, 1.0)},
        223: {'names': ['NAVAJOWHITE1'], 'rgb': (255, 215, 175), 'hsv': (30.0, 0.3137254901960784, 1.0)},
        224: {'names': ['MISTYROSE1'], 'rgb': (255, 215, 215), 'hsv': (0.0, 0.1568627450980392, 1.0)},
        225: {'names': ['THISTLE1'], 'rgb': (255, 215, 255), 'hsv': (300.0, 0.1568627450980392, 1.0)},
        226: {'names': ['YELLOW1'], 'rgb': (255, 255, 0), 'hsv': (60.0, 1.0, 1.0)},
        227: {'names': ['LIGHTGOLDENROD1'], 'rgb': (255, 255, 95), 'hsv': (60.0, 0.6274509803921569, 1.0)},
        228: {'names': ['KHAKI1'], 'rgb': (255, 255, 135), 'hsv': (60.0, 0.47058823529411764, 1.0)},
        229: {'names': ['WHEAT1'], 'rgb': (255, 255, 175), 'hsv': (60.0, 0.3137254901960784, 1.0)},
        230: {'names': ['CORNSILK1'], 'rgb': (255, 255, 215), 'hsv': (60.0, 0.1568627450980392, 1.0)},
        231: {'names': ['GREY100'], 'rgb': (255, 255, 255), 'hsv': (0, 0.0, 1.0)},
        232: {'names': ['GREY3'], 'rgb': (8, 8, 8), 'hsv': (0, 0.0, 0.03137254901960784)},
        233: {'names': ['GREY7'], 'rgb': (18, 18, 18), 'hsv': (0, 0.0, 0.07058823529411765)},
        234: {'names': ['GREY11'], 'rgb': (28, 28, 28), 'hsv': (0, 0.0, 0.10980392156862745)},
        235: {'names': ['GREY15'], 'rgb': (38, 38, 38), 'hsv': (0, 0.0, 0.14901960784313725)},
        236: {'names': ['GREY19'], 'rgb': (48, 48, 48), 'hsv': (0, 0.0, 0.18823529411764706)},
        237: {'names': ['GREY23'], 'rgb': (58, 58, 58), 'hsv': (0, 0.0, 0.22745098039215686)},
        238: {'names': ['GREY27'], 'rgb': (68, 68, 68), 'hsv': (0, 0.0, 0.26666666666666666)},
        239: {'names': ['GREY30'], 'rgb': (78, 78, 78), 'hsv': (0, 0.0, 0.3058823529411765)},
        240: {'names': ['GREY35'], 'rgb': (88, 88, 88), 'hsv': (0, 0.0, 0.34509803921568627)},
        241: {'names': ['GREY39'], 'rgb': (98, 98, 98), 'hsv': (0, 0.0, 0.3843137254901961)},
        242: {'names': ['GREY42'], 'rgb': (108, 108, 108), 'hsv': (0, 0.0, 0.4235294117647059)},
        243: {'names': ['GREY46'], 'rgb': (118, 118, 118), 'hsv': (0, 0.0, 0.4627450980392157)},
        244: {'names': ['GREY50'], 'rgb': (128, 128, 128), 'hsv': (0, 0.0, 0.5019607843137255)},
        245: {'names': ['GREY54'], 'rgb': (138, 138, 138), 'hsv': (0, 0.0, 0.5411764705882353)},
        246: {'names': ['GREY58'], 'rgb': (148, 148, 148), 'hsv': (0, 0.0, 0.5803921568627451)},
        247: {'names': ['GREY62'], 'rgb': (158, 158, 158), 'hsv': (0, 0.0, 0.6196078431372549)},
        248: {'names': ['GREY66'], 'rgb': (168, 168, 168), 'hsv': (0, 0.0, 0.6588235294117647)},
        249: {'names': ['GREY70'], 'rgb': (178, 178, 178), 'hsv': (0, 0.0, 0.6980392156862745)},
        250: {'names': ['GREY74'], 'rgb': (188, 188, 188), 'hsv': (0, 0.0, 0.7372549019607844)},
        251: {'names': ['GREY78'], 'rgb': (198, 198, 198), 'hsv': (0, 0.0, 0.7764705882352941)},
        252: {'names': ['GREY82'], 'rgb': (208, 208, 208), 'hsv': (0, 0.0, 0.8156862745098039)},
        253: {'names': ['GREY85'], 'rgb': (218, 218, 218), 'hsv': (0, 0.0, 0.8549019607843137)},
        254: {'names': ['GREY89'], 'rgb': (228, 228, 228), 'hsv': (0, 0.0, 0.8941176470588236)},
        255: {'names': ['GREY93'], 'rgb': (238, 238, 238), 'hsv': (0, 0.0, 0.9333333333333333)}
        }
    
    @staticmethod
    def listshades(levels=6):
        """
        List all xterm colors and suggest some associated shades. To help with chosing color schemes.
        """
        print(textcolor.yellow("List of shades for each xterm color:"))
        for xterm_num, values in textcolor.XTERM_COLORS.items():
            line = ""
            line += (values['names'][0]).rjust(17," ") + " = "
            line += textcolor.bgcolor(xterm_num,(" " * 4 + str(xterm_num))[-4:]) + " : "
            h,s,v = values['hsv']
            for i in range(levels):
                j = (i + 2) / (levels + 1)
                rgb = textcolor.HSV2RGB((h,s,j))
                idx = textcolor.rgb_to_xterm(rgb)
                line += textcolor.bgcolor(idx,(" " * 4 + str(idx))[-4:]) + " "
            print(line)                

    @staticmethod
    def getshades(xterm_num,levels=6):
        """
        Given an xterm color number, return a list of 'shades' of that color.
        """
        values = textcolor.XTERM_COLORS[xterm_num]
        h,s,v = values['hsv']
        result = []
        for i in range(levels):
            j = (i + 2) / (levels + 1)
            rgb = textcolor.HSV2RGB((h,s,j))
            idx = textcolor.rgb_to_xterm(rgb)
            result.append(idx)
        return result
                
    @staticmethod
    def RGB2HSV(rgb):
        """
        Receive (r,g,b) tuple, return (h,s,v) tuple.
        """
        # Normalize RGB values to [0, 1]
        r_, g_, b_ = rgb[0] / 255.0, rgb[1] / 255.0, rgb[2] / 255.0

        cmax = max(r_, g_, b_)
        cmin = min(r_, g_, b_)
        delta = cmax - cmin

        # Hue calculation
        if delta == 0:
            h = 0
        elif cmax == r_:
            h = (60 * ((g_ - b_) / delta) + 360) % 360
        elif cmax == g_:
            h = 60 * ((b_ - r_) / delta + 2)
        else:  # cmax == b_
            h = 60 * ((r_ - g_) / delta + 4)

        # Saturation calculation
        s = 0 if cmax == 0 else (delta / cmax)

        # Value calculation
        v = cmax

        return (h, s, v)

    @staticmethod
    def HSV2RGB(hsv):
        """
        Receive (h,s,v) tuple, return (r,g,b) tuple.
        """
        h,s,v = hsv
        c = v * s
        x = c * (1 - abs((h / 60) % 2 - 1))
        m = v - c

        if 0 <= h < 60:
            r_, g_, b_ = c, x, 0
        elif 60 <= h < 120:
            r_, g_, b_ = x, c, 0
        elif 120 <= h < 180:
            r_, g_, b_ = 0, c, x
        elif 180 <= h < 240:
            r_, g_, b_ = 0, x, c
        elif 240 <= h < 300:
            r_, g_, b_ = x, 0, c
        else:  # 300 <= h < 360
            r_, g_, b_ = c, 0, x

        r = int(round((r_ + m) * 255))
        g = int(round((g_ + m) * 255))
        b = int(round((b_ + m) * 255))

        return (r, g, b)

    @staticmethod
    def _populate_XTERM_COLORS():
        """
        Used only in development to populate the XTERM_COLORS dictionary with initial values.
        """
        for key,value in textcolor.XTERM_COLOR_NAMES.items():
            entry = textcolor.XTERM_COLORS.get(value,{})
            names = entry.get('names',[])
            if not key in names: names.append(key) # Don't duplicate.
            entry['names'] = names
            r,g,b = textcolor.xterm_to_rgb(value)
            entry['rgb'] = (r,g,b)
            hsv = textcolor.RGB2HSV(entry['rgb'])
            entry['hsv'] = hsv
            textcolor.XTERM_COLORS[value] = entry
        with open('xtermdict.json','w') as f:
            f.write(str(textcolor.XTERM_COLORS))
        for key,value in textcolor.XTERM_COLORS.items():
            if value['names'] == []: print("Failed for",key,value,"duplicates?")
            
    # UTF-8 symbols for special items.
    SYMBOLS = {'left' : '\u2190', 'right' : '\u2192', 'up' : '\u2191', 'down' : '\u2193', 
               'degree' : '\u00B0', 'delta' : '\u0394', 
               'horizontal' : '\u2500', 'vertical' : '\u2502', 'corner_tl' : '\u250c', 'corner_tr' : '\u2510', 'corner_bl' : '\u2514', 'corner_br' : '\u2518', 'crossover' : '\u253c',
               'left_junction' : '\u2524', 'right_junction' : '\u251c', 'top_junction' : '\u2534', 'bottom_junction' : '\u252c',
               'solid' : '\u2588', '0.75' : '\u2593', '0.50' : '\u2592', '0.25' : 'u\2591',
               'sun' : '\u2609', 'moon' : '\u263D', 'mercury' : '\u263F', 'venus' : '\u2640', 'earth' : '\u2641', 'mars' : '\u2642', 'jupiter' : '\u2643', 'saturn' : '\u2644', 'uranus' : '\u2645', 'neptune' : '\u2646', 'pluto' : '\u2647', 'comet' : '\u2604', 'star' : '\u2736'
              }
    # Alternative 7bit character symbols for special items. (If environment doesn't support UTF-8)
    SYMBOLS8 = {'left' : '<', 'right' : '>', 'up' : '^', 'down' : 'v', 
               'degree' : 'd', 'delta' : '~', 
               'horizontal' : '-', 'vertical' : '|', 'corner_tl' : '+', 'corner_tr' : '+', 'corner_bl' : '+', 'corner_br' : '+', 'crossover' : '+',
               'left_junction' : '+', 'right_junction' : '+', 'top_junction' : '+', 'bottom_junction' : '+',
               'solid' : '@', '0.75' : '#', '0.50' : 'X', '0.25' : ':',
               'sun' : 'S', 'moon' : 'l', 'mercury' : 'm', 'venus' : 'v', 'earth' : 'e', 'mars' : 'M', 'jupiter' : 'J', 'saturn' : 's', 'uranus' : 'u', 'neptune' : 'n', 'pluto' : 'p', 'comet' : '@', 'star' : '*'
              }

    @staticmethod
    def SetCurrentLocale(): # Load the locale into the library.
        """ Load the locale into the textcolor library.
            Python may assume it's in UTF-8 unless we load the current environment's settings.    
            Parameters ---------------------------------------
            n/a

            References ---------------------------------------
            n/a

            Sets ---------------------------------------------
            Parameters.DisplayTZ
            ObservationStatusWindow
            ImageStatusWindow
            SessionWindow

            Returns ------------------------------------------
            n/a           """
        locale.setlocale(locale.LC_ALL, '')
        
    @staticmethod
    def GetLocale(): # Retrieve the current locale setting for the session.
        """ Retrieve the current locale setting for the session.
            Output -------------------------------------------------------------------
            Returns the detected locale (Language, Characterset) tuple.     
            Parameters ---------------------------------------
            n/a

            References ---------------------------------------
            n/a

            Sets ---------------------------------------------
            Parameters.DisplayTZ
            ObservationStatusWindow
            ImageStatusWindow
            SessionWindow

            Returns ------------------------------------------
            n/a          """
        Lang, CharSet = locale.getlocale()
        return (Lang, CharSet)

    @staticmethod
    def CheckLocale(switch=False): # Validate locale capabilities.
        """ If the character set is not UTF-8 then special characters won't print. 
            In that case, convert the SYMBOLS list to safer ISO8859-1 characters.
            Call this at the start of a session before using other textcolor methods.
            Parameters ---------------------------------------------------------------
            switch: False. No changes are made.
            switch: True. The SYMBOLS list is switched to a simpler version that will work with more character sets.
            Output -------------------------------------------------------------------
            Returns the detected locale (Language, Characterset) tuple.    
            Parameters ---------------------------------------
            n/a

            References ---------------------------------------
            n/a

            Sets ---------------------------------------------
            Parameters.DisplayTZ
            ObservationStatusWindow
            ImageStatusWindow
            SessionWindow

            Returns ------------------------------------------
            n/a           """
        Lang, CharSet = textcolor.GetLocale()
        if not CharSet in ["UTF-8"] and switch: # Special characters won't work, but we can switch to an alternative list.
            print("textcolor.CheckLocale(): Downgrading special characters for character set",CharSet)
            textcolor.SYMBOLS = textcolor.SYMBOLS8
        return (Lang, CharSet)

    @staticmethod
    def TextBox(linelist,row=None,col=None,fg=None,bg=None,textfg=None,textbg=None,borderfg=None,borderbg=None,minwidth=None,justify=None): # Create pop-up text box from list of strings.
        """ Receive a single string or list of strings.
            Embedded newline characters will also split the text into separate lines within the bounding box.
            Make all lines the same length, surrounded with a box using line drawing characters.
            Print the resulting text box. 
            - row/col specify the location of the top-left corner of the box.
            Colors are applied if specified. 
            - fg/bg applies to text and border. 
            - textfg/textbg applies to text only. 
            - borderfg/borderbg applies to border only.
            - minwidth = minimum character width.
            - justify = 'l'(left),'c'(center),'r'(right) 
            
            If the O/S character set is not UTF-8 the line drawing can fail. 
            So if the print() statements fail, this routine will just print the lines individually instead.    
            Parameters ---------------------------------------
            n/a

            References ---------------------------------------
            n/a

            Sets ---------------------------------------------
            Parameters.DisplayTZ
            ObservationStatusWindow
            ImageStatusWindow
            SessionWindow

            Returns ------------------------------------------
            n/a           """
        if type(linelist) != list: linelist = [linelist] # Convert single values to list for simpler processing.
        if justify != None: justify = justify[0].lower() # standardise code.
        # Convert embedded newline characters into separate list elements.
        templinelist = []
        for line in linelist: # Read all the input lines.
            if type(line) != str: line = str(line) # Protect from input errors.
            for newline in line.split('\n'): # Break on newline character.
                templinelist.append(newline)
        linelist = templinelist
        if textfg == None: textfg = fg # Use same color scheme for text and border.
        if textbg == None: textbg = bg # Use same color scheme for text and border.
        if borderfg == None: borderfg = fg # Use same color scheme for text and border.
        if borderbg == None: borderbg = bg # Use same color scheme for text and border.
        maxlen = 0
        for line in linelist: maxlen = max(maxlen,len(line)) # What's the longest line?
        if minwidth != None: maxlen = max(maxlen,minwidth) # Respect minwidth.
        #lines = [line.ljust(maxlen) for line in linelist] # Make all lines the same length.
        printlines = [] # List of color constructed lines to print.
        # 1: Construct top of box.
        if borderfg != None and borderbg != None: # Border color is specified.
            temp = textcolor.fgbgcolor(borderfg,borderbg,textcolor.SYMBOLS['corner_tl'] + (textcolor.SYMBOLS['horizontal'] * maxlen) + textcolor.SYMBOLS['corner_tr'])
            printlines.append(temp)
        else: # No colors specified.
            temp = textcolor.SYMBOLS['corner_tl'] + (textcolor.SYMBOLS['horizontal'] * maxlen) + textcolor.SYMBOLS['corner_tr']
            printlines.append(temp)
        # 2: Construct text lines and box edges.
        for line in linelist:
            temp = ''
            # Vertical edge on left. Color if needed.
            if borderfg != None and borderbg != None: # Border color is specified.
                temp += textcolor.fgbgcolor(borderfg,borderbg,textcolor.SYMBOLS['vertical'])
            else: temp += textcolor.SYMBOLS['vertical']
            # Text inside box. Color if needed.
            # - Justify.
            if justify == 'l': line = line.strip().ljust(maxlen) # left justify (default).
            elif justify == 'c': line = line.strip().center(maxlen) # center justify.
            elif justify == 'r': line = line.strip().rjust(maxlen) # right justify.
            else: line = (line + " " * maxlen)[:maxlen] # Just pad whatever we were given.
            # - Add color.
            if textfg != None and textbg != None: # Text color is specified.
                temp += textcolor.fgbgcolor(textfg,textbg,line)
            else: temp += line
            # Vertical edge on right. Color if needed.
            if borderfg != None and borderbg != None: # Border color is specified.
                temp += textcolor.fgbgcolor(borderfg,borderbg,textcolor.SYMBOLS['vertical'])
            else: temp += textcolor.SYMBOLS['vertical']
            printlines.append(temp)
        # 3: Construct bottom of box.
        if borderfg != None and borderbg != None: # Border color is specified.
            temp = textcolor.fgbgcolor(borderfg,borderbg,textcolor.SYMBOLS['corner_bl'] + (textcolor.SYMBOLS['horizontal'] * maxlen) + textcolor.SYMBOLS['corner_br'])
            printlines.append(temp)
        else: # No colors specified.
            temp = textcolor.SYMBOLS['corner_bl'] + (textcolor.SYMBOLS['horizontal'] * maxlen) + textcolor.SYMBOLS['corner_br']
            printlines.append(temp)
        try: # Try to print with full graphics, but if character set does not allow it, print basic text instead.
            for i,line in enumerate(printlines): # Now display the whole box.
                if row != None and col != None: line = textcolor.cursor(col=col,row=row + i) + line # Add screen location (row and column).
                elif col != None: line = textcolor.cursorright(cols=col) + line # Add screen location (column only).
                textcolor.safeprint(line)
                #textcolor.safeprint(line) # This would reduce to latin1 even if the characters are utf-8
        except Exception as e: # Print simple text if the display won't allow UTF-8 characters.
            print(textcolor.red("textcolor.TextBox():",str(e)))
            for line in linelist:
                print(line)

    @staticmethod
    def ListSymbols(): # List predefined symbols. 
        """     
            Parameters ---------------------------------------
            n/a

            References ---------------------------------------
            n/a

            Sets ---------------------------------------------
            Parameters.DisplayTZ
            ObservationStatusWindow
            ImageStatusWindow
            SessionWindow

            Returns ------------------------------------------
            n/a          """
        for key,value in textcolor.SYMBOLS.items():
            print (key, value)
        
    @staticmethod
    def safetype(raw): # Make sure any value is a string.
        """     
            Parameters ---------------------------------------
            n/a

            References ---------------------------------------
            n/a

            Sets ---------------------------------------------
            Parameters.DisplayTZ
            ObservationStatusWindow
            ImageStatusWindow
            SessionWindow

            Returns ------------------------------------------
            n/a          """
        if type(raw) != type(str): raw = str(raw)
        return raw     

    @staticmethod
    def booltocolor(value,fgtrue=None,fgfalse=None): # Convert boolean value to TRUE or FALSE color.
        """ Given a boolean (or text) value, return it as colored text. 
            True values are colored fgtrue color. 
            False valuse are colored fgfalse color. 
            None values are not colored.     
            Parameters ---------------------------------------
            n/a

            References ---------------------------------------
            n/a

            Sets ---------------------------------------------
            Parameters.DisplayTZ
            ObservationStatusWindow
            ImageStatusWindow
            SessionWindow

            Returns ------------------------------------------
            n/a          """
        if fgtrue == None: fgtrue = textcolor.GREEN
        if fgfalse == None: fgfalse = textcolor.RED
        temp = str(value)
        temp = temp.replace("True",textcolor.fgbgcolor(fgtrue,textcolor.BLACK,"True"))
        temp = temp.replace("False",textcolor.fgbgcolor(fgfalse,textcolor.BLACK,"False"))
        return temp

    @staticmethod
    def dictprint(dictionary,level=0,indent=4): # Very simple equivalent to pprint to display a dictionary.
        """
        Very simple dump of dictionary content to terminal.
        Consider using pprint module instead.
        """
        indent = " " * level * 4 
        for key,value in dictionary.items():
            if type(value) == dict: textcolor.dictprint(value,level=level + 1)
            else: print(indent,key,":",value)
            
    @staticmethod
    def listtotext(arglist,sep=' '): # Convert arbitrary list of parameters into a single string.
        """ Given a list of arguments, append all of them into a single string.
            This behaves like the 'print' command for stringing together a list of items
            into a single string. All arguments are converted to 'str' type before adding
            to the output string. 
            sep parameter says what separator is inserted between each element. (default ' ')     
            Parameters ---------------------------------------
            n/a

            References ---------------------------------------
            n/a

            Sets ---------------------------------------------
            Parameters.DisplayTZ
            ObservationStatusWindow
            ImageStatusWindow
            SessionWindow

            Returns ------------------------------------------
            n/a          """
        result = ''
        for a in arglist:
            if a != '':
                if result != '': result += sep
                result += str(a)
        return result

    @staticmethod
    def ascii_only(text,substitute=''): # Strip non ASCII characters from a string.
        """ Return ONLY the ascii (0-127) characters in a string. 
            This removes unicode characters etc. 
            Parameters -------------------------------------------------------------
            text : The text string to be filtered. 
            substitute : The character to use instead of filtered characters. 
                         (Default is no character)     
            Parameters ---------------------------------------
            n/a

            References ---------------------------------------
            n/a

            Sets ---------------------------------------------
            Parameters.DisplayTZ
            ObservationStatusWindow
            ImageStatusWindow
            SessionWindow

            Returns ------------------------------------------
            n/a          """
        return ''.join([i if ord(i) < 128 else substitute for i in text])

    @staticmethod
    def neatprint(*args,**kwargs): # Equivalent of print() for early python versions.
        """ Own 'print' function. 
            Formats neatly in early Python versions.    
            Parameters ---------------------------------------
            n/a

            References ---------------------------------------
            n/a

            Sets ---------------------------------------------
            Parameters.DisplayTZ
            ObservationStatusWindow
            ImageStatusWindow
            SessionWindow

            Returns ------------------------------------------
            n/a           """
        sep = ' '
        end = '\n'
        for key,value in kwargs.items():
            if key == 'sep': sep = value
            elif key == 'end': end = value
        line = ''
        for a in args:
            a = textcolor.safetype(a)
            if len(line) > 0: line += sep
            line += a
        print(line,end=end)

    @staticmethod
    def safeprint(*args,**kwargs): # print() statement which converts string to latin1
        """ Own 'print' function. 
            Formats neatly in early Python versions, and reduces utf8 to latin1.    
            Parameters ---------------------------------------
            n/a

            References ---------------------------------------
            n/a

            Sets ---------------------------------------------
            Parameters.DisplayTZ
            ObservationStatusWindow
            ImageStatusWindow
            SessionWindow

            Returns ------------------------------------------
            n/a           """
        sep = ' '
        end = '\n'
        for key,value in kwargs.items():
            if key == 'sep': sep = value
            elif key == 'end': end = value
        line = ''
        for a in args:
            a = textcolor.safetype(a)
            if len(line) > 0: line += sep
            line += a
        _, CharSet = locale.getlocale()
        if not CharSet in ["UTF-8"]: # We cannot use utf-8 full set, reduce to simpler iso-8859-1 character set.
            line = line.encode('iso-8859-1', errors='replace').decode()
        print(line,end=end)

    @staticmethod
    def getterminalsize(): # Read terminal size (columns,rows)
        """ Return tuple of the current screen dimensions. 
              (cols,rows)    
            Parameters ---------------------------------------
            n/a

            References ---------------------------------------
            n/a

            Sets ---------------------------------------------
            Parameters.DisplayTZ

            Returns ------------------------------------------
            n/a           """
        print('textcolor.getterminalsize() is deprecated. Use textcolor.terminalsize()')
        cols = 80
        rows = 24
        cols = int(textcolor.oscommand('tput cols')[0])
        rows = int(textcolor.oscommand('tput lines')[0])
        return (cols,rows)

    @staticmethod
    def HRNumber(value,base=1000,decimals=1): # Convert number to human readable format.
        """ Given a number return a human readable text version.
            Eg, turning 1,000,000 into 1.0M 
            
            inputs :-
                value = The number to be converted.
                base = 1000. Runs in thousands.
                     = 1024. Runs in IT measurements.
                decimals = The number of decimal places to return.

            HRNumber(56312703,1000) returns :-
                result = '56.3M'
                prefix = 'mega'
                symbol = 'M' 
                    
            Parameters ---------------------------------------
            n/a

            References ---------------------------------------
            n/a

            Sets ---------------------------------------------
            Parameters.DisplayTZ
            ObservationStatusWindow
            ImageStatusWindow
            SessionWindow

            Returns ------------------------------------------
            n/a          
                """
        valdic = {'yocto':{'power':-8,'symbol':'y','name':'septillionth'},
                  'zepto':{'power':-7,'symbol':'z','name':'sextillionth'},
                  'atto' :{'power':-6,'symbol':'a','name':'quintillionth'},
                  'femto':{'power':-5,'symbol':'f','name':'quadrillionth'},
                  'pico': {'power':-4,'symbol':'p','name':'trillionth'},
                  'nano': {'power':-3,'symbol':'n','name':'billionth'},
                  'micro':{'power':-2,'symbol':'u','name':'millionth'},
                  'milli':{'power':-1,'symbol':'m','name':'thousandth'},
                  '':     {'power':0, 'symbol':'','name':''},
                  'kilo': {'power':1, 'symbol':'k','name':'thousand'},
                  'mega': {'power':2, 'symbol':'M','name':'million'},
                  'giga': {'power':3, 'symbol':'G','name':'billion'},
                  'tera': {'power':4, 'symbol':'T','name':'trillion'},
                  'peta': {'power':5, 'symbol':'P','name':'quadrillion'},
                  'exa':  {'power':6, 'symbol':'E','name':'quintillion'},
                  'zetta':{'power':7, 'symbol':'Z','name':'sextillion'},
                  'yotta':{'power':8, 'symbol':'Y','name':'septillion'}}
                  # Not used here...
                  #'centi':{'power':-2, 'symbol':'c','name':'hundredth'},
                  #'deci': {'power':-1, 'symbol':'d','name':'tenth'},
                  #'deca': {'power':1,  'symbol':'da','name':'ten'},
                  #'hecto':{'power':2,  'symbol':'h','name':'hundred'},
        # Default return values.
        result = str(value) # Default has no conversion.
        prefix = ''
        symbol = ''
        # Find better return conversion if possible.
        for key,subdict in valdic.items():
            scale = base ** subdict['power']
            ranged = round(value / scale,decimals)
            if 1.0 <= ranged < 1000: # This is a good fit.
                result = str(ranged) + subdict['symbol']
                prefix = key
                symbol = subdict['symbol']
                break
        return result, prefix, symbol

    @staticmethod
    def stripcodes(line): # Remove embedded terminal display codes from a line of text.
        """ Remove embedded terminal display codes from a line of text.
            Removes any text starting with "\033[" up to the first letter. (A-Z,a-z)    
            Parameters ---------------------------------------
            n/a

            References ---------------------------------------
            n/a

            Sets ---------------------------------------------
            Parameters.DisplayTZ
            ObservationStatusWindow
            ImageStatusWindow
            SessionWindow

            Returns ------------------------------------------
            n/a           """
        result = ''
        CodeStart = "\033["
        InCode = False
        if line is None or line == '': result = line
        else: # Need to process the characters.
            for i in range(len(line)):
                if line[i:].startswith(CodeStart): InCode = True # We've started a code sequence.
                if not InCode: # We have printable characters.
                    result += line[i]
                if InCode: # We're in a code sequence. Check for it ending.
                    if "a" <= line[i].lower() <= "z": # Code terminator.
                        InCode = False
        return result
        
    @staticmethod
    def oscommand(cmd): # Execute a command,result is returned as clean list of lines.   
        """ Execute a command,result is returned as clean list of lines.     
            Parameters ---------------------------------------
            n/a

            References ---------------------------------------
            n/a

            Sets ---------------------------------------------
            Parameters.DisplayTZ
            ObservationStatusWindow
            ImageStatusWindow
            SessionWindow

            Returns ------------------------------------------
            n/a          """
        try:
            result = subprocess.check_output(cmd,shell=True,stderr=subprocess.DEVNULL).decode('utf-8')
        except subprocess.CalledProcessError as e:
            print("textcolor.oscommand(" + cmd + ") returned " + str(e))
            print("textcolor.oscommand(" + cmd + ") returned returncode " + str(e.returncode))
            print("textcolor.oscommand(" + cmd + ") returned output " + str(e.output))
            print("textcolor.oscommand(" + cmd + ") returned cmd " + str(e.cmd))
            print("textcolor.oscommand(" + cmd + ") returned stdout " + str(e.stdout))
            print("textcolor.oscommand(" + cmd + ") returned stderr " + str(e.stderr))
            result = "" # We lose result output, even if some was generated before the error was reached.
        lines = result.split('\n')
        returnlist = []
        for line in lines:
            returnlist.append(line) # Construct clean returnlist of the output.
        return returnlist

    @staticmethod
    def GetTermType(): # Common
        """ Return the termtype and also set the global variable TermType.     
            Parameters ---------------------------------------
            n/a

            References ---------------------------------------
            n/a

            Sets ---------------------------------------------
            Parameters.DisplayTZ
            ObservationStatusWindow
            ImageStatusWindow
            SessionWindow

            Returns ------------------------------------------
            n/a          """
        textcolor.TermType = textcolor.oscommand('echo $TERM')[0]
        return textcolor.TermType

    @staticmethod
    def terminalsize(): # Common
        """ Return tuple of the current screen dimensions (in characters) = (cols,rows)    
            Parameters ---------------------------------------
            n/a

            References ---------------------------------------
            n/a

            Sets ---------------------------------------------
            Parameters.DisplayTZ

            Returns ------------------------------------------
            n/a           """
        cols = 80
        rows = 24
        cols = int(textcolor.oscommand('tput cols')[0])
        rows = int(textcolor.oscommand('tput lines')[0])
        return (cols,rows)

    @staticmethod
    def hidecursor(): # Common
        """ Make the cursor invisible.    
            Parameters ---------------------------------------
            n/a

            References ---------------------------------------
            n/a

            Sets ---------------------------------------------
            Parameters.DisplayTZ
            ObservationStatusWindow
            ImageStatusWindow
            SessionWindow

            Returns ------------------------------------------
            n/a           """
        textcolor.oscommand('tput civis')

    @staticmethod
    def showcursor(): # Common
        """ Make the cursor visible.    
            Parameters ---------------------------------------
            n/a

            References ---------------------------------------
            n/a

            Sets ---------------------------------------------
            Parameters.DisplayTZ
            ObservationStatusWindow
            ImageStatusWindow
            SessionWindow

            Returns ------------------------------------------
            n/a           """
        textcolor.oscommand('tput cnorm')

    @staticmethod
    def cursorhome():
        """     
            Parameters ---------------------------------------
            n/a

            References ---------------------------------------
            n/a

            Sets ---------------------------------------------

            Returns ------------------------------------------
            n/a          """
        return textcolor.cursor(0,0)

    @staticmethod
    def cursor(col=0,row=0):
        """     
            Parameters ---------------------------------------
            n/a

            References ---------------------------------------
            n/a

            Sets ---------------------------------------------

            Returns ------------------------------------------
            n/a          """
        return "\033[" + str(row) + ";" + str(col) + "H"

    @staticmethod
    def cursorup(rows=1):
        """     
            Parameters ---------------------------------------
            n/a

            References ---------------------------------------
            n/a

            Sets ---------------------------------------------

            Returns ------------------------------------------
            n/a          """
        return "\033[" + str(rows) + "A"

    @staticmethod
    def cursordown(rows=1):
        """     
            Parameters ---------------------------------------
            n/a

            References ---------------------------------------
            n/a

            Sets ---------------------------------------------

            Returns ------------------------------------------
            n/a          """
        return "\033[" + str(rows) + "B"

    @staticmethod
    def cursorleft(cols=1):
        """     
            Parameters ---------------------------------------
            n/a

            References ---------------------------------------
            n/a

            Sets ---------------------------------------------

            Returns ------------------------------------------
            n/a          """
        return "\033[" + str(cols) + "D"

    @staticmethod
    def cursorright(cols=1):
        """     
            Parameters ---------------------------------------
            n/a

            References ---------------------------------------
            n/a

            Sets ---------------------------------------------

            Returns ------------------------------------------
            n/a          """
        return "\033[" + str(cols) + "C"

    @staticmethod
    def nextline(rows=1):
        """     
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
        """ XTERM 256 color mode supported. 

            Parameters ---------------------------------------
            n/a

            References ---------------------------------------
            n/a

            Sets ---------------------------------------------

            Returns ------------------------------------------
            n/a          """
        if textcolor.Mode == 'simple':
            return text
        else:
            return "\033[38;5;" + str(value) + "m" + text + textcolor.reset()

    @staticmethod
    def truecolor(r,g,b,text=''):
        """ Truecolor color mode supported. 
            Parameters ---------------------------------------
            n/a

            References ---------------------------------------
            n/a

            Sets ---------------------------------------------

            Returns ------------------------------------------
            n/a          """
        if textcolor.Mode == 'simple':
            return text
        else:
            return "\033[38;2;" + str(r)+ ";" + str(g) + ";" + str(b) + "mtext\033[0m" + text + textcolor.reset()

    @staticmethod
    def bgcolor(value=0,text=''):
        """ XTERM 256 color mode supported.
            Parameters ---------------------------------------
            n/a

            References ---------------------------------------
            n/a

            Sets ---------------------------------------------

            Returns ------------------------------------------
            n/a          """
        if textcolor.Mode == 'simple':
            return text
        else:
            return "\033[48;5;" + str(value) + "m" + text + textcolor.reset()

    @staticmethod
    def rgbassign(r):
        """ change r(or g or b) value from 0.0-1.0 range into 0-5 range
            This assigns the 0-5 range more evenly depending upon the input 0.0-1.0 value.
            Parameters ---------------------------------------
            n/a

            References ---------------------------------------
            n/a

            Sets ---------------------------------------------

            Returns ------------------------------------------
            n/a          """
        #if r <= 0.167: re = 0
        #elif r <= 0.333: re = 1
        #elif r <= 0.500: re = 2
        #elif r <= 0.668: re = 3
        #elif r <= 0.833: re = 4
        #else: re = 5
        re = min(int(r // (1/6)),5)
        return re

    @staticmethod
    def rgbdecimal(r,g,b):
        """ Take rgb values (scale 0.00-1.00) and calculate nearest 215 color scheme value.

            Parameters ---------------------------------------
            n/a

            References ---------------------------------------
            n/a

            Sets ---------------------------------------------

            Returns ------------------------------------------
            n/a          """
        re = textcolor.rgbassign(r)
        ge = textcolor.rgbassign(g)
        be = textcolor.rgbassign(b)
        v = int(re * 6 * 6) + int(ge * 6) + int(be) + 16
        return v
        
    @staticmethod
    def rgbditherdecimal(r,g,b):
        """ Take rgb values (scale 0.00-1.00) and calculate 2 nearest 215 color scheme values. 
            This is to support using 'dithering' to match colors better.
            Returns 2 colors.            
            Parameters ---------------------------------------
            n/a

            References ---------------------------------------
            n/a

            Sets ---------------------------------------------

            Returns ------------------------------------------
            n/a          """
        # How close is the closest single available color?
        ri = round(r * 5) / 5 # What are the rounded r,g,b levels for input values.
        gi = round(g * 5) / 5
        bi = round(b * 5) / 5
        # What's the difference?
        rd = r - ri
        gd = g - gi
        bd = b - bi
        # Calculate colors each side of the nearest color.
        r1 = max(r - rd,0.0)
        g1 = max(g - gd,0.0)
        b1 = max(b - bd,0.0)
        r2 = min(r + rd,1.0)
        g2 = min(g + gd,1.0)
        b2 = min(b + bd,1.0)
        # Establish the TWO colors either side of the NEAREST color. When mixed is this closer to the original.
        #v1 = int(round(r1 * 5) * 6 * 6) + int(round(g1 * 5) * 6) + int(round(b1 * 5)) + 16
        #v2 = int(round(r2 * 5) * 6 * 6) + int(round(g2 * 5) * 6) + int(round(b2 * 5)) + 16
        v1 = textcolor.rgbdecimal(r1,g1,b1)
        v2 = textcolor.rgbdecimal(r2,g2,b2)
        return v1, v2
        
    @staticmethod
    def rgbpure(r,g,b):
        """ Take RGB values (scale 0-5) and calculate nearest XTERM 256 color scheme value. 
            Parameters ---------------------------------------
            n/a

            References ---------------------------------------
            n/a

            Sets ---------------------------------------------

            Returns ------------------------------------------
            n/a          """
        v = (r * 6 * 6) + (g * 6) + b + 16
        v = v % 256 # Clip for safety.
        return v

    @staticmethod
    def fgbgcolor(fg=7,bg=0,*args,sep=' ',reset=True):
        """ XTERM 256 color mode supported. 
            fg = foreground color (0-255)
            bg = background color (0-255)
            args = unlimited comma separated list of items to print.
            sep = ' ' separator placed between each argument when printed.
            if reset=True, the color is stopped at the end of the text. 
            if reset=False, the color setting remains active after the text. 
            Parameters ---------------------------------------
            n/a

            References ---------------------------------------
            n/a

            Sets ---------------------------------------------

            Returns ------------------------------------------
            n/a          """
        text = textcolor.listtotext(args,sep=sep)
        if textcolor.Mode == 'simple':
            return text
        else:
            if reset: 
                return "\033[38;5;" + str(fg) + "m" + "\033[48;5;" + str(bg) + "m" + text + textcolor.reset() # Stop using this color after the text.
            else:
                return "\033[38;5;" + str(fg) + "m" + "\033[48;5;" + str(bg) + "m" + text # Leave the color active.

    @staticmethod
    def xterm_to_rgb(n):
        """
        Convert an xterm 256 color code (0–255) to an (R, G, B) tuple.
        (Based upon AI suggested code)
        
        The 256 color table is split into 3 color ranges.
        16 standard terminal colors.
        216 r,g,b combinations.
        24 grayscale combinations.
        
            Parameters ---------------------------------------
            n (int) : XTERM color code.

            Returns ------------------------------------------
            (r,g,b) tuple of integers. """

        # --- 0–15: System colors (hard coded) ---
        system_colors = [
            (0, 0, 0),         # 0
            (128, 0, 0),       # 1
            (0, 128, 0),       # 2
            (128, 128, 0),     # 3
            (0, 0, 128),       # 4
            (128, 0, 128),     # 5
            (0, 128, 128),     # 6
            (192, 192, 192),   # 7
            (128, 128, 128),   # 8
            (255, 0, 0),       # 9
            (0, 255, 0),       # 10
            (255, 255, 0),     # 11
            (0, 0, 255),       # 12
            (255, 0, 255),     # 13
            (0, 255, 255),     # 14
            (255, 255, 255),   # 15
        ]

        if n < 16:
            return system_colors[n]

        # --- 16–231: 6×6×6 color cube ---
        if 16 <= n <= 231:
            n -= 16
            r = n // 36
            g = (n % 36) // 6
            b = n % 6

            # xterm uses this specific 6 level intensity table:
            levels = [0, 95, 135, 175, 215, 255]

            return (levels[r], levels[g], levels[b])

        # --- 232–255: Grayscale ramp ---
        if 232 <= n <= 255:
            level = 8 + (n - 232) * 10
            return (level, level, level)

        raise ValueError("textcolor.xterm_to_rgb(" + str(n) + "): Color index must be in range 0–255")

    @staticmethod
    def color_distance(c1, c2):
        """
        squared distance helper
        
        Parameters ---------------------------------------
            c1(list/tuple of 3 values):
            c2(list/tuple of 3 values):

            Returns ------------------------------------------
            measure of 'distance' between c1 and c2.
        """
        return (c1[0] - c2[0])**2 + (c1[1] - c2[1])**2 + (c1[2] - c2[2])**2

    @staticmethod
    def rgb_to_xterm(rgb):
        """
        Convert an (R, G, B) tuple (0-255 each) to the nearest xterm 256 color index (0-255).
        (Based upon AI suggested code)
        
        The 256 color table is split into 3 color ranges.
        16 standard terminal colors.
        216 r,g,b combinations.
        24 grayscale combinations.
        
            Parameters ---------------------------------------
            rgb (tuple) : (r,g,b) Channel values (0-255)

            Returns ------------------------------------------
            XTERM color (int) : 0 - 255 """

        # clamp inputs to valid range
        r = max(0, min(255, int(rgb[0])))
        g = max(0, min(255, int(rgb[1])))
        b = max(0, min(255, int(rgb[2])))

        # --- 0..15 system colors (xterm defaults) ---
        system_colors = [
            (0, 0, 0), (128, 0, 0), (0, 128, 0), (128, 128, 0),
            (0, 0, 128), (128, 0, 128), (0, 128, 128), (192, 192, 192),
            (128, 128, 128), (255, 0, 0), (0, 255, 0), (255, 255, 0),
            (0, 0, 255), (255, 0, 255), (0, 255, 255), (255, 255, 255),
        ]

        target = (r, g, b)

        # 1) Start by checking system colors
        best_index = 0
        best_dist = textcolor.color_distance(target, system_colors[0])
        for i, col in enumerate(system_colors):
            d = textcolor.color_distance(target, col)
            if d < best_dist:
                best_dist = d
                best_index = i

        # 2) Check 6x6x6 color cube (indices 16..231)
        levels = [0, 95, 135, 175, 215, 255]
        for ri in range(6):
            vr = levels[ri]
            for gi in range(6):
                vg = levels[gi]
                for bi in range(6):
                    vb = levels[bi]
                    idx = 16 + 36 * ri + 6 * gi + bi
                    d = textcolor.color_distance(target, (vr, vg, vb))
                    if d < best_dist:
                        best_dist = d
                        best_index = idx

        # 3) Check grayscale ramp (indices 232..255)
        for i in range(24):
            level = 8 + i * 10
            idx = 232 + i
            d = textcolor.color_distance(target, (level, level, level))
            if d < best_dist:
                best_dist = d
                best_index = idx

        return best_index

    @staticmethod
    def colortextline(entries,sep=" "):
        """
        Build a line of text with differing colors. 
        
            Parameters ---------------------------------------
            entries (list) : List of entries [(fg,bg,text),(fg,bg,text),...] 
            sep (str) : Separator to use between entries.

            References ---------------------------------------
            n/a

            Sets ---------------------------------------------
            n/a 
            
            Returns ------------------------------------------
            string """
        result = ""
        for fg,bg,text in entries:
            if result != "": text = sep + text
            result += textcolor.fgbgcolor(fg,bg,text)
        return result
            
    @staticmethod
    def listcolors():
        """ Display matrix all colors available on terminal.
        
            Parameters ---------------------------------------
            n/a

            References ---------------------------------------
            n/a

            Sets ---------------------------------------------
            n/a 
            
            Returns ------------------------------------------
            n/a """
        # First list on BLACK background.
        for i in range(0, 16):
            line = ""
            for j in range(0, 16):
                code = i * 16 + j
                line += textcolor.fgbgcolor(code, 0, str(code).rjust(4))
            print (line)
        # Second show BLACK characters on colored background.
        for i in range(0, 16):
            line = ""
            for j in range(0, 16):
                code = i * 16 + j
                line += textcolor.fgbgcolor(0,code, str(code).rjust(4))
            print (line)
        print (textcolor.reset())
        print (textcolor.black('Black'))
        print (textcolor.red('Red'))
        print (textcolor.green('Green'))
        print (textcolor.blue('Blue'))
        print (textcolor.yellow('Yellow'))
        print (textcolor.aqua('Aqua'))
        print (textcolor.white('White'))
        print (textcolor.magenta('Magenta'))
        print ("termtype",textcolor.GetTermType())

    @staticmethod
    def coloredlist(words,colors,sep=None,reverse=False):
        """ Return a colored string representing word list. 
            (Used for nesting labels etc)
            Level 1 / Level 2 / Level 3 / Level 4 
            
            Parameters --------------------------------------
            words (list of str) : Words to color code.
            colors (list of tuple) : FG,BG pairs to color the list with. 
            sep (str) : Optional. Separator characters to put between entries. Default is chr(0x25e4)
            reverse (bool) : Optional. When FALSE color list is used in sequence received.
                                       (If showing multiple lists, the colors match
                                        Good for listing file structures.)
                                       When TRUE color list is used in reverse sequence.
                                       (If highlighting menu location the last entry is always 1st color tuple.
                                        Good for navigating menus.)
            Result ------------------------------------------
            line (str) : color coded list """
        line = ""
        prev_bg = None
        # Make sure color list is as long as word list.
        while len(colors) < len(words): 
            colors += colors # Pad color list to match word list.
        colors = colors[:len(words)]
        # Decide how color list is applied.
        if reverse: colors.reverse() # Work backwards through the list of colors so that the latest item is always color 1 in the list.
        # Set default separator character.
        if sep == None: sep = chr(0x25e4) # Half triangle symbol
        # Construct colored list.
        if textcolor.Mode == 'simple': # Make simple uncolored list in this mode.
            for word in words:
                if line != "": line += sep # Add separator.
                line += " " + word + " " # Add text.
        else: # Use full color.
            for i,word in enumerate(words):
                fg = colors[i][0]
                bg = colors[i][1]
                if line != "": line += textcolor.fgbgcolor(prev_bg,bg,sep) # Add separator.
                line += textcolor.fgbgcolor(fg,bg," " + word + " ") # Add text.
                prev_bg = bg
        return line
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
