Kgotso-Koete/pilomar/(commit log)

2026-05-14 get pilomar working on raspberry pi 5 trixie 64 bit os 8gb
    [weatherarchive.csv]
2026-11-02 Add build docs, BOM, CHANGELOG and 3D print files
2026-11-02 Update shaft cutting strategy and use M5 bolts for lazy susan axles
